Choi-sungjin/pa_craft/presentations/GripperController 발표.pptx

## GripperController

craft_control · 코드 발표

전류 기반 파지 감지를 갖춘 그리퍼 목표 각도 제어기

src/craft_control/src/gripper_controller.cpp · 100줄

[발표자] · 2026-10-18

Notes: 오늘은 craft_control 패키지의 GripperController를 소개합니다. 100줄 정도의 작은 클래스지만, 그리퍼를 열고 닫는 목표 각도 계산과, 모터 전류로 물체를 잡았는지 판단하는 파지 감지를 함께 담당합니다.

## 명령과 피드백, 두 갈래 흐름

역할

명령 경로

/planning/gripper_command

std_msgs/Bool · true = 닫기, false = 열기

피드백 경로

arm OpenCR 피드백

gripper 각도 + gripper_current_a [A]

set_target(close)

열기/닫기 목표 각도 선택

update_current_feedback()

과전류 지속 시간 누적

compute_gripper_command()

범위로 clamp한 목표 각도

is_grasped()

물체를 잡았는지 판정

arm OpenCR

6번째(마지막) 채널로 전송

/gripper_grasped

std_msgs/Bool 발행

GripperController

2

Notes: 그리퍼 제어기는 두 갈래 흐름을 가집니다. 왼쪽 명령 경로는 planning이 Bool로 열기/닫기를 보내면 set_target이 목표 각도를 고르고, 제어 루프가 compute_gripper_command로 각도를 계산해 arm OpenCR의 마지막 채널로 보냅니다. 오른쪽 피드백 경로는 OpenCR이 보내는 그리퍼 전류를 누적해서 물체를 잡았는지 판단하고, 그 결과를 /gripper_grasped로 발행합니다. 클래스 자체는 ROS 의존성이 없는 순수 C++이고, 토픽과 시리얼 처리는 모두 control_master가 맡습니다.

## 메서드 7개, ROS 의존성 없음

공개 API

메서드

역할

호출하는 곳

configure(…)

set_target(close)

각도 범위·목표·감지 파라미터 검증 후 저장

열기/닫기 목표 각도 선택

노드 생성자

구독 콜백

compute_gripper_command(angle)

모터로 보낼 목표 각도 계산

제어 루프

update_current_feedback(I, dt)

is_grasped()

과전류 지속 시간 누적

파지 여부 조회

제어 루프

제어 루프

grasp_detection_configured()

파지 감지 활성 여부

생성자 (경고 로그)

is_target_reached(angle, tol)

목표 각도 도달 판정

아직 미사용

GripperController

3

Notes: 공개 메서드는 7개입니다. configure로 한 번 설정하고, set_target으로 목표를 바꾸고, 제어 루프에서 compute_gripper_command, update_current_feedback, is_grasped를 매 주기 호출하는 구조입니다. is_target_reached는 구현돼 있지만 control_master에서는 아직 호출하지 않습니다. 헤더에 include가 하나도 없을 만큼 ROS와 분리돼 있어서 단위 테스트하기 쉽습니다.

## 잘못된 설정은 시작 단계에서 막는다

configure()

검증 규칙

- 6개 입력 모두 유한한 값 (NaN, inf 거부)
- min_angle < max_angle
- open_angle, close_angle은 [min, max] 안
- threshold ≥ 0, debounce ≥ 0
- 감지 파라미터는 둘 다 0(비활성) 또는 둘 다 > 0(활성)

→ 한쪽만 0인 “반쯤 켜진” 감지 설정은 거부

실패하면

configure()가 false를 반환하고, control_master가 runtime_error로 노드 기동을 중단

상태부터 초기화

검증 전에 configured_ = false, has_target_ = false. 실패해도 이전 설정이 남지 않음

GripperController

4

Notes: configure는 YAML 파라미터 6개를 받아 검증합니다. 모든 값이 유한해야 하고, 최소 각도가 최대 각도보다 작아야 하며, 열기/닫기 각도는 그 범위 안에 있어야 합니다. 흥미로운 규칙은 마지막인데, 전류 임계값과 debounce 시간은 둘 다 0이면 감지 비활성, 둘 다 양수면 활성이고, 한쪽만 설정된 경우는 실수로 보고 거부합니다. 또 검증 전에 configured_ 플래그를 먼저 false로 내려서, 실패했을 때 예전 값으로 계속 동작하는 일이 없습니다. 실패하면 control_master가 예외를 던져 노드가 아예 뜨지 않습니다.

## 방향이 바뀔 때만 감지 상태를 리셋

set_target()

bool set_target(bool close)
{
if (!configured_) {
return false;
}
if (!has_target_ || closing_ != close) {
overcurrent_time_ = 0.0;
grasped_ = false;
}
target_angle_ = close ? close_angle_
: open_angle_;
closing_ = close;
has_target_ = true;
return true;
}

첫 목표 / 방향 전환

과전류 누적 시간과 grasped를 0으로 리셋

같은 명령 반복

상태 유지. planning이 “닫기”를 계속 보내도 grasped가 깜빡이지 않음

설정 전 호출

false 반환 → 구독 콜백이 경고 로그

GripperController

5

Notes: set_target은 Bool 하나를 받아 열기 각도나 닫기 각도 중 하나를 목표로 정합니다. 핵심은 주황색 부분입니다. 처음 목표가 들어오거나 열기에서 닫기처럼 방향이 바뀔 때만 파지 감지 상태를 리셋합니다. 그래서 planning이 같은 닫기 명령을 주기적으로 계속 보내더라도, 이미 잡았다고 판단한 상태가 매번 초기화되지 않습니다.

## 모르면 제자리, 알면 범위 안으로

각도 명령

compute_gripper_command()

if (!configured_) return current;
req = has_target_ ? target_angle_
: current;
return clamp(req, min_, max_);

- 설정 전 → 현재 각도 그대로
- 목표 없음 → 현재 각도 (움직이지 않음)
- 항상 [min, max]로 clamp

is_target_reached()

|angle − target_angle_| ≤ tol

- 설정 전 · 목표 없음 → false
- NaN 각도, 음수 tol → false
- control_master에서 아직 호출하지 않음

GripperController

6

Notes: 모터로 보낼 각도를 계산하는 부분입니다. 설정이 안 됐거나 아직 목표가 없으면 현재 측정 각도를 그대로 돌려줍니다. 즉 모르는 상황에서는 그리퍼가 움직이지 않습니다. 목표가 있으면 항상 최소·최대 각도로 clamp해서 범위를 넘는 명령이 나가지 않게 합니다. 오른쪽 is_target_reached는 허용 오차 안에 들어왔는지 판단하는 함수인데, 잘못된 입력은 모두 false로 처리하고, 현재는 제어 루프에서 사용하지 않습니다.

## 과전류가 debounce 이상 지속되면 “잡았다”

update_current_feedback()

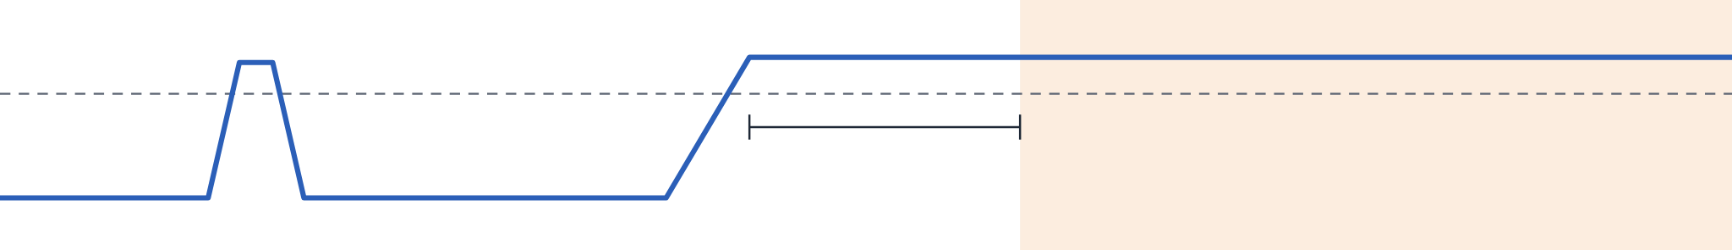
[picture p1: figure]
모터 전류 그래프: 짧은 스파이크는 무시되고, 임계값을 debounce 시간 이상 넘으면 grasped가 참이 된다

짧은 스파이크

threshold

debounce

grasped = true

시간 →

짧은 스파이크

누적 < debounce → 무시
(기동 전류 같은 순간 피크)

지속 과전류

overcurrent_time_ += dt
≥ debounce → grasped = true

임계 아래로 하락

누적 0으로 리셋
grasped 즉시 false

감지 조건: 닫는 중 · 감지 활성 · 전류와 dt가 유한 · dt > 0 (아니면 아무것도 안 함)

GripperController

7

Notes: 이 클래스에서 가장 중요한 로직입니다. 그리퍼가 물체를 잡으면 더 닫히지 못하고 모터 전류가 올라갑니다. 그래서 전류 절댓값이 임계값 이상인 시간을 dt씩 누적하고, 누적 시간이 debounce 이상이 되면 잡았다고 판단합니다. 그래프 왼쪽처럼 모터 기동 순간의 짧은 피크는 debounce를 못 넘기 때문에 무시됩니다. 전류가 임계값 아래로 떨어지면 누적 시간과 grasped를 즉시 리셋합니다. 이 감지는 닫는 중이고, 감지가 활성화돼 있고, 입력이 유효할 때만 동작합니다.

## 20 ms 제어 주기 안에서의 호출 순서

control_master 통합

구독 콜백 (비동기)

/planning/gripper_command 수신 → gripper_mapping_confirmed일 때만 set_target()

0

1

2

3

read_arm_feedback()

CSV 8개 값: state, LM, 관절 4개, gripper 각도, gripper 전류

새 피드백이 있을 때만

update_current_feedback(I, dt) → is_grasped()를 /gripper_grasped로 발행

매 주기

compute_gripper_command(gripper_angle_) → arm OpenCR에 LM, 관절 4개와 함께 전송

GripperController

8

Notes: control_master에서 어떻게 쓰이는지 보겠습니다. 명령은 구독 콜백에서 들어오는데, gripper_mapping_confirmed 파라미터가 false면 아예 무시합니다. 하드웨어 채널 매핑이 확인되기 전까지 그리퍼가 움직이지 않게 하는 안전장치입니다. 제어 루프는 arm OpenCR 피드백을 읽고, 새 피드백이 있을 때만 전류를 넣어 파지 상태를 갱신해 발행합니다. 마지막으로 그리퍼 목표 각도를 계산해 LM, 관절 4개와 함께 한 줄로 OpenCR에 보냅니다. 그리퍼 제어기는 다른 제어기와 독립적이고, 시리얼 채널만 공유합니다.

## 코드는 준비, 하드웨어 보정 대기 중

현재 상태

control.yaml 현재 값

gripper_min/max_angle

±3.14

임시 범위

확인할 점

- arm 피드백은 정확히 8개 값이어야 함. 펌웨어가 전류를 아직 안 보내면 피드백 전체가 거부됨
- dt는 루프 주기 기준. 피드백이 매 주기 오지 않으면 과전류 시간이 짧게 누적됨
- GripperController 단위 테스트 없음
- is_target_reached() 미사용

gripper_open/close_angle

0 / 0

미측정

gripper_mapping_confirmed

grasp_current_threshold_a

false

0.0

명령 무시

감지 비활성

grasp_current_debounce

0.0

감지 비활성

GripperController

9

Notes: 현재 설정 상태입니다. 열기·닫기 각도가 둘 다 0이고 매핑 확인 플래그가 false라서, 지금은 그리퍼 명령이 실제로 나가지 않습니다. 전류 감지 파라미터도 0이라 감지가 꺼져 있습니다. 하드웨어 측정 후 값을 채우는 것이 다음 단계입니다. 오른쪽은 코드를 읽으며 확인이 필요하다고 본 부분입니다. 첫째, control_master는 arm 피드백 줄에 정확히 8개 값을 요구하는데, YAML 주석에는 전류 값을 아직 펌웨어에 추가해야 한다는 TODO가 있습니다. 펌웨어가 7개만 보내면 arm 피드백 전체가 버려집니다. 둘째, update_current_feedback에 루프 dt를 넘기는데 호출은 새 피드백이 있을 때만 하므로, 피드백이 띄엄띄엄 오면 누적 시간이 실제보다 짧아집니다. 셋째, 테스트 파일에 그리퍼 테스트가 아직 없습니다.

## 작지만 안전하게 설계된 제어기

정리

검증 우선

잘못된 설정은 노드 기동 단계에서 차단

안전한 기본값

모르면 현재 위치 유지, 항상 범위 안으로 clamp

노이즈에 강한 감지

과전류 지속 시간으로 파지 판정

Q&A

GripperController

10

Notes: 정리하면 세 가지입니다. 설정은 시작할 때 엄격하게 검증하고, 모르는 상황에서는 움직이지 않으며, 파지 감지는 순간 피크가 아닌 지속 시간으로 판단합니다. 다음 단계는 하드웨어 측정으로 각도와 전류 임계값을 채우고, 그리퍼 단위 테스트를 추가하는 것입니다. 질문 받겠습니다.
