Choi-sungjin/pa_craft/presentations/longitudinal_controller_presentation.pptx

longitudinal_controller.cpp

차체 목표 속도를 좌우 바퀴 각속도로 변환

craft_control 코드 발표

Notes: 이 파일은 직진 성분의 바퀴 속도를 계산한다. 실제 회전 성분은 LateralController가 뒤에서 더한다.

코드 근거:
src/craft_control/src/longitudinal_controller.cpp
src/craft_control/src/control_master.cpp:636-649

## Slide 2

01 역할

입력과 출력

목표 차체 속도

좌우 바퀴 각속도

target_v [m/s]

{left, right} [rad/s]

전진은 양수, 후진은 음수

직진 성분이므로 두 값은 같음

설정값: wheel_radius [m], max_v [m/s]

configure()가 두 값을 저장하고, compute_command()가 변환에 사용

Notes: 입력 target_v_는 목표 차체 선속도다. 출력은 좌우 바퀴의 각속도 배열이다. 이 클래스는 동일한 좌우 값을 만들어 직진 성분만 담당한다. 설정의 기본값은 반지름 0.033m, 최대 차체 속도 0.26m/s다.

코드 근거:
src/craft_control/include/craft_control/longitudinal_controller.hpp:9-28
src/craft_control/config/control.yaml:13-15

## Slide 3

02 핵심 계산

속도 제한과 단위 변환

limited_v = clamp(target_v, -max_v, max_v)

wheel_speed = limited_v / wheel_radius

return {wheel_speed, wheel_speed}

설정 예시

목표 1.00 m/s → 제한 0.26 m/s

0.26 ÷ 0.033 ≈ 7.88 rad/s (좌우 동일)

Notes: std::clamp는 목표 선속도를 -max_v부터 +max_v까지 제한한다. 바퀴 반지름으로 나누면 선속도 m/s가 바퀴 각속도 rad/s로 바뀐다. 목표 1m/s는 기본 최대 속도 0.26m/s로 제한되므로 약 7.88rad/s가 된다. 계산값은 반올림했다.

코드 근거:
src/craft_control/src/longitudinal_controller.cpp:29-35
src/craft_control/config/control.yaml:13-15

## Slide 4

03 코드 읽기

함수별 동작

configure(radius, max_v)

is_valid_target(v)

set_target(v)

clear_target()

compute_command()

바퀴 반지름과 최대 속도를 저장

NaN·무한대가 아닌 유한한 수인지 확인

목표 속도를 저장

목표 속도를 0으로 초기화

제한·변환 후 {왼쪽, 오른쪽} 반환

Notes: is_valid_target는 std::isfinite만 검사한다. set_target 자체에는 검사 코드가 없으므로 ControlMaster가 먼저 유효성을 검사하는 흐름이다. clear_target은 저장값을 0으로 만든다.

코드 근거:
src/craft_control/src/longitudinal_controller.cpp:9-35
src/craft_control/src/control_master.cpp:426-445

## Slide 5

04 시스템 흐름

ControlMaster와의 연결

1 /planning/target_v에서 목표 선속도 수신

2 유한한 값인지 검사하고 목표값 저장

3 경로를 추종할 수 있으면 set_target(), 아니면 clear_target()

4 compute_command()로 좌우 직진 성분 계산

5 LateralController의 회전 성분을 더한 뒤 바퀴 한계 적용

6 최종 바퀴 명령을 OpenCR로 전송

Notes: LongitudinalController는 최종 바퀴 명령 전체를 혼자 만들지 않는다. ControlMaster가 경로 추종 가능 여부를 확인하고, 직진 성분을 계산한 후 LateralController의 회전 성분을 더한다. 이후 max_wheel_을 넘으면 양쪽을 같은 비율로 줄여 OpenCR에 보낸다.

코드 근거:
src/craft_control/src/control_master.cpp:237-239
src/craft_control/src/control_master.cpp:426-445
src/craft_control/src/control_master.cpp:636-651

## Slide 6

05 정리

발표에서 짚을 구현 범위

직진 성분

좌우에 같은 속도를 준다. 회전 계산은 별도 컨트롤러가 맡는다.

정지 조건

경로가 유효하지 않거나 목표에 도착하면 ControlMaster가 목표를 0으로 지운다.

모터 제어

가속 프로파일·속도 PID는 OpenCR과 DYNAMIXEL 쪽 책임이다.

Notes: 이 클래스는 목표값 제한과 단위 변환만 수행한다. 가속 램프나 PID는 이 파일에 없다. 코드와 README에 따르면 OpenCR 펌웨어 및 DYNAMIXEL이 속도 추종과 가속 프로파일을 담당한다. 테스트는 목표 1.0m/s를 0.26m/s로 제한하는 경우, 좌우 동일, clear_target 후 0을 확인한다.

코드 근거:
src/craft_control/src/longitudinal_controller.cpp:29-35
src/craft_control/include/craft_control/longitudinal_controller.hpp:1-3
src/craft_control/src/control_master.cpp:636-651
src/craft_control/test/test_control_controllers.cpp:300-318
