Choi-sungjin/pa_craft/demo/corner/planned_paths.png

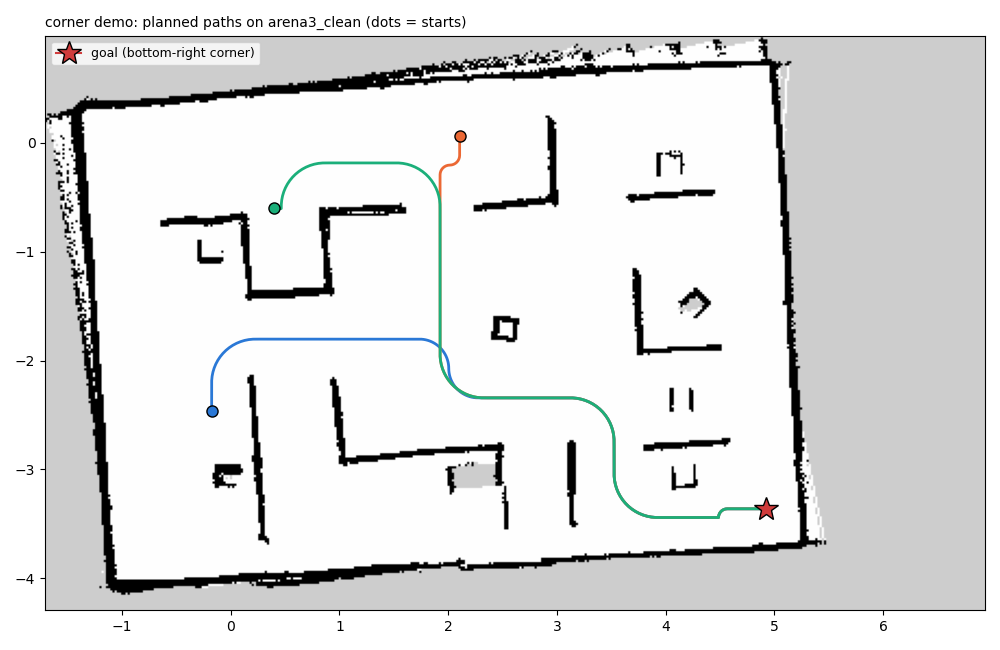
demo/corner/planned_paths.png
