Choi-sungjin/pa_craft/src/craft_planning/maps/maze.stl

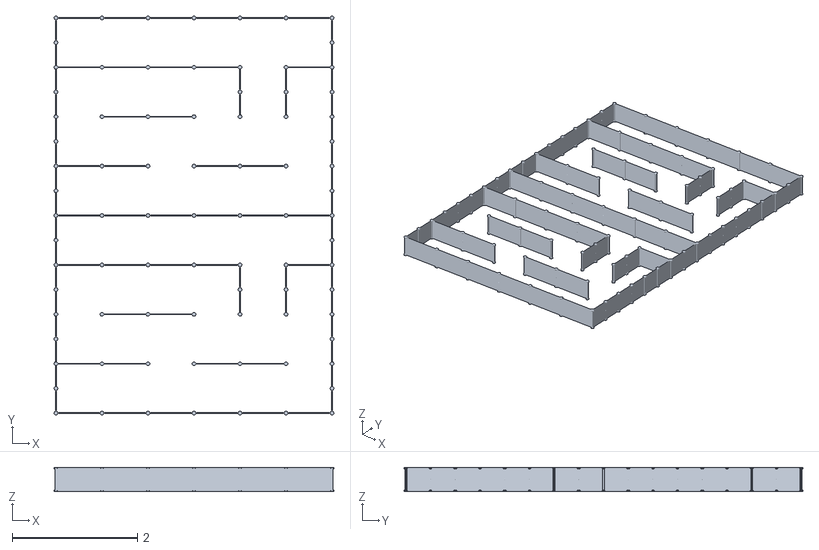
[picture p3: CAD file, 2026-10-18]
src/craft_planning/maps/maze.stl
4.46 x 6.36 x 0.39
