Choi-sungjin/pa_craft/src/craft_planning/v75_ws/src/v75_robot_description/meshes/jaw_lower_link_black.stl

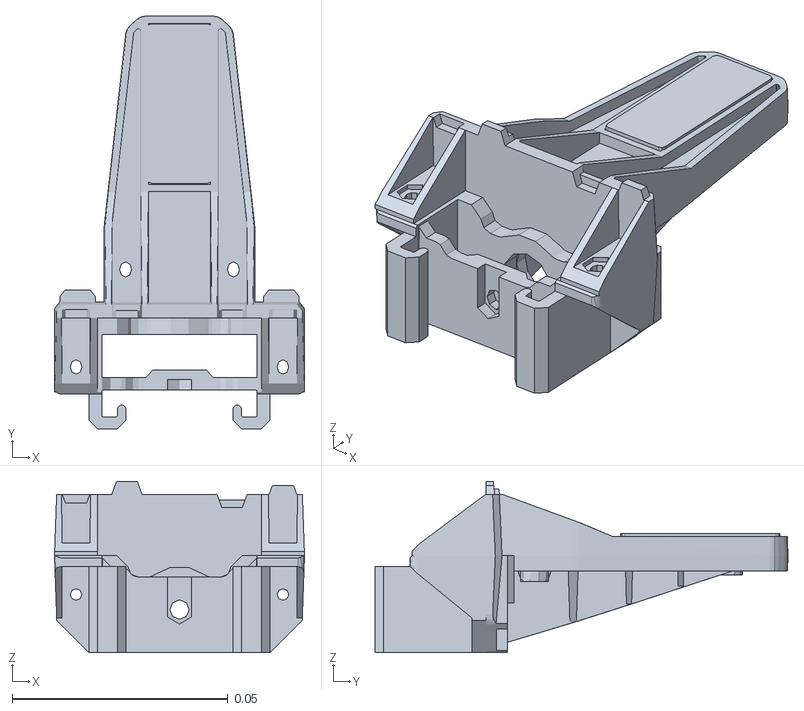
[picture p4: CAD file, 2026-11-11]
src/craft_planning/v75_ws/src/v75_robot_description/meshes/jaw_lower_link_black.stl
0.058 x 0.0958 x 0.0397
