Choi-sungjin/pa_craft/src/craft_planning/v75_ws/src/v75_robot_description/meshes/jaw_lower_link_orange.stl

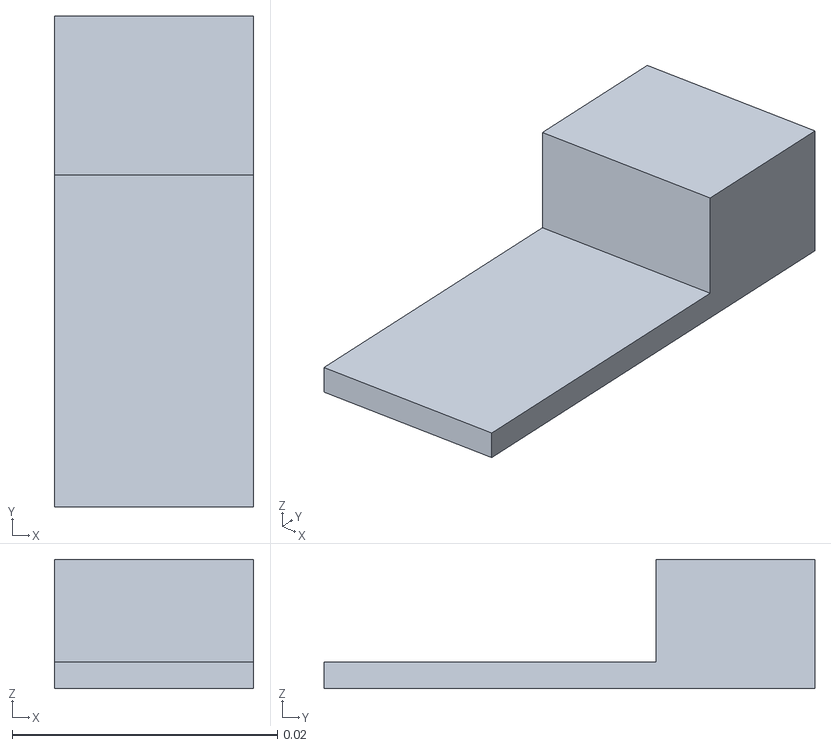
[picture p5: CAD file, 2026-11-11]
src/craft_planning/v75_ws/src/v75_robot_description/meshes/jaw_lower_link_orange.stl
0.015 x 0.037 x 0.00975
