Choi-sungjin/pa_craft/src/craft_planning/v75_ws/src/v75_robot_description/meshes/shoulder_link_green.stl

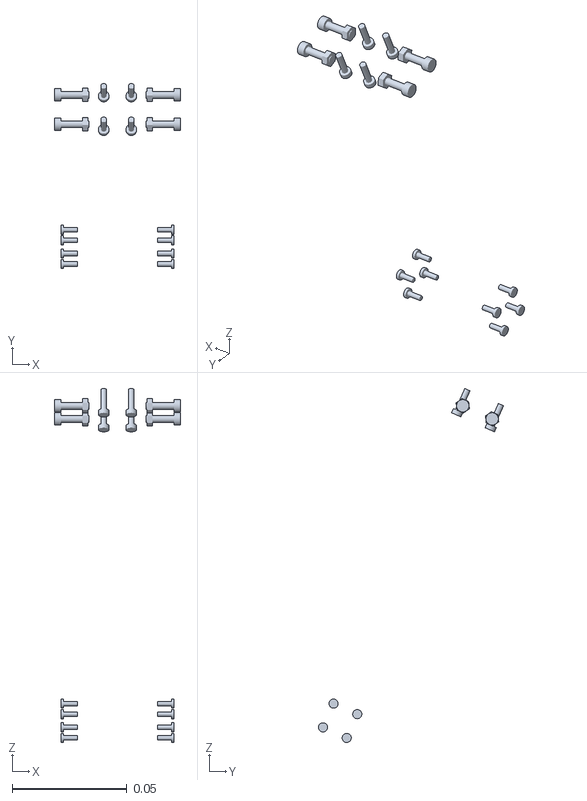
[picture p6: CAD file, 2026-11-11]
src/craft_planning/v75_ws/src/v75_robot_description/meshes/shoulder_link_green.stl
0.055 x 0.0807 x 0.154
