Choi-sungjin/pa_craft/src/craft_planning/v75_ws/src/v75_robot_description/meshes/base_link_orange.stl

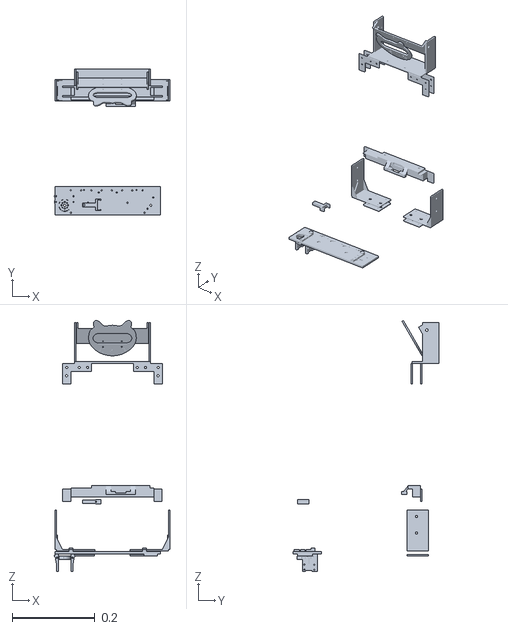
[picture p7: CAD file, 2026-11-11]
src/craft_planning/v75_ws/src/v75_robot_description/meshes/base_link_orange.stl
0.279 x 0.354 x 0.607
