Choi-sungjin/pa_craft/src/craft_planning/v75_ws/src/v75_robot_description/meshes/base_link_green.stl

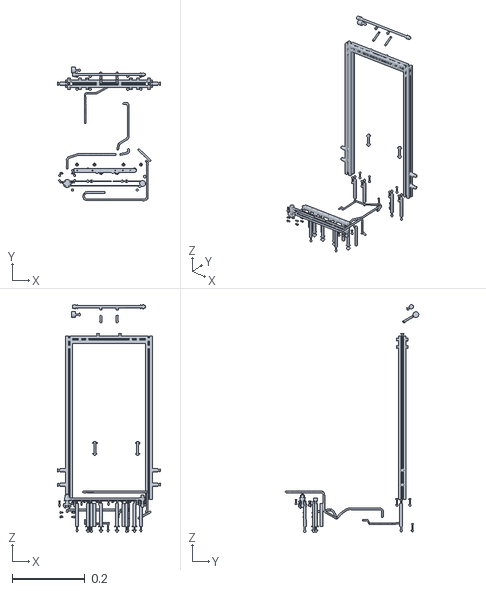
[picture p8: CAD file, 2026-11-11]
src/craft_planning/v75_ws/src/v75_robot_description/meshes/base_link_green.stl
0.283 x 0.368 x 0.628
