Choi-sungjin/pa_craft/src/craft_planning/v75_ws/src/v75_robot_description/meshes/base_link_black.stl

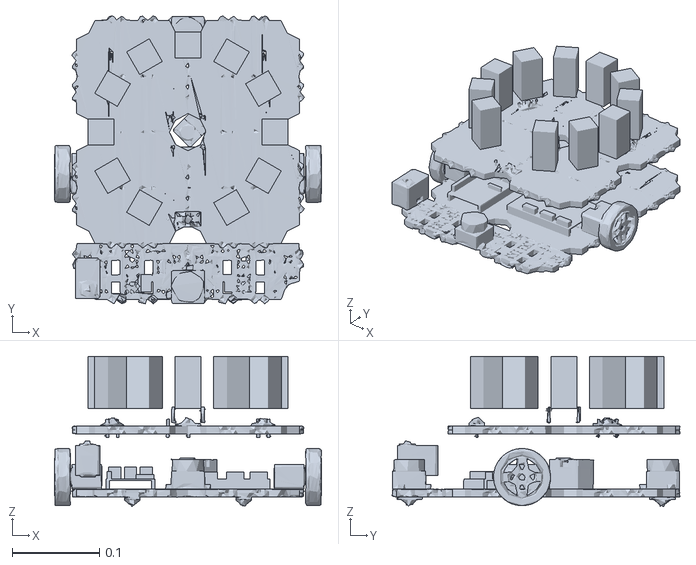
[picture p9: CAD file, 2026-11-11]
src/craft_planning/v75_ws/src/v75_robot_description/meshes/base_link_black.stl
0.306 x 0.33 x 0.173
