Choi-sungjin/pa_craft/src/craft_planning/v75_ws/src/v75_robot_description/meshes/shoulder_link_black.stl

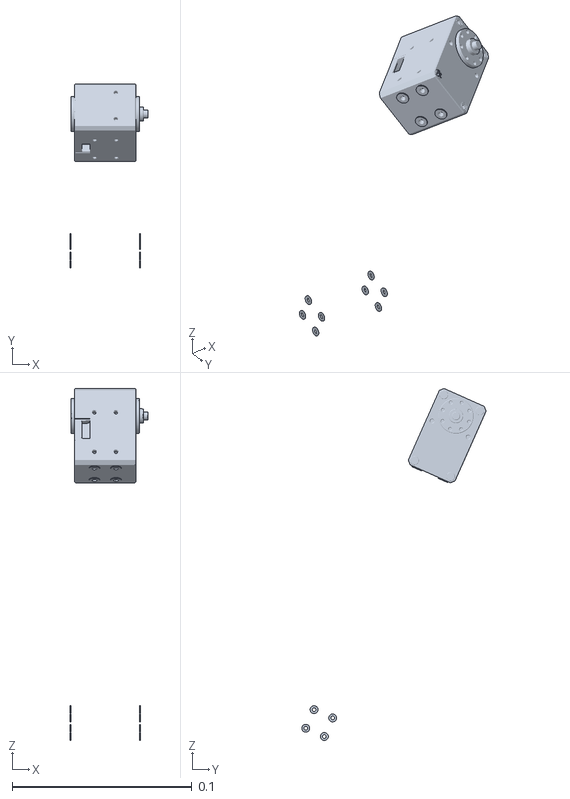
[picture p10: CAD file, 2026-11-11]
src/craft_planning/v75_ws/src/v75_robot_description/meshes/shoulder_link_black.stl
0.0432 x 0.103 x 0.196
