Choi-sungjin/pa_craft/src/craft_planning/v75_ws/src/v75_robot_description/meshes/wrist_pitch_link_black.stl

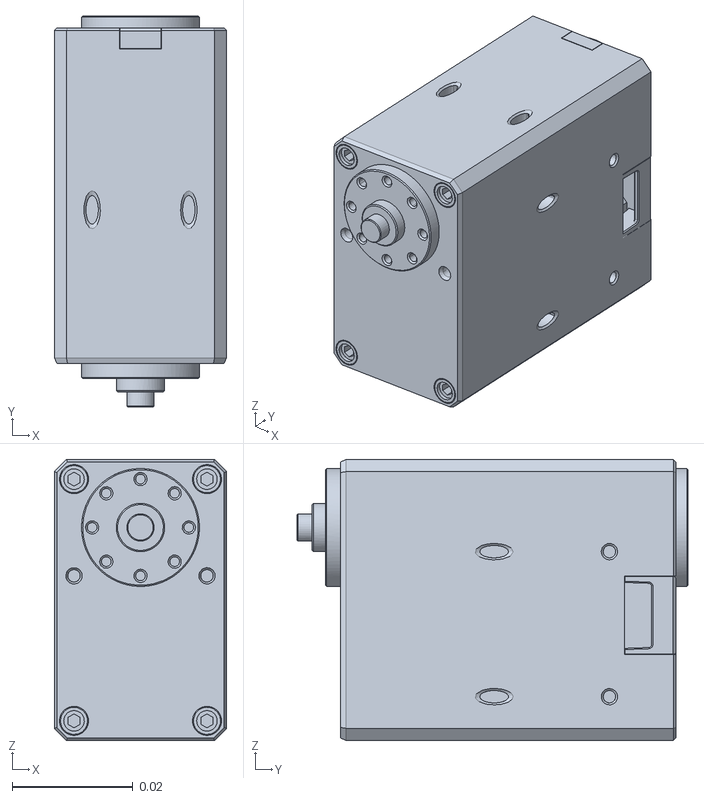
[picture p11: CAD file, 2026-11-11]
src/craft_planning/v75_ws/src/v75_robot_description/meshes/wrist_pitch_link_black.stl
0.0285 x 0.0647 x 0.0465
