Choi-sungjin/pa_craft/src/craft_planning/v75_ws/src/v75_robot_description/meshes/wrist_pitch_link_orange.stl

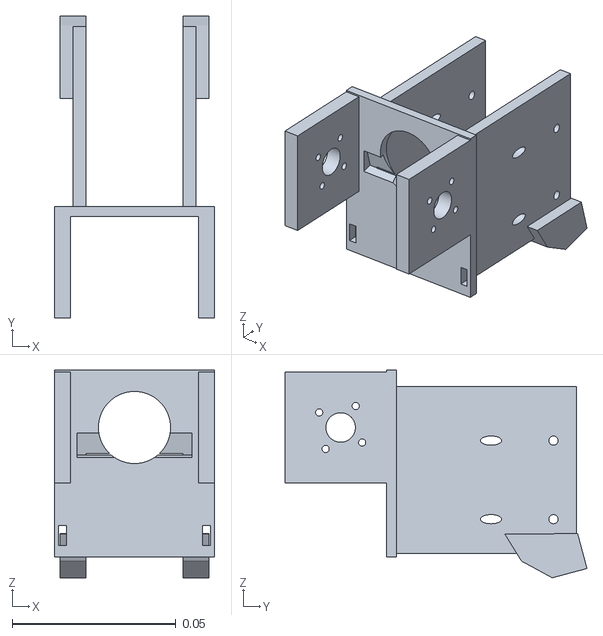
[picture p12: CAD file, 2026-11-11]
src/craft_planning/v75_ws/src/v75_robot_description/meshes/wrist_pitch_link_orange.stl
0.049 x 0.0922 x 0.0634
