Choi-sungjin/pa_craft/src/craft_planning/v75_ws/src/v75_robot_description/meshes/elbow_link_black.stl

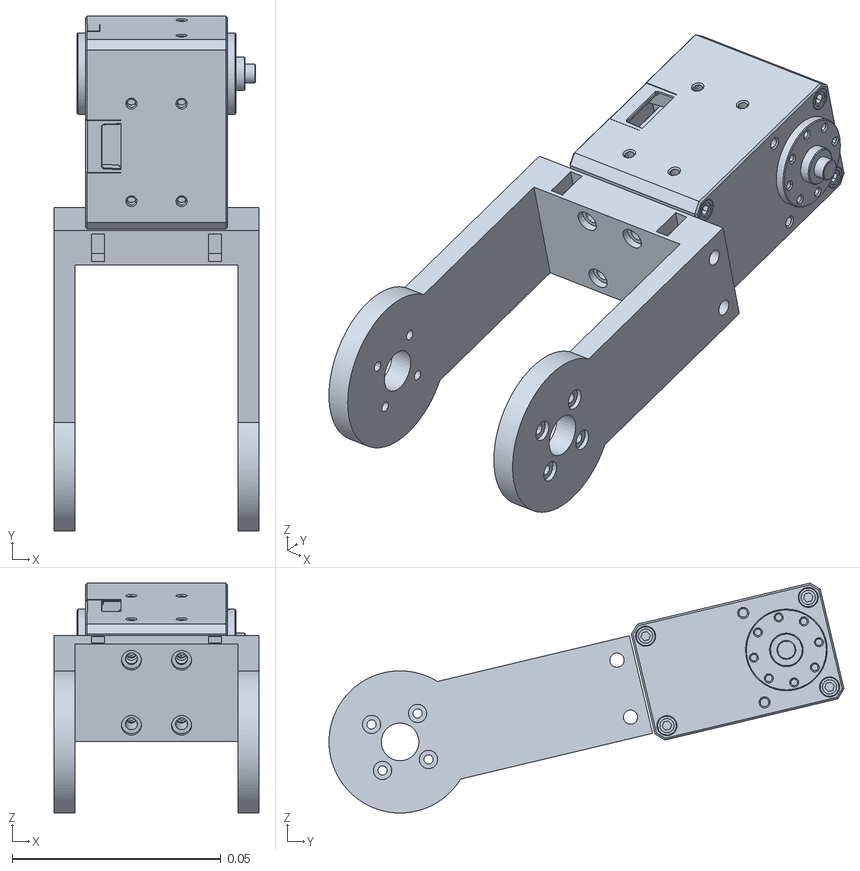
[picture p13: CAD file, 2026-11-11]
src/craft_planning/v75_ws/src/v75_robot_description/meshes/elbow_link_black.stl
0.049 x 0.123 x 0.055
