Choi-sungjin/pa_craft/src/craft_planning/v75_ws/src/v75_robot_description/meshes/slide_link_orange.stl

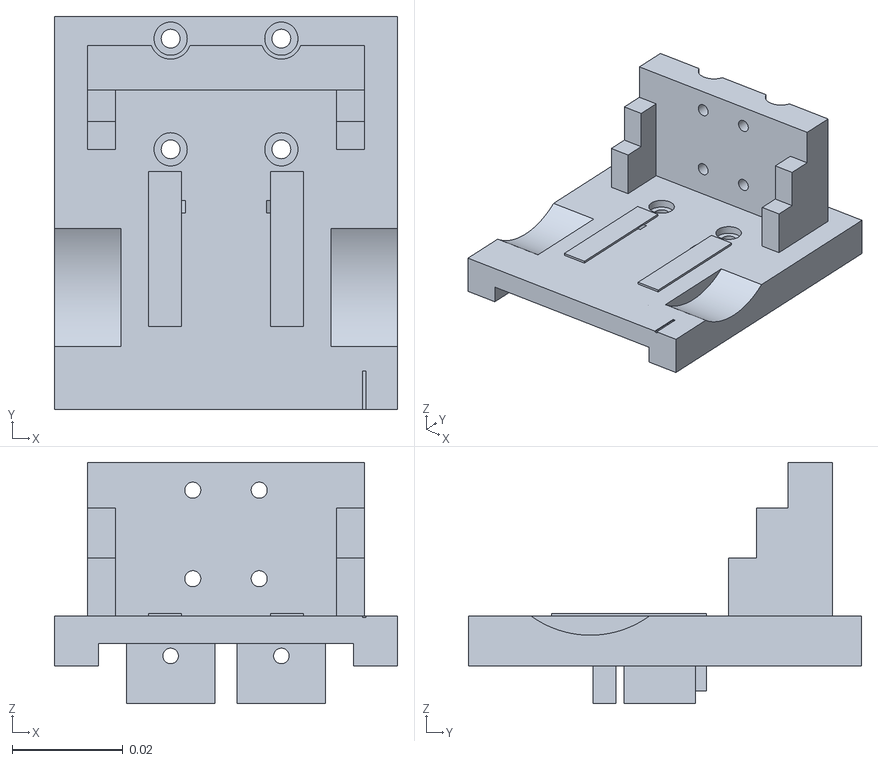
[picture p15: CAD file, 2026-10-22]
src/craft_planning/v75_ws/src/v75_robot_description/meshes/slide_link_orange.stl
0.062 x 0.071 x 0.0435
