Choi-sungjin/pa_craft/src/craft_planning/v75_ws/src/v75_robot_description/meshes/carousel_link_orange.stl

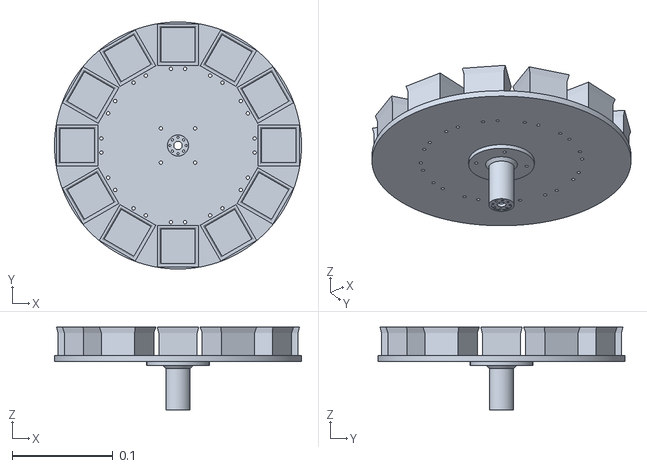
[picture p16: CAD file, 2026-10-22]
src/craft_planning/v75_ws/src/v75_robot_description/meshes/carousel_link_orange.stl
0.245 x 0.245 x 0.0821
