Choi-sungjin/pa_craft/src/craft_planning/v75_ws/src/v75_robot_description/meshes/knob_link_red.stl

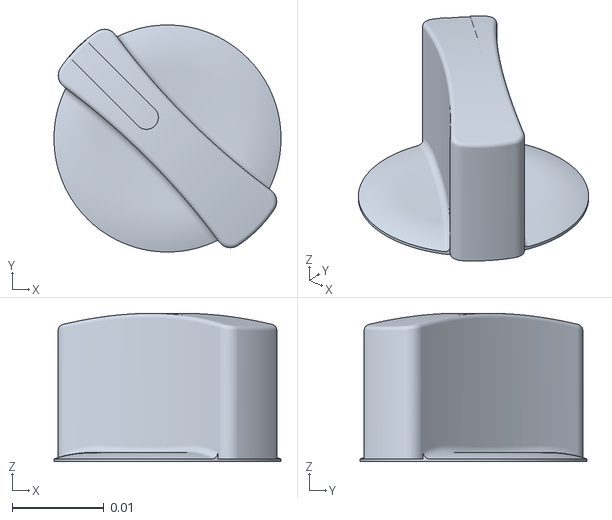
[picture p17: CAD file, 2026-10-22]
src/craft_planning/v75_ws/src/v75_robot_description/meshes/knob_link_red.stl
0.0248 x 0.0248 x 0.0162
