Choi-sungjin/pa_craft/src/craft_planning/v75_ws/src/v75_robot_description/meshes/slide_link_green.stl

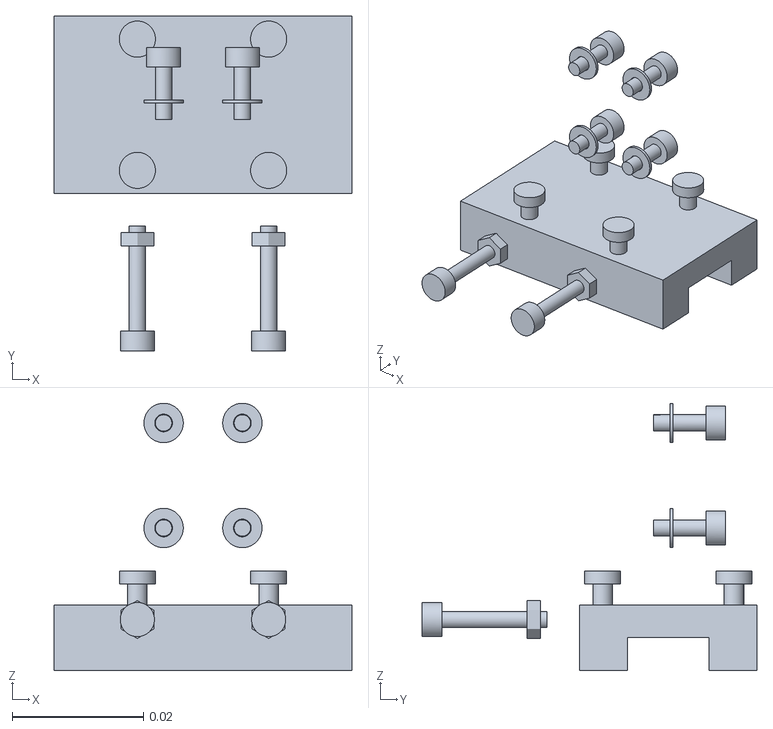
[picture p18: CAD file, 2026-10-22]
src/craft_planning/v75_ws/src/v75_robot_description/meshes/slide_link_green.stl
0.0454 x 0.051 x 0.0407
