Choi-sungjin/pa_craft/src/craft_planning/v75_ws/src/v75_robot_description/meshes/tool_roll_link_black.stl

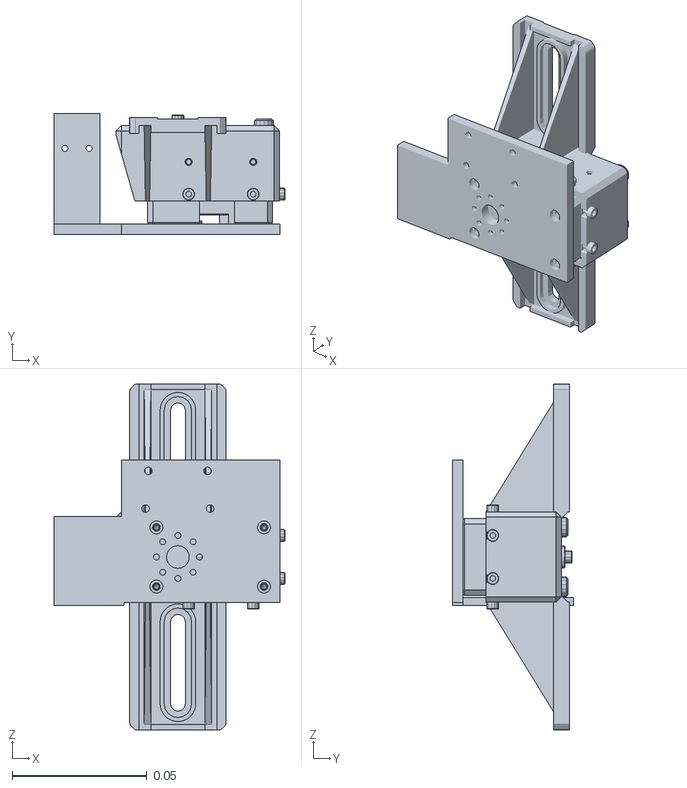
[picture p19: CAD file, 2026-10-22]
src/craft_planning/v75_ws/src/v75_robot_description/meshes/tool_roll_link_black.stl
0.0857 x 0.045 x 0.129
