Choi-sungjin/pa_craft/src/craft_planning/v75_ws/src/v75_robot_description/meshes/tool_roll_link_green.stl

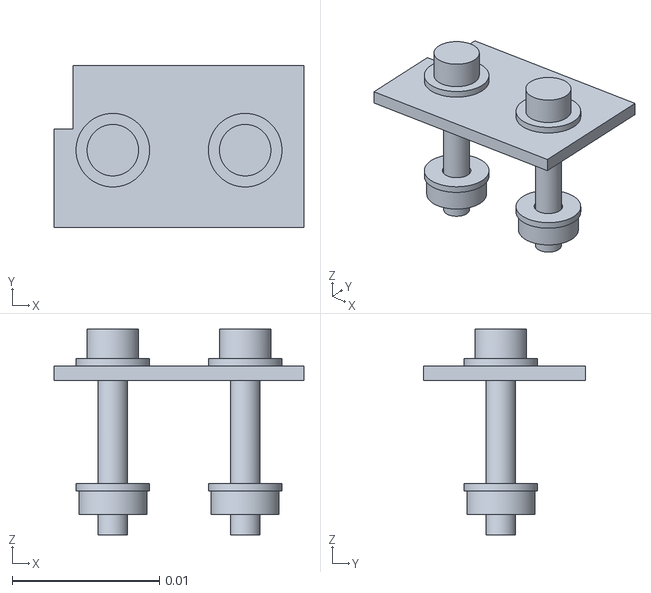
[picture p20: CAD file, 2026-10-22]
src/craft_planning/v75_ws/src/v75_robot_description/meshes/tool_roll_link_green.stl
0.017 x 0.011 x 0.014
