Choi-sungjin/pa_craft/src/craft_planning/v75_ws/src/v75_robot_description/meshes/tool_roll_link_orange.stl

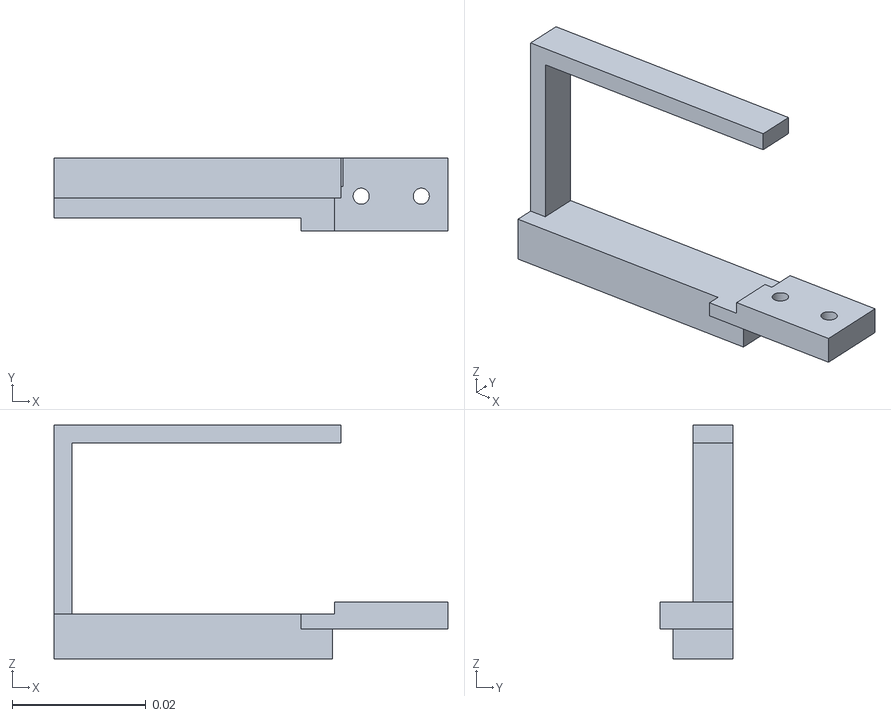
[picture p21: CAD file, 2026-10-22]
src/craft_planning/v75_ws/src/v75_robot_description/meshes/tool_roll_link_orange.stl
0.059 x 0.011 x 0.035
