Choi-sungjin/pa_craft/src/craft_planning/v75_ws/src/v75_robot_description/meshes/slide_link_gray.stl

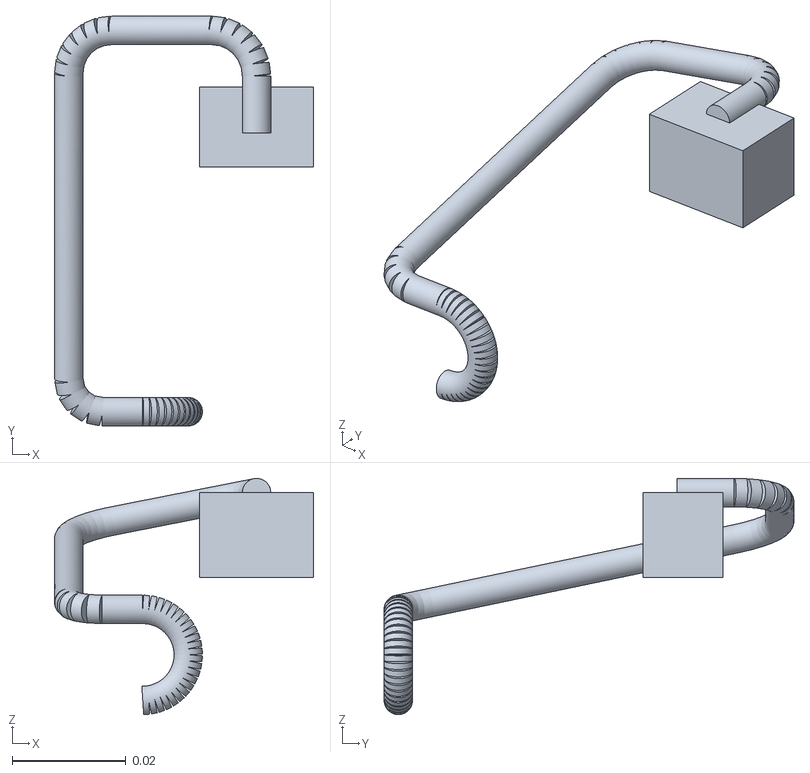
[picture p22: CAD file, 2026-10-22]
src/craft_planning/v75_ws/src/v75_robot_description/meshes/slide_link_gray.stl
0.0455 x 0.072 x 0.0415
