Choi-sungjin/pa_craft/src/craft_planning/v75_ws/src/v75_robot_description/meshes/slide_link_black.stl

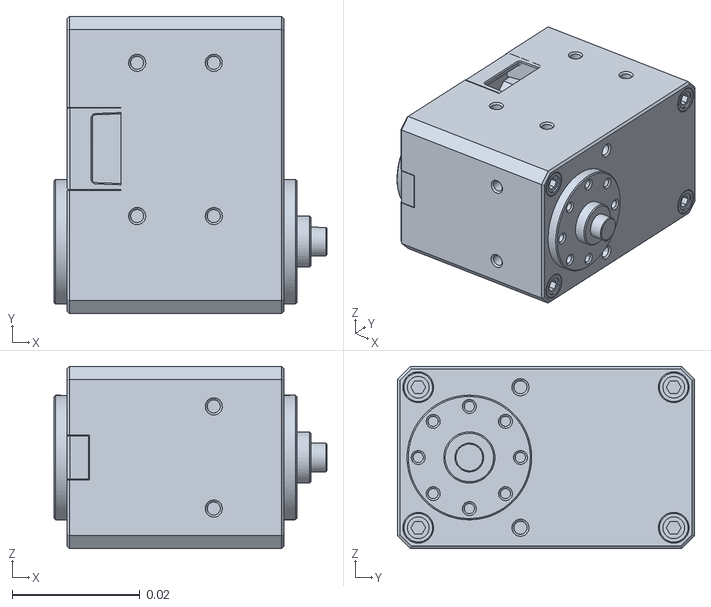
[picture p23: CAD file, 2026-10-22]
src/craft_planning/v75_ws/src/v75_robot_description/meshes/slide_link_black.stl
0.0427 x 0.0465 x 0.0285
