Choi-sungjin/pa_craft/src/craft_planning/v75_ws/src/v75_robot_description/meshes/base_link_yellow.stl

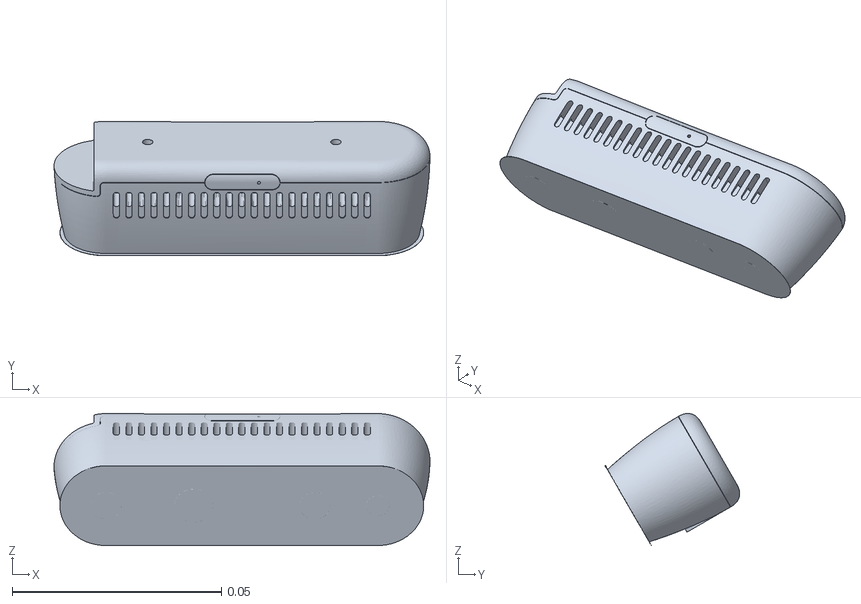
[picture p24: CAD file, 2026-10-22]
src/craft_planning/v75_ws/src/v75_robot_description/meshes/base_link_yellow.stl
0.0899 x 0.0322 x 0.0316
