Choi-sungjin/pa_craft/src/craft_planning/v75_ws/src/v75_robot_description/meshes/carousel_link_black.stl

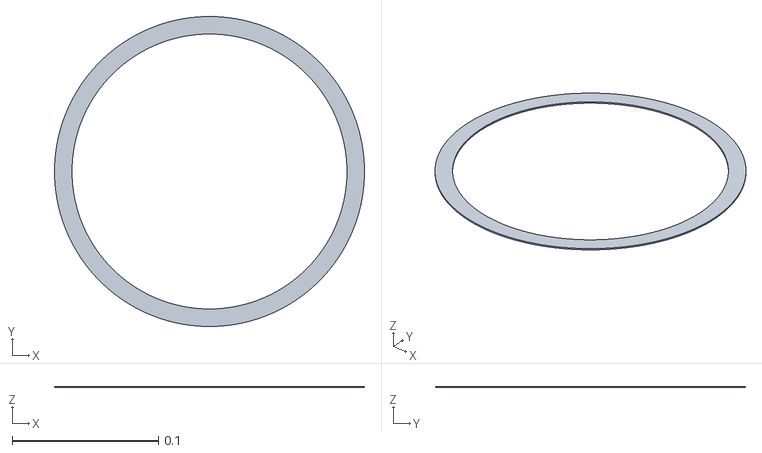
[picture p25: CAD file, 2026-10-22]
src/craft_planning/v75_ws/src/v75_robot_description/meshes/carousel_link_black.stl
0.212 x 0.212 x 0.001
