Choi-sungjin/pa_craft/src/craft_planning/v75_ws/src/v75_robot_description/meshes/knob_station_black.stl

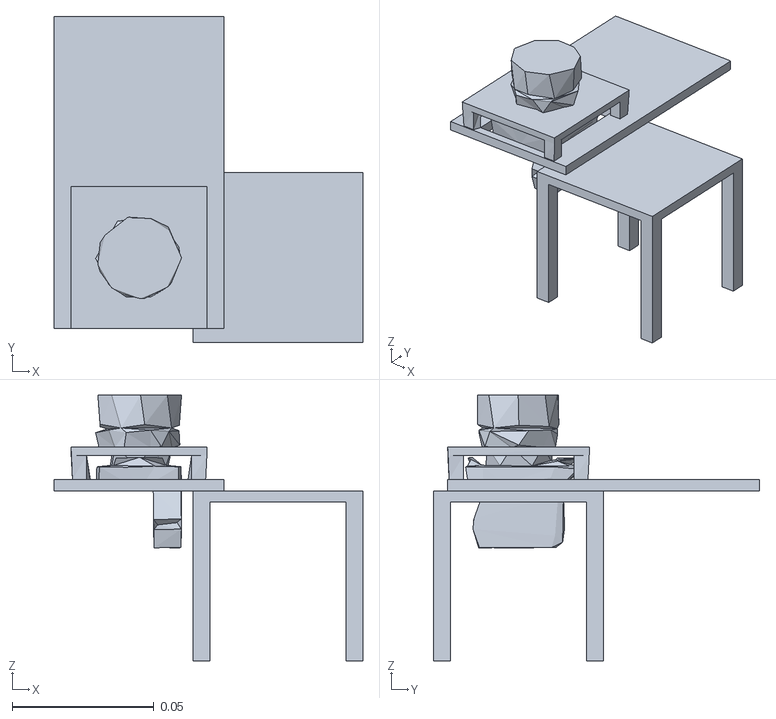
[picture p26: CAD file, 2026-10-22]
src/craft_planning/v75_ws/src/v75_robot_description/meshes/knob_station_black.stl
0.109 x 0.115 x 0.0938
