Choi-sungjin/pa_craft/src/craft_planning/v75_ws/src/v75_robot_description/meshes/carousel_link_green.stl

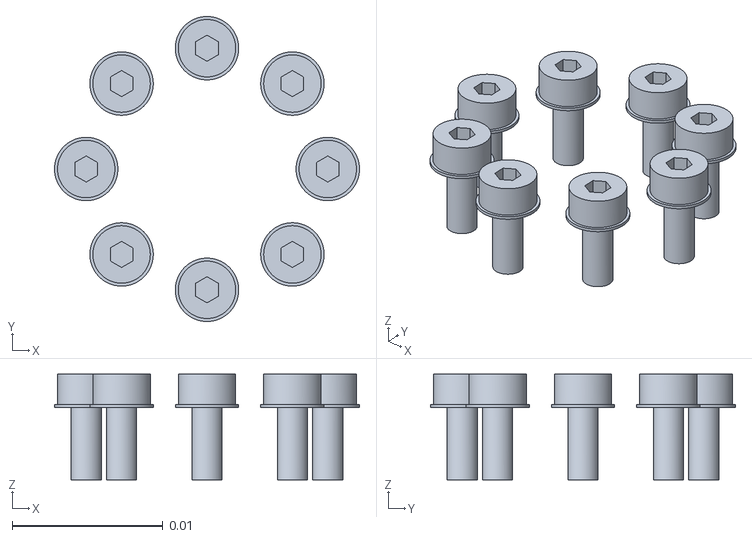
[picture p27: CAD file, 2026-10-22]
src/craft_planning/v75_ws/src/v75_robot_description/meshes/carousel_link_green.stl
0.0202 x 0.0202 x 0.007
