Choi-sungjin/pa_craft/src/craft_planning/v75_ws/src/v75_robot_description/meshes/tool_roll_link_yellow.stl

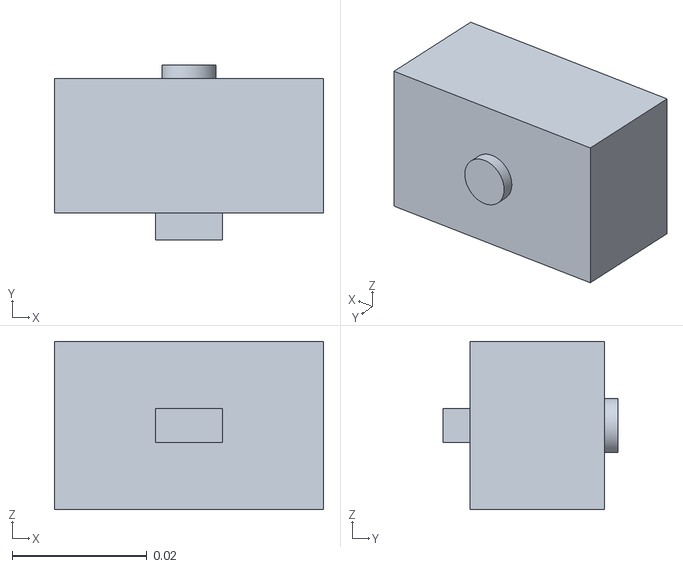
[picture p28: CAD file, 2026-10-22]
src/craft_planning/v75_ws/src/v75_robot_description/meshes/tool_roll_link_yellow.stl
0.04 x 0.026 x 0.025
