Choi-sungjin/pa_craft/(list of files, cad)

Other CAD files:
src/craft_planning/v75_ws/src/v75_robot_description/meshes/jaw_upper_link_black.stl
src/craft_planning/v75_ws/src/v75_robot_description/meshes/jaw_upper_link_orange.stl
