Choi-sungjin/pa_craft/src/craft_voice/test/images/README.md

# Test pictures for `python -m craft_voice.bench --compare ... --camera test/images`

From the OpenCV repository, `samples/data` (https://github.com/opencv/opencv/tree/5.x/samples/data),
distributed under the Apache License 2.0 (https://github.com/opencv/opencv/blob/5.x/LICENSE).

| file | OpenCV original | scene |
| --- | --- | --- |
| `office_floor.jpg` | `rgbd-color.jpg` | indoor office floor from an RGB-D camera (desks, chairs, boxes) |
| `objects_on_floor.jpg` | `stuff.jpg` | round objects, pencil and lighter on a grey floor |
| `boxes.png` | `box_in_scene.png` | boxes in a plastic bag (greyscale) |
