Choi-sungjin/pa_craft/test/gyro_scale/results.csv

time | bag | board | dir | turns | residual_deg | true_deg | imu_deg | wheel_deg | gyro_scale | wheel_over_true | gyro_offset | note
2026-10-31T03:07:16 | gyro_spin | wheel_clock | ccw | 5 | 0.0 | 1800.0 | 1801.14 | 1827.25 | 0.99937 | 1.01514 | 0.002904
2026-10-31T03:07:16 | gyro_spin | lm_arm | ccw | 5 | 0.0 | 1800.0 | 1802.1 | 1827.25 | 0.99883 | 1.01514 | 0.005037
2026-10-31T03:08:52 | gyro_spin | wheel_clock | cw | 5 | 0.0 | -1800.0 | -1801.35 | -1749.93 | 0.99925 | 0.97218 | 0.002782
2026-10-31T03:08:52 | gyro_spin | lm_arm | cw | 5 | 0.0 | -1800.0 | -1799.28 | -1749.93 | 1.0004 | 0.97218 | 0.005148
