Choi-sungjin/pa_craft/test/drive/logs/20261031-013711_lifted_0.6.csv

step | cmd_wl | cmd_wr | fb_l | fb_r | feedback_ok | seen_ok
left forward | 2.6272727272727265 | 0.0 | 2.6228 | 0.0 | 1 | 1
left backward | -2.6272727272727265 | 0.0 | -2.629 | 0.0 | 1 | 1
right forward | 0.0 | 2.6272727272727265 | 0.0 | 2.6268 | 1 | 1
right backward | 0.0 | -2.6272727272727265 | 0.0 | -2.6256 | 1 | 1
turn left | -2.6272727272727265 | 2.6272727272727265 | -2.6268 | 2.6284 | 1 | 1
