Choi-sungjin/pa_craft/test/drive/logs/20261031-014440_turn_map_spot1.csv

trial | delta | dir | t | cmd_wl | cmd_wr | wheel_l | wheel_r | gz | yaw_imu_deg
1 | 12.0 | cw | 0.0 | 6.0 | -6.0 | 0.0 | 0.0 | 0.003193 | -0.001
1 | 12.0 | cw | 0.0201 | 6.0 | -6.0 | 0.0 | 0.0 | 0.002128 | -0.004
1 | 12.0 | cw | 0.0401 | 6.0 | -6.0 | 0.0 | 0.0 | 0.002128 | -0.006
1 | 12.0 | cw | 0.0803 | 6.0 | -6.0 | 0.0 | 0.0 | 0.004257 | -0.006
1 | 12.0 | cw | 0.1003 | 6.0 | -6.0 | 0.0 | 0.0 | 0.002128 | -0.009
1 | 12.0 | cw | 0.1204 | 6.0 | -6.0 | 0.023981 | -0.01199 | -0.017027 | -0.033
1 | 12.0 | cw | 0.1605 | 6.0 | -6.0 | 0.095923 | -0.083933 | -0.021284 | -0.092
1 | 12.0 | cw | 0.1806 | 6.0 | -6.0 | 0.155875 | -0.203837 | -0.043632 | -0.147
1 | 12.0 | cw | 0.2007 | 6.0 | -6.0 | 0.251799 | -0.275779 | -0.069173 | -0.231
1 | 12.0 | cw | 0.2408 | 6.0 | -6.0 | 0.371703 | -0.347722 | -0.087264 | -0.442
1 | 12.0 | cw | 0.2609 | 6.0 | -6.0 | 0.455636 | -0.443645 | -0.108548 | -0.572
1 | 12.0 | cw | 0.2809 | 6.0 | -6.0 | 0.551559 | -0.551559 | -0.120255 | -0.715
1 | 12.0 | cw | 0.301 | 6.0 | -6.0 | 0.635492 | -0.647482 | -0.13941 | -0.88
1 | 12.0 | cw | 0.3412 | 6.0 | -6.0 | 0.719425 | -0.743406 | -0.158566 | -1.254
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
