Choi-sungjin/pa_craft/test/drive/logs/20261031-020746_turn_map_spot2.csv

trial | delta | dir | t | cmd_wl | cmd_wr | wheel_l | wheel_r | gz | yaw_imu_deg
1 | 2.0 | cw | 0.0 | 1.0 | -1.0 | 0.0 | 0.0 | 0.001064 | -0.003
1 | 2.0 | cw | 0.0201 | 1.0 | -1.0 | 0.0 | 0.0 | 0.002128 | -0.005
1 | 2.0 | cw | 0.0402 | 1.0 | -1.0 | 0.0 | 0.0 | 0.002128 | -0.007
1 | 2.0 | cw | 0.0803 | 1.0 | -1.0 | 0.0 | 0.0 | 0.005321 | -0.003
1 | 2.0 | cw | 0.1004 | 1.0 | -1.0 | 0.0 | -0.01199 | -0.001064 | -0.008
1 | 2.0 | cw | 0.1205 | 1.0 | -1.0 | 0.01199 | -0.059952 | -0.006385 | -0.02
1 | 2.0 | cw | 0.1606 | 1.0 | -1.0 | 0.059952 | -0.095923 | -0.023412 | -0.082
1 | 2.0 | cw | 0.1807 | 1.0 | -1.0 | 0.131895 | -0.167866 | -0.039375 | -0.131
1 | 2.0 | cw | 0.2008 | 1.0 | -1.0 | 0.239808 | -0.263789 | -0.069173 | -0.215
1 | 2.0 | cw | 0.2409 | 1.0 | -1.0 | 0.371703 | -0.359712 | -0.09365 | -0.439
1 | 2.0 | cw | 0.261 | 1.0 | -1.0 | 0.479616 | -0.431655 | -0.114934 | -0.575
1 | 2.0 | cw | 0.281 | 1.0 | -1.0 | 0.551559 | -0.539569 | -0.127704 | -0.726
1 | 2.0 | cw | 0.3011 | 1.0 | -1.0 | 0.635492 | -0.647482 | -0.144731 | -0.897
1 | 2.0 | cw | 0.3412 | 1.0 | -1.0 | 0.731415 | -0.743406 | -0.180914 | -1.321
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
