Choi-sungjin/pa_craft/test/drive/logs/gs_ccw1_compare.png

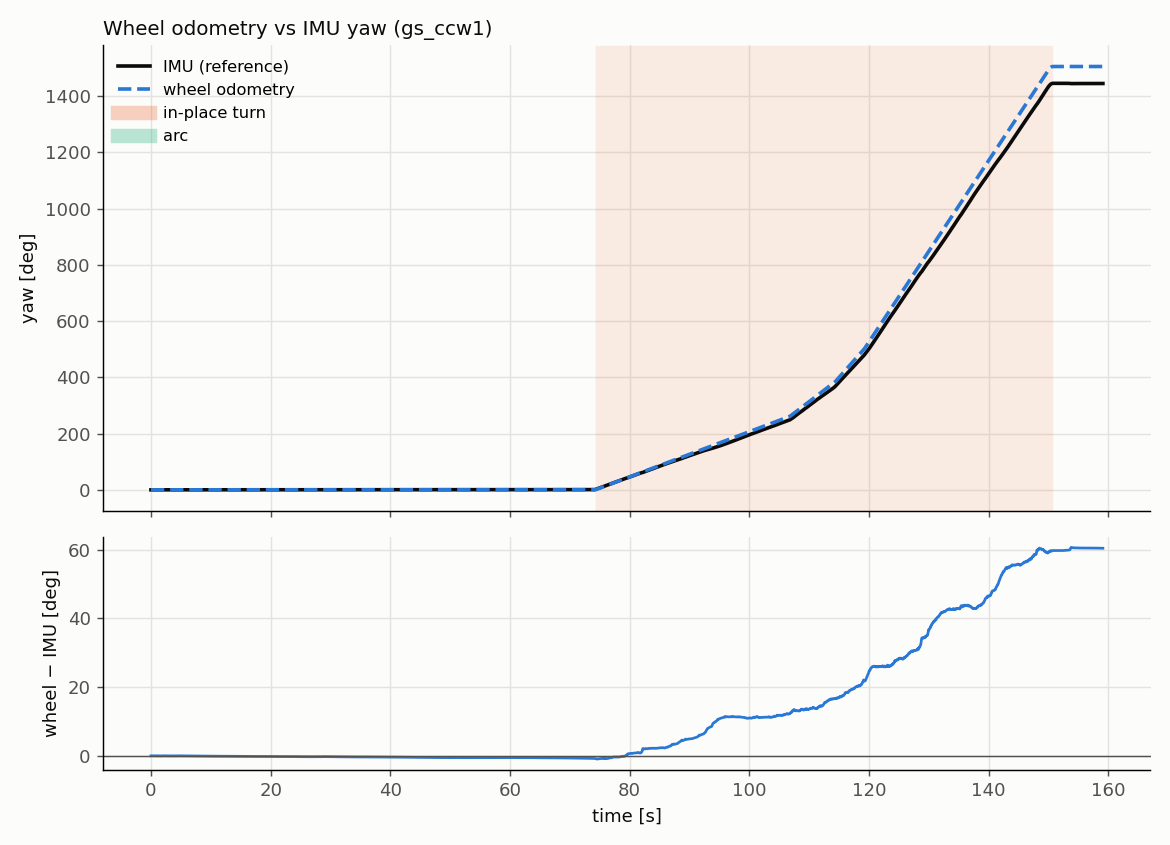
test/drive/logs/gs_ccw1_compare.png
