Choi-sungjin/pa_craft/test/drive/logs/loop_1_graph.png

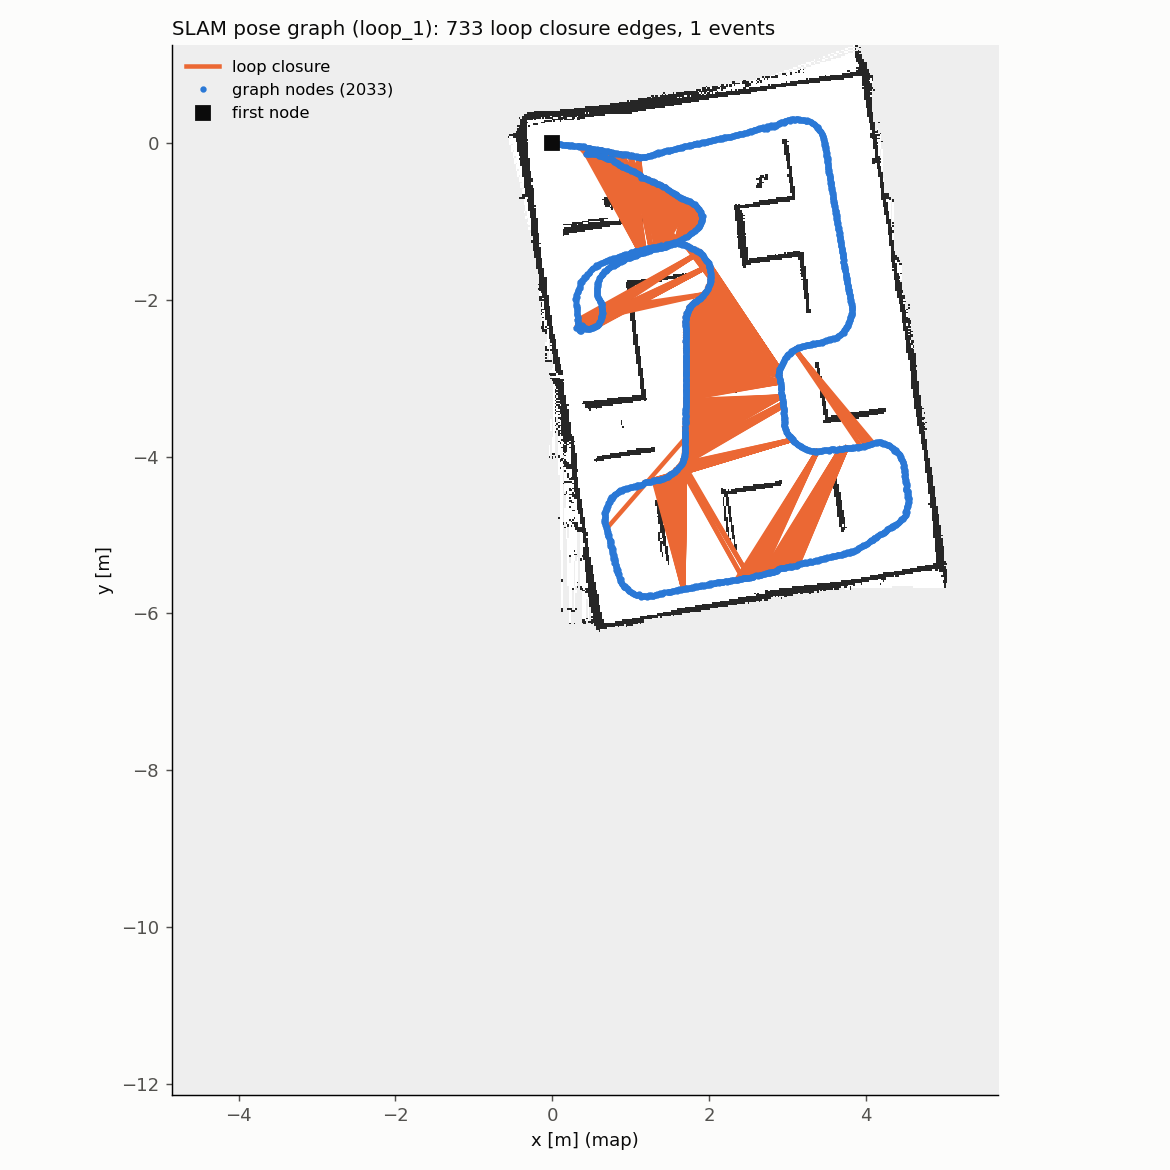
test/drive/logs/loop_1_graph.png
