Choi-sungjin/pa_craft/test/drive/logs/loop_1_trajectories.png

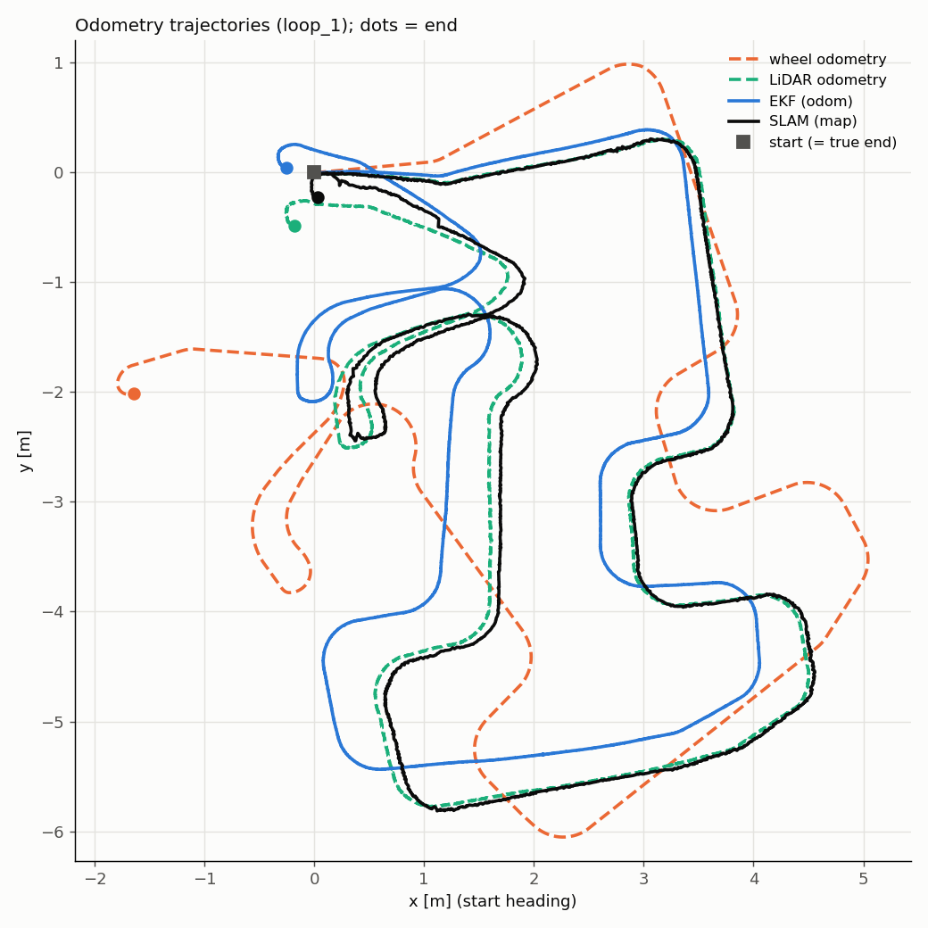
test/drive/logs/loop_1_trajectories.png
