Choi-sungjin/pa_craft/test/drive/logs/turn_map_plot.png

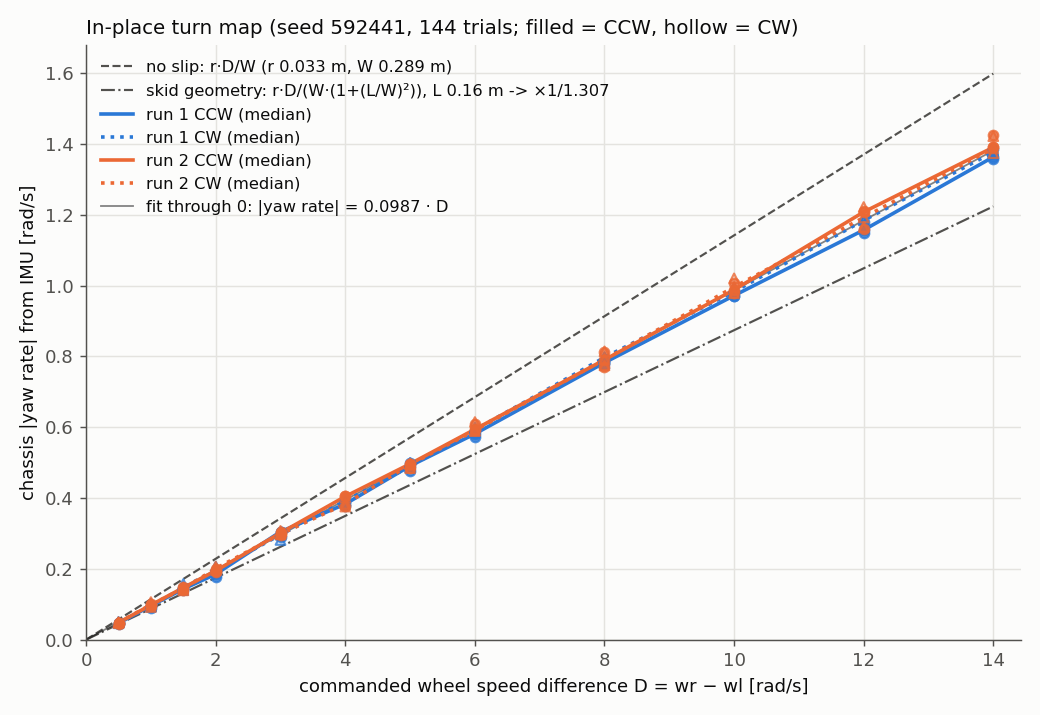
test/drive/logs/turn_map_plot.png
