Choi-sungjin/pa_craft/test/drive/logs/turn_map_poly.png

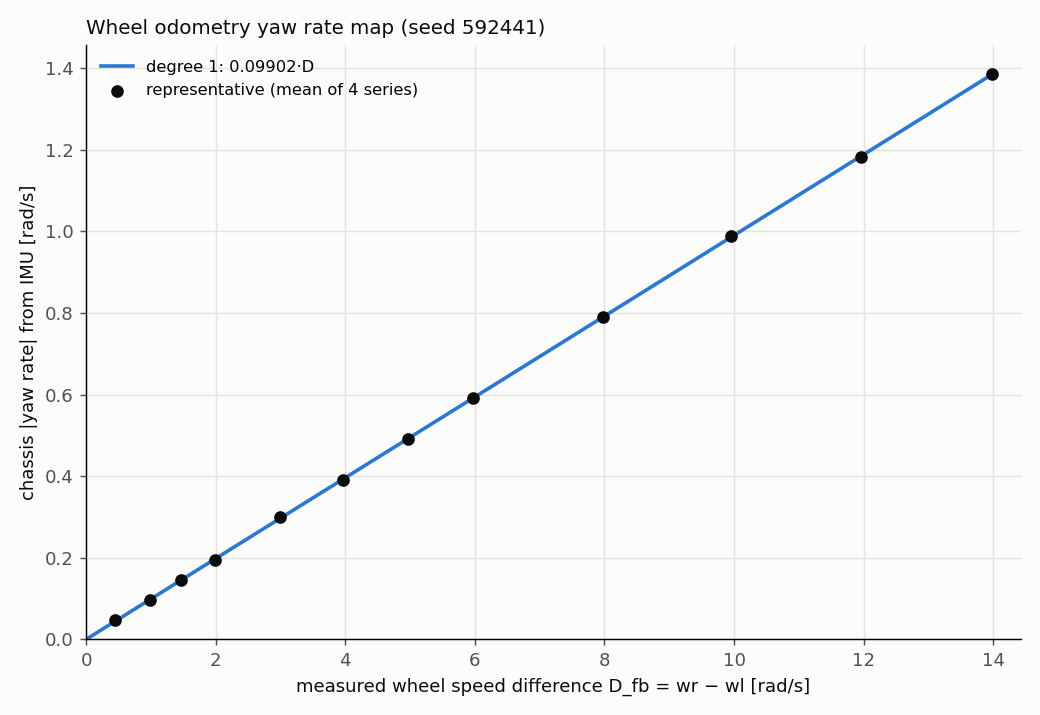
test/drive/logs/turn_map_poly.png
