Choi-sungjin/pa_craft/test/drive/logs/wasd_1031-023655_compare.png

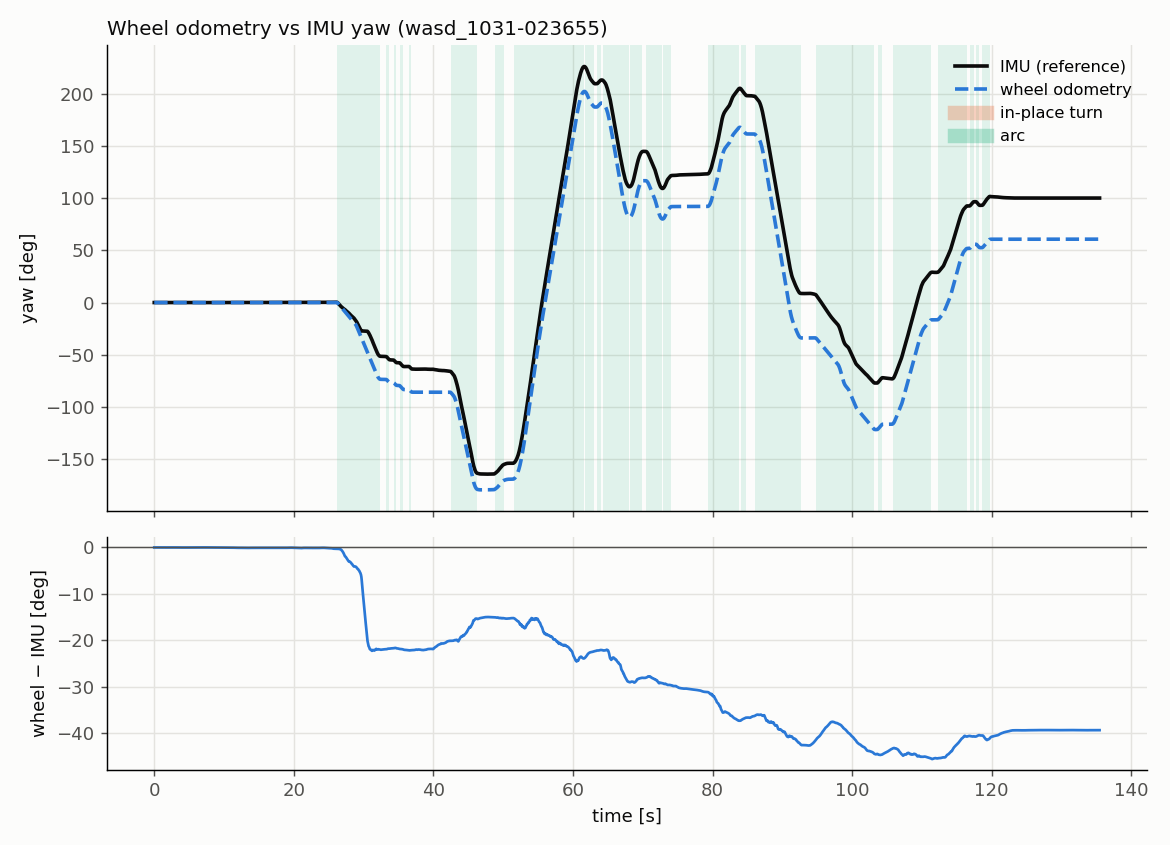
test/drive/logs/wasd_1031-023655_compare.png
