Choi-sungjin/pa_craft/test/imu/tilt_20261031-104927.png

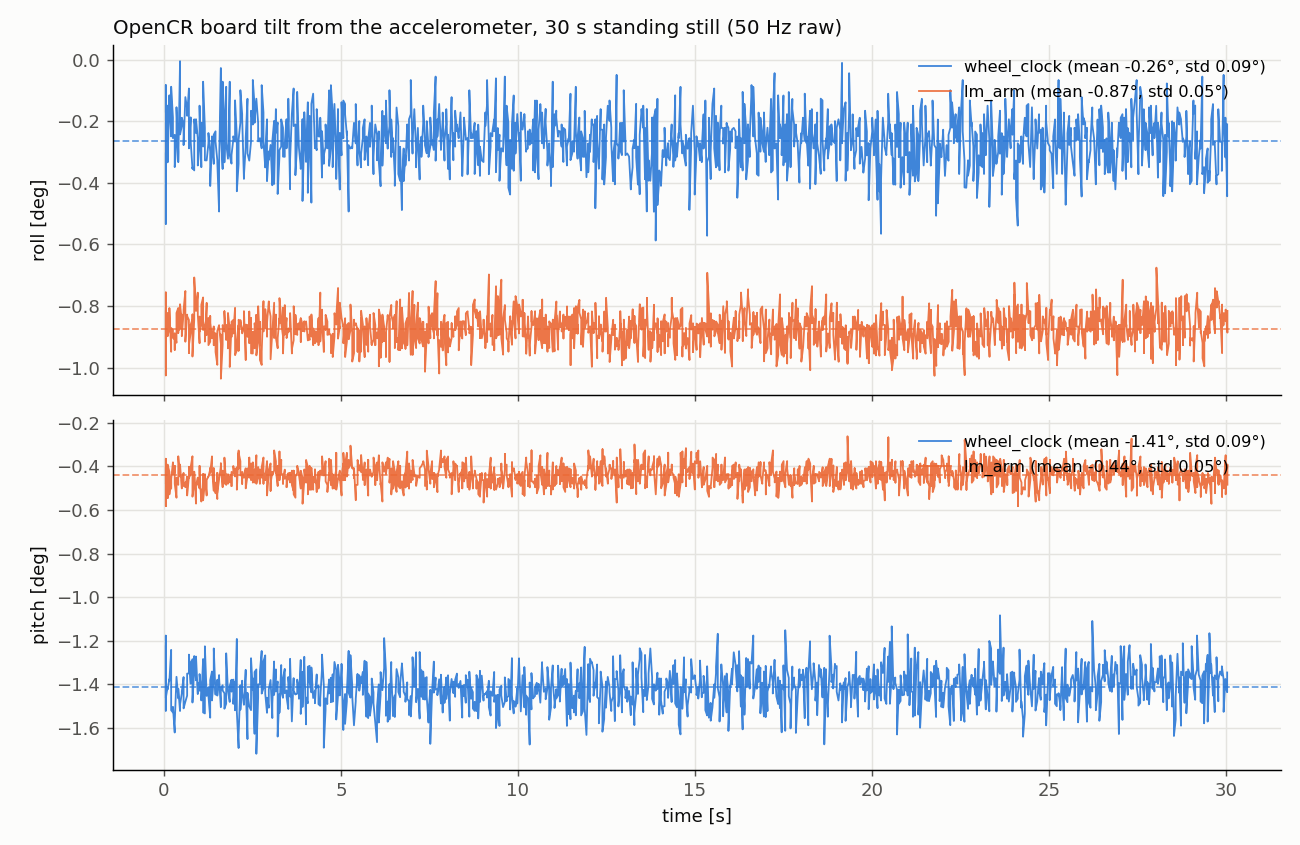
test/imu/tilt_20261031-104927.png
