Choi-sungjin/pa_craft/test/lidar/logs/20261031-140542_lidar_check.png

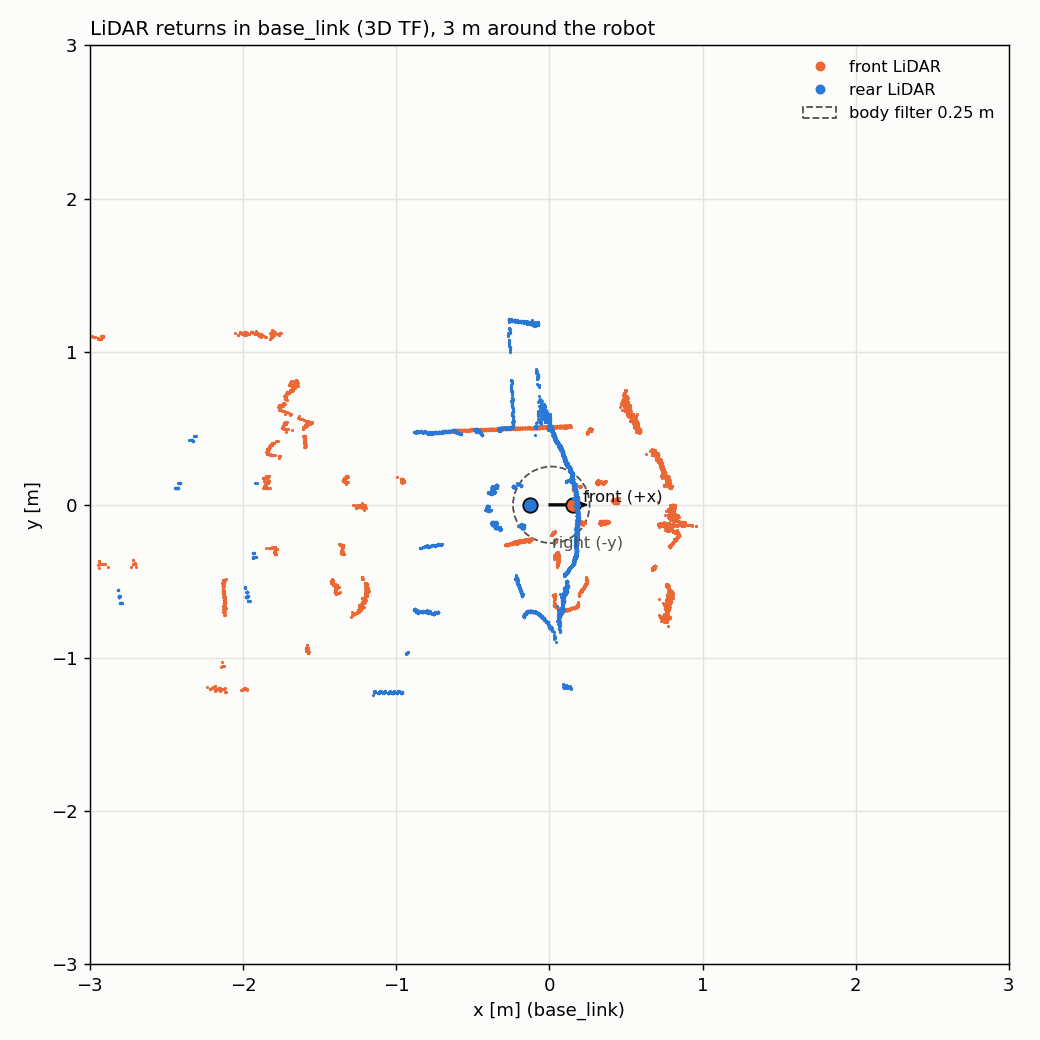
test/lidar/logs/20261031-140542_lidar_check.png
