Choi-sungjin/pa_craft/docs/worklog/2026-11-01.md

# 2026-11-01 (일) 작업 기록: LiDAR SLAM · 위치 추정 · Corner demo · 경로 계획

## 한 줄 요약
저장한 맵 어디에 로봇을 놓아도 스스로 위치를 찾아 지정한 구석까지 가는 **Corner demo**를 만들어 실주행으로 도착을 확인했다. 그 과정에서 나온 문제(ㄷ자 벽 돌진, 시간 제한, 무한 재계획, 지면 오검출)를 고치면서 경로 계획을 **A*+arc(C++ 포팅)**로 교체했다.

## 1. 오전: 위치 추정 기반 정비

| 영역 | 한 일 | 결과 |
|---|---|---|
| 휠 odometry | 제자리 회전 실험(turn_map)으로 yaw rate 보정 계수, skid steer 계수 1.153, 축간거리 0.16 m 반영 | 회전 시 yaw 오차 감소 |
| 슬립 검출 | 휠 yaw rate와 보드 gyro 차이 > 0.1 rad/s면 휠 odometry 분산 ×100 (0.5 s 유지) | 미끄러질 때 EKF가 휠을 덜 믿음 |
| LiDAR odometry | keyframe scan matching으로 `/perception/lidar/odom` 추가 | EKF에 LiDAR 속도 입력 |
| EKF | `lidar_odom:=true`: LiDAR vx/vy 주, IMU yaw, 휠은 큰 공분산 | |
| SLAM | `slam_search:=wide`(±25 cm), 저장 맵으로 localization mode(`slam_map:=`) | |
| LiDAR 업사이드다운 | TF roll 180°를 2D 변환에서 인식(스캔 각도 부호 반전) | 앞뒤 scan 정상 병합 |
| 맵 | posegraph에서 로봇을 들어 올린 구간 삭제 도구 → `arena3_clean` | 데모용 맵 |
| 도구 | `slam.launch.py`, `save_map.sh`, `slamall`/`slamsave`, odometry 비교·궤적·SLAM graph 분석 스크립트 | |

## 2. Corner demo 구성과 첫 실주행

- **구성**: `corner_demo.launch.py`(control + LiDAR/EKF + slam_toolbox localization + perception + planning) → `run_corner.py`가 global localization(scan을 맵 전체에 맞춤, 약 6초) → `/initialpose` → slam_toolbox 수렴 확인 → planning에 목표 전달
- **global localization 실측**: 원점에서 먼 곳 3곳 모두 점수 0.94~1.00, slam_toolbox와 **4 cm 이내** 일치

| 증상 | 원인 | 수정 |
|---|---|---|
| 목표 1.4 m 앞에서 정지 | 시간 제한 60 s (0.12 m/s로 7 m 경로 초과) | control·planning timeout 180 s |
| 주행 중 갑자기 Fault | scan이 TF보다 몇 ms 앞서면 장애물 데이터를 지워 버림 | 변환 실패 시 직전 값 유지, Fault 메시지에 실제 원인 표시 |
| 같은 자리에서 계속 멈춤 | 경로가 벽에 padding(0.24 m) 그대로 붙어 지나가, 오차로 margin 안에 들어가면 재계획 영구 실패 | 경로를 벽에서 더 띄우고, margin 안이면 가까운 자유 칸으로 탈출 |
| Ctrl+C 했는데 계속 주행 | Ctrl+C가 메시지 수신 중에 걸리면 STOP을 건너뜀 | SIGINT를 flag로 처리, STOP 전송 확인 |
| 하드웨어 | USB hub 끊김으로 앞 LiDAR(`-110` timeout)·팔 보드 feedback 정지 | USB 리셋 / 보드 리셋 절차 정리 |

- **결과**: 실주행으로 **목표 구석 도착 확인**
- **RViz 도구**: 목표(`/corner/goal`), 계획 경로(`/corner/path`), 지나온 경로(`/corner/trail`), EKF 궤적 점(`/odometry/local/trail`, 사라지지 않음)

## 3. 오후: ㄷ자 벽 안쪽 출발 시 벽으로 돌진

- **원인 (오프라인 시뮬레이션으로 확인)**: control Pure Pursuit가 경로 전체에서 "차체 앞쪽의 첫 점"을 찾았다. 근처 경로가 뒤에 있으면(아래를 보고 출발) 몇 m 떨어진 경로 후반부를 집고 **제자리 회전 없이 직진**했다.
- **경로 계획 교체: A*+arc C++ 포팅**
  - 팀에서 만든 A*+arc(`astar_arc.py`: heading 상태 4방향 A*, 코너 원호 fillet, PASS/STOP_TURN/ALIGN)를 C++로 옮겨 기존 8방향 A*를 대체
  - Python과 **waypoint 40/40 일치**, 계획 시간 **중앙값 24 ms / 최대 49 ms**(Python 560 / 1058 ms)
  - 이름 정리: KANT → **A*+arc**
- **구간 분할**: 경로를 STOP_TURN 코너까지만 보내고, 도착하면 그 자리에서 다음 구간을 계획한다. 주행 중 주기적 재계획은 없애고 막혔을 때만 재계획한다.
- **control 추종**: "내 노드"를 직전 노드 ±3점 안에서 찾음(U턴 겹침 방지), lookahead는 경로를 따라 0.3 m, 방향이 0.5 rad 넘게 어긋나면 먼저 제자리 회전
- **테스트**: planning 76개, control 52개 통과 (새 시나리오: ㄷ자 출발, 완전히 겹치는 U턴)

## 4. 퍽 집기 설계 (구현 일부, 실측 대기)

- **잡기 가능 판정**: IK 대신 실험으로 구한 퍽 종류별(누움/섬) 영역. **정렬이 먼저**(누운 퍽은 장축이 차체 전방과 허용각 안), 정렬된 경우에만 퍽 중심이 영역 안인지 판정, 연속 3회면 확정
- **정지 위치 비용함수**: `J = w_box / (d − 3 cm) + w_grasp · ((s − s_good)/σ)²`
  - d: 로봇 앞면(LM 가이드)과 박스 사이 최단거리, 3 cm에서 무한대(안전거리)
  - s: 앞면에서 퍽 중심까지 거리, s_good: 잡기 좋은 면
  - 1/d형 장벽과 2차 장벽의 연산량 차이는 무의미(49 ns vs 7 ns)
- **하위 미션 설계**: 대기 지점 → 관측 → 정밀 접근 → 잡기 가능 정지 → 재확인 → 집기·적재
- **실측 대기**: 잡기 영역(모양과 값), 앞면 위치·폭, s_good. 퍽 centerpose(perception)는 TODO

## 5. 밤: 실주행 bag 분석과 수정

| 발견 (bag 분석) | 수정 |
|---|---|
| 출발점이 margin 안이면 2~6 cm 탈출 구간 → 도착 허용 10 cm라 즉시 "도착" → **무한 재계획** | 15 cm 안의 STOP_TURN은 구간 끝으로 안 씀. 제자리 "도착" 3연속이면 Fault |
| 잡음 점 **하나**, 맵 벽을 4 cm 어긋나게 본 점, 지나가는 사람으로 즉시 재계획·우회 | perception 장애물 필터: 맵 벽 6 cm 안 제거, 3프레임 지속, 3점 미만 군집 제거 |
| 막히면 바로 먼 길로 우회하고 돌아오지 않음 | 막히면 즉시 정지 → 2초 기다림 → 풀리면 원래 경로 재개, 계속 막히면 재계획 |

- **운영 편의**: `arm:=false`(팔 보드 없이 주행), `lidar_fov_deg`(화각 조절), `run_corner.py --near X Y`(위치 후보 범위 제한)
- **하드웨어 이슈**: hub를 다른 Jetson 포트로 옮기자 OpenCR 두 개가 같은 이름으로 잡힘 → udev를 **hub 소켓 번호 기준**으로 변경. 팔 OpenCR은 부팅 때 모터 초기화 fault(상태 2)

## 6. 밤 ~ 11/2 새벽: LiDAR 각도 작업과 지면 처리

- LiDAR pitch를 올린 뒤 180° 화각에서 바닥이 찍혀 90°로 운용
- **평평한 바닥 보정** (높이 실측: 앞 1.2 cm, 뒤 1.1 cm)
  - 바닥 점이 V자 → 단순 평면(pitch + roll) 모델로는 설명 불가
  - 원뿔 0.6° + pitch 1.65°(바깥쪽 들림) + roll 0.1~0.2° 모델이 오차 **1 cm 수준**으로 맞음
  - 정면 바깥쪽 빔은 1 m당 1.8 cm 상승 → **7 cm 박스를 약 3.2 m까지** 볼 수 있음
- **경기장 데이터 기반 비대칭 ROI**: LiDAR별·좌우별로 바닥이 찍히기 시작하는 각도(바깥쪽 50~70°)까지는 전부, 그 바깥은 5° 구간별 최대 거리만 사용
  - 교차 검증: 보지 않은 bag에서 바닥 점 **75~90% 제거**, 맵 벽 점 80~97% 유지
  - `/lidar/merged`에 적용 → SLAM, 위치 찾기, 장애물이 모두 지면 없는 scan 사용, 화각 180°로 복귀
- RViz에 planner가 실제로 보는 장애물(필터 적용 후) 표시 추가

## 7. 남은 과제

| 우선순위 | 과제 |
|---|---|
| 1 | ROI 적용 주행(`roi_0141`) 검증, ㄷ자 출발 6방향 실기 시험 |
| 2 | 근접 복구(벽에 붙었을 때 직선 후진), 주행 중 안전 계층 (**차체 외곽 치수 필요**) |
| 3 | 정밀 주행용 control `APPROACH` 명령, 퍽 하위 미션 구현, LiDAR 박스 검출 |
| 4 | 실측 대기: 잡기 영역, 앞면 위치·폭, s_good, 퍽 centerpose |
| 보류 | USB hub 끊김(전원 분리 예정), 보드 부팅 시 fault 고정(배터리 순서 확인), LiDAR odometry 점수·공분산 튜닝 |

## 8. 데이터 (bag)

| bag | 내용 |
|---|---|
| `astar_arc_1804` | 무한 루프·우회 원인 분석 (LiDAR 작업 전) |
| `pocket_2248`, `pocket_2309` | ㄷ자 출발 주행 (180°) |
| `fov90_2316`, `fov90_2321` | 90° 화각 주행 |
| `fov180_2359` | 180° 주행, 원본 scan 포함, 목표 도착 |
| `floor_cal_0034` | 평평한 바닥 LiDAR 보정 |
| `roi_0141` | 비대칭 ROI 적용 첫 주행 (검증 예정) |

> 이 기록의 코드 변경 사항은 모두 커밋하지 않은 상태다.
