Choi-sungjin/pa_craft/src/craft_control/src/control_master.cpp

// ControlMaster distributes ID-bearing tasks and aggregates controller completion.
// /planning/hold remains a watchdog heartbeat; /control/status reports actual settling.
#include <fcntl.h>
#include <termios.h>
#include <unistd.h>

#include <algorithm>
#include <array>
#include <chrono>
#include <cmath>
#include <cstdio>
#include <cstdlib>
#include <memory>
#include <optional>
#include <stdexcept>
#include <string>
#include <vector>
#include <deque>
#include "craft_control/task_tracker.hpp"
#include "craft_control/slip_monitor.hpp"
#include <craft_interfaces/msg/control_status.hpp>

#include "rclcpp/rclcpp.hpp"
#include "nav_msgs/msg/odometry.hpp"
#include "nav_msgs/msg/path.hpp"
#include "sensor_msgs/msg/imu.hpp"
#include "sensor_msgs/msg/joint_state.hpp"
#include "std_msgs/msg/bool.hpp"
#include "std_msgs/msg/float64.hpp"
#include "std_msgs/msg/int32.hpp"
#include "geometry_msgs/msg/transform_stamped.hpp"
#include "geometry_msgs/msg/twist.hpp"
#include "tf2_ros/transform_broadcaster.h"

#include "craft_control/arm_controller.hpp"
#include "craft_control/clock_controller.hpp"
#include "craft_control/gripper_controller.hpp"
#include "craft_control/lateral_controller.hpp"
#include "craft_control/lm_controller.hpp"
#include "craft_control/longitudinal_controller.hpp"
#include "craft_control/planning_watchdog.hpp"
#include "craft_control/wheel_odometry.hpp"

using TaskCommand = craft_interfaces::msg::TaskCommand;
using TaskResult = craft_interfaces::msg::TaskResult;
using ControlStatus = craft_interfaces::msg::ControlStatus;

constexpr double kDt = 0.02;  // control period [s], TODO: check computing time and OpenCR serial latency

class OpencrSerial
{
public:
  explicit OpencrSerial(const std::string & port)
  {
    fd_ = ::open(port.c_str(), O_RDWR | O_NOCTTY | O_NONBLOCK);
    if (fd_ < 0) {
      throw std::runtime_error("cannot open OpenCR serial: " + port);
    }
    termios tty{};
    tcgetattr(fd_, &tty);
    cfmakeraw(&tty);
    cfsetspeed(&tty, B115200);  // OpenCR USB CDC ignores baud, kept for USB-UART adapters
    tty.c_cflag |= CLOCAL | CREAD;
    tcsetattr(fd_, TCSANOW, &tty);
  }
  ~OpencrSerial() {::close(fd_);}
  OpencrSerial(const OpencrSerial &) = delete;
  OpencrSerial & operator=(const OpencrSerial &) = delete;

  std::vector<std::string> read_lines()
  {
    char buf[256];
    ssize_t n;
    while ((n = ::read(fd_, buf, sizeof(buf))) > 0) {
      rx_buf_.append(buf, n);
    }
    std::vector<std::string> lines;
    size_t pos;
    while ((pos = rx_buf_.find('\n')) != std::string::npos) {
      lines.push_back(rx_buf_.substr(0, pos));
      rx_buf_.erase(0, pos + 1);
    }
    if (rx_buf_.size() > 1024) {  // garbage without '\n'
      rx_buf_.clear();
    }
    return lines;
  }

  bool write_values(const std::vector<double> & values)
  {
    std::string line;
    for (double x : values) {
      char b[32];
      std::snprintf(b, sizeof(b), "%.4f,", x);
      line += b;
    }
    line.back() = '\n';
    return ::write(fd_, line.data(), line.size()) == static_cast<ssize_t>(line.size());
  }

private:
  int fd_ = -1;
  std::string rx_buf_;
};

// "1.0,2,3\r" -> {1, 2, 3}; false on junk
static bool parse_csv(const std::string & line, std::vector<double> & v)
{
  const char * p = line.c_str();
  char * end;
  while (true) {
    double x = std::strtod(p, &end);
    if (end == p) {
      break;
    }
    v.push_back(x);
    p = (*end == ',') ? end + 1 : end;
  }
  return *end == '\0' || *end == '\r';
}

class ControlMaster : public rclcpp::Node
{
public:
  ControlMaster()
  : Node("control_master")
  {
    // Load parameters: arm, gripper, lm guide
    const auto arm_min_angle = load_array_param<craft_control::kArmIkJoints>("arm_min_angle");
    const auto arm_max_angle = load_array_param<craft_control::kArmIkJoints>("arm_max_angle");
    const auto arm_ik_joint_names = declare_parameter<std::vector<std::string>>(
      "arm_ik_joint_names", std::vector<std::string>{
        "shoulder_joint", "elbow_joint", "wrist_pitch_joint", "tool_roll_joint"});
    const auto arm_joint_directions = load_array_param<craft_control::kArmIkJoints>("arm_joint_directions");
    const auto arm_joint_offsets = load_array_param<craft_control::kArmIkJoints>("arm_joint_offsets");
    arm_ik_mapping_confirmed_ = declare_parameter("arm_ik_mapping_confirmed", false);
    lm_linear_joint_name_ = declare_parameter<std::string>("lm_linear_joint_name", "slide_joint");
    lm_mapping_confirmed_ = declare_parameter("lm_mapping_confirmed", false);
    const double lm_min_angle = declare_parameter<double>("lm_min_angle");
    const double lm_max_angle = declare_parameter<double>("lm_max_angle");
    const double lm_motor_direction = declare_parameter<double>("lm_motor_direction");
    const double lm_motor_offset = declare_parameter<double>("lm_motor_offset");
    const double lm_meters_per_rad = declare_parameter("lm_meters_per_rad", 0.0);
    const double gripper_min_angle = declare_parameter("gripper_min_angle", 0.0);
    const double gripper_max_angle = declare_parameter("gripper_max_angle", 0.0);
    const double gripper_open_angle = declare_parameter("gripper_open_angle", 0.0);
    const double gripper_close_angle = declare_parameter("gripper_close_angle", 0.0);
    const double grasp_current_threshold_a = declare_parameter("grasp_current_threshold_a", 0.0);
    const double grasp_current_debounce = declare_parameter("grasp_current_debounce", 0.0);
    const double gripper_grasp_squeeze_angle = declare_parameter("gripper_grasp_squeeze_angle", 0.0);
    gripper_mapping_confirmed_ = declare_parameter("gripper_mapping_confirmed", false);
    const double arm_angle_tolerance = positive_param("arm_angle_tolerance");
    const double lm_angle_tolerance = positive_param("lm_angle_tolerance");
    const double gripper_angle_tolerance = positive_param("gripper_angle_tolerance");

    // Validate parameters: arm, gripper, lm guide
    if (arm_ik_joint_names.size() != craft_control::kArmIkJoints)
    {
      throw std::runtime_error("arm_ik_joint_names needs 4 rotational joint entries");
    }
    craft_control::ArmIkJointNames ik_joint_name_array;
    std::copy(arm_ik_joint_names.begin(), arm_ik_joint_names.end(), ik_joint_name_array.begin());
    if (!arm_controller_.configure(
      arm_min_angle, arm_max_angle, ik_joint_name_array, arm_joint_directions, arm_joint_offsets,
      arm_angle_tolerance))
    {
      throw std::runtime_error("invalid arm limits or IK joint/motor mapping in config/control.yaml");
    }
    if (std::find(arm_ik_joint_names.begin(), arm_ik_joint_names.end(), lm_linear_joint_name_) !=
      arm_ik_joint_names.end() || !lm_controller_.configure(
        lm_linear_joint_name_, lm_min_angle, lm_max_angle, lm_motor_direction, lm_motor_offset,
        lm_meters_per_rad, lm_angle_tolerance))
    {
      throw std::runtime_error("invalid LM limits, mapping or calibration in config/control.yaml");
    }
    if (!gripper_controller_.configure(
      gripper_min_angle, gripper_max_angle,
      gripper_open_angle, gripper_close_angle, grasp_current_threshold_a, grasp_current_debounce,
      gripper_angle_tolerance, gripper_grasp_squeeze_angle))
    {
      throw std::runtime_error("invalid gripper angle limits or open/close targets");
    }
    if (!arm_ik_mapping_confirmed_) {
      RCLCPP_WARN(get_logger(), "arm IK-to-motor mapping is unconfirmed; rotational arm targets will be ignored");
    }
    if (!lm_mapping_confirmed_) {
      RCLCPP_WARN(get_logger(), "LM mapping is unconfirmed; linear targets will be ignored");
    }
    if (!gripper_mapping_confirmed_) {
      RCLCPP_WARN(get_logger(), "gripper mapping is unconfirmed; gripper commands will be ignored");
    }
    if (!gripper_controller_.grasp_detection_configured()) {
      RCLCPP_WARN(get_logger(), "gripper current-based grasp detection is disabled until thresholds are calibrated");
    }

    // Load parameters: wheel, clock
    wheel_radius_ = positive_param("wheel_radius");
    const auto wheel_track = positive_param("wheel_track");
    const auto wheelbase = positive_param("wheelbase");
    const auto skid_steer_factor = declare_parameter<double>("skid_steer_factor", 0.0);
    max_v_ = positive_param("max_v");
    const auto max_v = max_v_;
    max_wheel_ = positive_param("max_wheel");
    const auto lookahead_distance = positive_param("lookahead_distance");
    const auto wheel_goal_tolerance = positive_param("wheel_goal_tolerance");
    const auto path_spacing = positive_param("path_spacing");
    clock_slot_count_ = declare_parameter<int>("clock_slot_count");
    const auto clock_slot_angle = positive_param("clock_slot_angle");
    const auto clock_zero_angle = declare_parameter<double>("clock_zero_angle");
    const auto clock_direction = declare_parameter<double>("clock_direction");
    const auto clock_angle_tolerance = positive_param("clock_angle_tolerance");

    // Validate parameters: wheel, clock
    longitudinal_.configure(wheel_radius_, max_v);
    if (!std::isfinite(skid_steer_factor) || (skid_steer_factor > 0.0 && skid_steer_factor < 1.0)) {
      throw std::runtime_error("skid_steer_factor must be 0 (geometric estimate) or >= 1");
    }
    lateral_.configure(
      wheel_radius_, wheel_track, wheelbase, skid_steer_factor, lookahead_distance, wheel_goal_tolerance,
      path_spacing,
      positive_param("wheel_heading_tolerance"), positive_param("wheel_rotate_angular_speed"),
      positive_param("wheel_tracking_gain"));
    if (!clock_controller_.configure(
      clock_slot_count_, clock_slot_angle, clock_zero_angle, clock_direction, clock_angle_tolerance))
    {
      throw std::runtime_error("invalid clock geometry or angle tolerance in config/control.yaml");
    }
    if (!planning_watchdog_.configure(
        declare_parameter("planning_watchdog_timeout_s", 0.5),
        declare_parameter("require_planning_heartbeat", true)))
    {
      throw std::runtime_error("planning_watchdog_timeout_s must be finite and positive");
    }
    // Same skid steer separation as the controller, so wheel yaw rate is not overstated.
    const double in_place_ratio = declare_parameter("wheel_in_place_ratio", 0.0);
    if (!std::isfinite(in_place_ratio) || in_place_ratio < 0.0 || in_place_ratio > 1.0) {
      throw std::runtime_error("wheel_in_place_ratio must be in [0, 1]");
    }
    // Measured skid steer map for the odometry yaw rate; empty keeps radius * (wr - wl) / separation.
    const auto yaw_rate_coeffs = declare_parameter<std::vector<double>>(
      "wheel_yaw_rate_coeffs", std::vector<double>{});
    for (const double c : yaw_rate_coeffs) {
      if (!std::isfinite(c)) {throw std::runtime_error("wheel_yaw_rate_coeffs must be finite");}
    }
    wheel_odometry_.configure(wheel_radius_, lateral_.effective_separation(), in_place_ratio, yaw_rate_coeffs);
    RCLCPP_INFO(get_logger(), "wheel track %.3f m, wheelbase %.3f m -> effective separation %.3f m",
      wheel_track, wheelbase, lateral_.effective_separation());
    if (!yaw_rate_coeffs.empty()) {
      std::string text;
      for (const double c : yaw_rate_coeffs) {text += (text.empty() ? "" : ", ") + std::to_string(c);}
      RCLCPP_INFO(get_logger(), "wheel odometry yaw rate: measured map, degree %zu [%s]",
        yaw_rate_coeffs.size(), text.c_str());
    }
    // Slip: wheel odometry vs wheel board gyro yaw rate; its velocity variances grow while they disagree.
    if (!slip_monitor_.configure(positive_param("slip_yaw_rate_threshold"), declare_parameter("slip_hold_s", 0.5),
        positive_param("slip_offset_gain")))
    {
      throw std::runtime_error("slip_hold_s must be >= 0 and slip_offset_gain in (0, 1]");
    }
    slip_variance_scale_ = positive_param("slip_variance_scale");
    odom_frame_ = declare_parameter<std::string>("odom_frame");
    base_frame_ = declare_parameter<std::string>("base_frame");
    publish_odom_tf_ = declare_parameter<bool>("publish_odom_tf");
    wheel_vx_variance_ = positive_param("wheel_vx_variance");
    wheel_vyaw_variance_ = positive_param("wheel_vyaw_variance");
    const double serial_timeout = declare_parameter("serial_feedback_timeout_s", 0.5);
    serial_timeout_s_ = serial_timeout;
    if (!arm_feedback_watchdog_.configure(serial_timeout) ||
      !clock_wheel_feedback_watchdog_.configure(serial_timeout))
    {
      throw std::runtime_error("serial_feedback_timeout_s must be finite and positive");
    }

    // OpenCR serial ports
    // arm_enabled:=false drives with the wheel/clock board alone (arm board absent or faulted): its port is not
    // opened, it is left out of the fault and stop checks, and manipulator/gripper tasks are rejected.
    arm_enabled_ = declare_parameter<bool>("arm_enabled", true);
    const auto arm_port = declare_parameter<std::string>("arm_lm_port");
    if (arm_enabled_) {arm_lm_serial_ = std::make_unique<OpencrSerial>(arm_port);}
    else {RCLCPP_WARN(get_logger(), "arm_enabled is false: wheel/clock only, arm+LM board %s not used", arm_port.c_str());}
    clock_wheel_serial_ = std::make_unique<OpencrSerial>(declare_parameter<std::string>("clock_wheel_port"));

    // ROS2 publishers and subscribers
    arm_lm_state_pub_ = create_publisher<std_msgs::msg::Int32>("/control/arm_lm_state", 10);
    gripper_grasped_pub_ = create_publisher<std_msgs::msg::Bool>("/control/gripper_grasped", 10);
    wheel_state_pub_ = create_publisher<std_msgs::msg::Int32>("/control/wheel_state", 10);
    clock_state_pub_ = create_publisher<std_msgs::msg::Int32>("/control/clock_state", 10);
    clock_slot_pub_ = create_publisher<std_msgs::msg::Int32>("/control/clock_slot", 10);
    clock_target_reached_pub_ = create_publisher<std_msgs::msg::Bool>("/control/clock_target_reached", 10);
    arm_target_reached_pub_ = create_publisher<std_msgs::msg::Bool>("/control/arm_target_reached", 10);
    lm_target_reached_pub_ = create_publisher<std_msgs::msg::Bool>("/control/lm_target_reached", 10);
    gripper_target_reached_pub_ = create_publisher<std_msgs::msg::Bool>("/control/gripper_target_reached", 10);
    wheel_target_reached_pub_ = create_publisher<std_msgs::msg::Bool>("/control/wheel_target_reached", 10);
    tracking_path_pub_ = create_publisher<nav_msgs::msg::Path>("/control/tracking_path", 10);
    planning_held_pub_ = create_publisher<std_msgs::msg::Bool>("/control/planning_held", 10);
    arm_joint_feedback_pub_ = create_publisher<sensor_msgs::msg::JointState>("/control/arm_joints", 10);
    wheel_odom_pub_ = create_publisher<nav_msgs::msg::Odometry>("/control/wheel/odom", rclcpp::SensorDataQoS());
    // Raw board IMUs; craft_perception's imu_processor turns them into the chassis yaw rate.
    drive_imu_pub_ = create_publisher<sensor_msgs::msg::Imu>("/control/imu/wheel_clock", rclcpp::SensorDataQoS());
    arm_imu_pub_ = create_publisher<sensor_msgs::msg::Imu>("/control/imu/lm_arm", rclcpp::SensorDataQoS());
    tf_broadcaster_ = std::make_unique<tf2_ros::TransformBroadcaster>(*this);
    planning_hold_sub_ = create_subscription<std_msgs::msg::Bool>(
      "/planning/hold", 10,
      [this](const std_msgs::msg::Bool & msg) {
        planning_watchdog_.observe(msg.data, craft_control::PlanningWatchdog::Clock::now());
        planning_hold_pending_ = planning_hold_pending_ || msg.data;
      });
    task_result_pub_ = create_publisher<TaskResult>("/control/task_result", 10);
    control_status_pub_ = create_publisher<ControlStatus>("/control/status", 10);
    task_sub_ = create_subscription<TaskCommand>("/planning/task_command", 10,
      [this](const TaskCommand &msg) {
        if (pending_tasks_.size() >= 32) {reject(msg, "control command queue full"); return;}
        pending_tasks_.push_back(msg);
      });
    // Manual driving (test/drive/teleop_ros.py): body v [m/s] / omega [rad/s] while no task runs.
    // Only the wheel/clock board has to be healthy, and the planning hold does not apply, so mapping
    // runs without planning or the arm board. Stale input (teleop_timeout_s) stops the wheels.
    teleop_timeout_s_ = declare_parameter("teleop_timeout_s", 0.3);
    teleop_sub_ = create_subscription<geometry_msgs::msg::Twist>("/control/teleop/cmd_vel", 10,
      [this](const geometry_msgs::msg::Twist &msg) {
        if (!std::isfinite(msg.linear.x) || !std::isfinite(msg.angular.z)) return;
        teleop_cmd_ = msg; teleop_at_ = steady_seconds();
      });
    odom_sub_ = create_subscription<nav_msgs::msg::Odometry>("/planning/odom", 10,
      [this](const nav_msgs::msg::Odometry &msg) {
        const double age = (now() - rclcpp::Time(msg.header.stamp, get_clock()->get_clock_type())).seconds();
        if (validate_odom(msg) && age >= -0.01 && age <= odom_timeout_s_) {
          pending_odom_ = msg; odom_at_ = steady_seconds();
        } else {lateral_.clear_odom(); odom_at_.reset();}
      });
    settle_s_ = positive_param("settle_time_s");
    stop_tolerance_ = positive_param("stop_position_tolerance_rad");
    wheel_stop_tolerance_ = positive_param("wheel_stop_tolerance_rad_s");
    task_timeout_s_ = positive_param("task_timeout_s");
    odom_timeout_s_ = positive_param("odom_timeout_s");

    // Control loop timer
    timer_ = create_wall_timer(std::chrono::duration<double>(kDt), [this]() {control_loop();});
  }

private:
  template<std::size_t N>
  std::array<double, N> load_array_param(const std::string & name)
  {
    const auto values = declare_parameter<std::vector<double>>(name);
    if (values.size() != N) {
      throw std::runtime_error(name + " needs " + std::to_string(N) + " values (config/control.yaml)");
    }
    std::array<double, N> result;
    std::copy(values.begin(), values.end(), result.begin());
    return result;
  }

  static void publish_bool(const rclcpp::Publisher<std_msgs::msg::Bool>::SharedPtr & pub, bool value)
  {
    std_msgs::msg::Bool msg;
    msg.data = value;
    pub->publish(msg);
  }

  double positive_param(const std::string & name)
  {
    const auto value = declare_parameter<double>(name, 0.0);
    if (!std::isfinite(value) || value <= 0.0) {
      throw std::runtime_error(name + " must be finite and > 0 (config/control.yaml)");
    }
    return value;
  }

  bool read_arm_lm_feedback()
  {
    if (!arm_lm_serial_) return false;
    const auto lines = arm_lm_serial_->read_lines();

    for (auto it = lines.rbegin(); it != lines.rend(); ++it) { // reverse order: newest first
      const auto & line = *it;
      std::vector<double> v;

      // Validate the line: must be CSV, correct number of values, all finite
      // LM + four arm motors + gripper + state + current + imu_ok, gx, gy, gz, ax, ay, az
      if (!parse_csv(line, v) || v.size() != 15)
      {
        RCLCPP_WARN_THROTTLE(get_logger(), *get_clock(), 1000, "bad arm+LM OpenCR line: %s", line.c_str());
        continue;
      }
      if (!std::all_of(v.begin(), v.end(), [](double value) {
        return std::isfinite(value);
      }))
      {
        RCLCPP_WARN_THROTTLE(get_logger(), *get_clock(), 1000, "non-finite arm+LM OpenCR feedback: %s", line.c_str());
        continue;
      }

      // Parse the line: slide, shoulder, elbow, wrist_pitch, tool_roll, gripper, arm_lm_state, gripper_current_a
      lm_angle_ = v[0];
      arm_joints_[0] = v[1];  // shoulder
      arm_joints_[1] = v[2];  // elbow
      arm_joints_[2] = v[3];  // wrist pitch
      arm_joints_[3] = v[4];  // tool roll
      gripper_angle_ = v[5];
      arm_lm_state_ = static_cast<int>(v[6]);
      gripper_current_a_ = v[7];
      publish_board_imu(arm_imu_pub_, v, 8, "lm_arm_imu");

      have_arm_lm_feedback_ = true; // 정상 arm+LM 피드백을 한 번이라도 받은 적이 있는가
      return true;
    }
    return false;
  }

  bool read_clock_wheel_feedback()
  {
    const auto lines = clock_wheel_serial_->read_lines();

    for (auto it = lines.rbegin(); it != lines.rend(); ++it) { // reverse order: newest first
      const auto & line = *it;
      std::vector<double> v;

      // Validate the line: must be CSV, contain twelve values, and contain only finite numbers.
      // 12: wheel_l, wheel_r, clock, wheel_state, clock_state, imu_ok, gx, gy, gz, ax, ay, az
      if (!parse_csv(line, v) || v.size() != 12) {
        RCLCPP_WARN_THROTTLE(get_logger(), *get_clock(), 1000, "bad clock+wheel OpenCR line: %s", line.c_str());
        continue;
      }
      if (!std::all_of(v.begin(), v.end(), [](double value) {
        return std::isfinite(value);
      }))
      {
        RCLCPP_WARN_THROTTLE(
          get_logger(), *get_clock(), 1000,
          "non-finite clock+wheel OpenCR feedback: %s", line.c_str());
        continue;
      }

      // Parse the line: wheel_l, wheel_r, clock, wheel_state, clock_state.
      wheel_left_feedback_ = v[0];
      wheel_right_feedback_ = v[1];
      clock_angle_ = v[2];
      wheel_state_ = static_cast<int>(v[3]);
      clock_state_ = static_cast<int>(v[4]);

      drive_gyro_z_ = v[5] != 0.0 ? std::optional<double>(v[8]) : std::nullopt;  // imu_ok, raw gz
      have_clock_wheel_feedback_ = true; // 정상 clock & wheel 피드백을 한 번이라도 받은 적이 있는가
      publish_board_imu(drive_imu_pub_, v, 5, "wheel_clock_imu");
      return true;
    }
    return false;
  }

  bool validate_arm_target(const sensor_msgs::msg::JointState & msg)
  {
    // Validate the mapping and incoming joint target.
    if (!arm_ik_mapping_confirmed_) {
      return false;
    }
    if (!arm_controller_.is_valid_target(msg.name, msg.position)) {
      RCLCPP_WARN(get_logger(), "invalid rotational arm joint target: holding position");
      return false;
    }
    return true;
  }

  void set_arm_target(const sensor_msgs::msg::JointState & msg)
  {
    // Store the validated target; motor conversion and transmission happen in control_loop().
    craft_control::ArmIkJointValues target;
    std::copy(msg.position.begin(), msg.position.end(), target.begin());
    arm_controller_.set_target(target);
    publish_bool(arm_target_reached_pub_, false);
  }

  void clear_arm_target()
  {
    // Invalid target: stop at the current position until planning sends a new target.
    arm_controller_.clear_target();
    publish_bool(arm_target_reached_pub_, false);
  }

  bool validate_lm_target(const std::string & joint_name, double position)
  {
    // Validate only the LM target; its calibration does not gate the rotational arm.
    if (!lm_mapping_confirmed_) {
      return false;
    }
    if (!lm_controller_.is_valid_target(joint_name, position)) {
      RCLCPP_WARN(get_logger(), "invalid LM target or incomplete LM calibration: holding position");
      return false;
    }
    return true;
  }

  void set_lm_target(double position)
  {
    // Store the validated linear target; motor-angle conversion happens in control_loop().
    lm_controller_.set_target(position);
    publish_bool(lm_target_reached_pub_, false);
  }

  void clear_lm_target()
  {
    // Invalid target: stop at the current position until planning sends a new target.
    lm_controller_.clear_target();
    publish_bool(lm_target_reached_pub_, false);
  }

  bool validate_gripper_target()
  {
    // Open/close is always well-formed; configure() succeeded in the constructor.
    return gripper_mapping_confirmed_;
  }

  void set_gripper_target(bool close)
  {
    // Store the validated target; angle selection and clamping happen in control_loop().
    gripper_controller_.set_target(close);
    publish_bool(gripper_target_reached_pub_, false);
  }

  bool validate_wheel_target(double velocity)
  {
    if (!longitudinal_.is_valid_target(velocity)) {
      RCLCPP_WARN(get_logger(), "non-finite wheel target velocity: stopping");
      return false;
    }
    return true;
  }

  void set_wheel_target(double velocity)
  {
    // Store the validated target; wheel-speed conversion happens in control_loop().
    wheel_target_v_ = velocity;
  }

  void clear_wheel_target()
  {
    // Invalid target: stop until planning sends a new velocity.
    wheel_target_v_ = 0.0;
  }

  bool validate_path_target(const nav_msgs::msg::Path & path)
  {
    // An empty path is planning's "no route" result: stop without a warning.
    if (path.poses.empty()) {
      return false;
    }
    if (!lateral_.is_valid_target(path)) {
      RCLCPP_WARN(get_logger(), "invalid wheel path (coordinates or frame_id): stopping");
      return false;
    }
    return true;
  }

  void set_path_target(const nav_msgs::msg::Path & path, bool require_heading)
  {
    // Store the validated path revision and publish its tracking geometry.
    lateral_.set_target(path, require_heading);
    tracking_path_pub_->publish(lateral_.target_path());
    if (path.poses != last_path_poses_) {
      last_path_poses_ = path.poses;
      publish_bool(wheel_target_reached_pub_, false);
    }
  }

  void clear_path_target()
  {
    // Invalid or empty path: stop until planning sends a new path.
    lateral_.clear_target();
    tracking_path_pub_->publish(lateral_.target_path());
    if (!last_path_poses_.empty()) {
      last_path_poses_.clear();
      publish_bool(wheel_target_reached_pub_, false);
    }
  }

  // Dead-reckon odom->base_link from wheel feedback; gaps longer than the feedback timeout
  // are not integrated (the robot state across the gap is unknown).
  void publish_wheel_odometry(double now_s, double max_gap_s)
  {
    if (wheel_odom_at_ && now_s - *wheel_odom_at_ <= max_gap_s) {
      wheel_odometry_.update(wheel_left_feedback_, wheel_right_feedback_, now_s - *wheel_odom_at_);
    }
    wheel_odom_at_ = now_s;
    nav_msgs::msg::Odometry odom;
    odom.header.stamp = now();
    odom.header.frame_id = odom_frame_;
    odom.child_frame_id = base_frame_;
    odom.pose.pose.position.x = wheel_odometry_.x();
    odom.pose.pose.position.y = wheel_odometry_.y();
    odom.pose.pose.orientation.z = std::sin(wheel_odometry_.yaw() / 2.0);
    odom.pose.pose.orientation.w = std::cos(wheel_odometry_.yaw() / 2.0);
    odom.twist.twist.linear.x = wheel_odometry_.linear();
    odom.twist.twist.angular.z = wheel_odometry_.angular();
    odom.pose.covariance[0] = odom.pose.covariance[7] = odom.pose.covariance[35] = 1e3;  // dead reckoning
    const bool still = std::abs(wheel_left_feedback_) <= wheel_stop_tolerance_ &&
      std::abs(wheel_right_feedback_) <= wheel_stop_tolerance_;
    const bool was_slipping = slip_monitor_.slipping();
    const double k = slip_monitor_.update(now_s, wheel_odometry_.angular(), drive_gyro_z_, still) ?
      slip_variance_scale_ : 1.0;
    if (slip_monitor_.slipping() != was_slipping) {
      RCLCPP_INFO(get_logger(), "wheel slip %s (wheel odometry variance x%.0f)",
        slip_monitor_.slipping() ? "detected" : "over", k);
    }
    odom.twist.covariance[0] = k * wheel_vx_variance_;
    odom.twist.covariance[7] = k * wheel_vx_variance_;  // nonholonomic vy = 0
    odom.twist.covariance[35] = k * wheel_vyaw_variance_;
    wheel_odom_pub_->publish(odom);
    if (!publish_odom_tf_) {return;}  // robot_localization owns odom->base_link
    geometry_msgs::msg::TransformStamped tf;
    tf.header = odom.header;
    tf.child_frame_id = base_frame_;
    tf.transform.translation.x = odom.pose.pose.position.x;
    tf.transform.translation.y = odom.pose.pose.position.y;
    tf.transform.rotation = odom.pose.pose.orientation;
    tf_broadcaster_->sendTransform(tf);
  }

  // One board's IMU fields from index first: imu_ok, gx, gy, gz [rad/s], ax, ay, az [g], raw board
  // frame (gyro offset included). Published as received, accel in m/s^2; nothing when imu_ok=0.
  void publish_board_imu(
    const rclcpp::Publisher<sensor_msgs::msg::Imu>::SharedPtr & pub, const std::vector<double> & v,
    std::size_t first, const char * frame)
  {
    if (v[first] == 0.0) {
      RCLCPP_WARN_THROTTLE(get_logger(), *get_clock(), 5000, "%s: OpenCR IMU not connected", frame);
      return;
    }
    constexpr double kGravity = 9.80665;
    sensor_msgs::msg::Imu imu;
    imu.header.stamp = now();
    imu.header.frame_id = frame;
    imu.orientation_covariance[0] = -1.0;  // no orientation
    imu.angular_velocity.x = v[first + 1];
    imu.angular_velocity.y = v[first + 2];
    imu.angular_velocity.z = v[first + 3];
    imu.linear_acceleration.x = v[first + 4] * kGravity;
    imu.linear_acceleration.y = v[first + 5] * kGravity;
    imu.linear_acceleration.z = v[first + 6] * kGravity;
    pub->publish(imu);
  }

  bool validate_odom(const nav_msgs::msg::Odometry & odom)
  {
    if (!lateral_.is_valid_odom(odom)) {
      RCLCPP_WARN(get_logger(), "invalid wheel odometry: stopping");
      return false;
    }
    return true;
  }

  bool validate_clock_target(int slot)
  {
    if (!clock_controller_.is_valid_target(slot)) {
      RCLCPP_WARN(get_logger(), "invalid clock target: slot must be 1..%d; holding position", clock_slot_count_);
      return false;
    }
    return true;
  }

  void set_clock_target(int slot)
  {
    // Store the validated slot; the shortest turn is chosen from fresh feedback.
    clock_controller_.set_target(slot, clock_angle_);
    clock_target_sent_ = false;
    publish_bool(clock_target_reached_pub_, false);
  }

  void clear_clock_target()
  {
    // Invalid target: stop at the current position until planning sends a new slot.
    clock_controller_.clear_target();
    clock_target_sent_ = false;
    publish_bool(clock_target_reached_pub_, false);
  }

  void clear_planning_targets()
  {
    clear_arm_target();
    clear_lm_target();
    gripper_controller_.clear_target();
    publish_bool(gripper_target_reached_pub_, false);
    publish_bool(gripper_grasped_pub_, false);
    clear_wheel_target();
    longitudinal_.clear_target();
    clear_path_target();
    lateral_.clear_odom();
    clear_clock_target();
  }

  void clear_targets_for_new_task()
  {
    // Keep the manipulator's last arm/LM/gripper targets across tasks. Clearing them makes the
    // arm hold its measured pose, which sits below the target by the gravity sag (it drops each
    // task), and releases a closed gripper. STOP/hold/fault still clear everything.
    clear_wheel_target();
    longitudinal_.clear_target();
    clear_path_target();
    lateral_.clear_odom();
    clear_clock_target();
  }

  void discard_pending_targets()
  {
    pending_odom_.reset();
  }

  void publish_arm_joint_feedback()
  {
    if (!arm_ik_mapping_confirmed_ || !lm_mapping_confirmed_) {
      return;
    }
    const auto positions = arm_controller_.get_joint_positions(arm_joints_);
    const auto lm_position = lm_controller_.get_joint_position(lm_angle_);
    if (!positions || !lm_position) {
      return;
    }
    sensor_msgs::msg::JointState msg;
    msg.header.stamp = now();
    msg.header.frame_id = "base_link";
    msg.name.push_back(lm_controller_.get_joint_name());
    const auto & names = arm_controller_.get_joint_names();
    msg.name.insert(msg.name.end(), names.begin(), names.end());
    msg.position.push_back(*lm_position);
    msg.position.insert(msg.position.end(), positions->begin(), positions->end());
    arm_joint_feedback_pub_->publish(msg);
  }

  static double steady_seconds() {
    return std::chrono::duration<double>(std::chrono::steady_clock::now().time_since_epoch()).count();
  }
  void update_settle(std::vector<double> &anchor, const std::vector<double> &sample,
                     double &since, double at) {
    bool moved = anchor.size() != sample.size();
    if (!moved) for (size_t i = 0; i < sample.size(); ++i)
      moved = moved || std::abs(sample[i] - anchor[i]) > stop_tolerance_;
    if (moved) {anchor = sample; since = at;}
  }
  void reject(const TaskCommand &msg, const std::string &reason) {
    TaskResult r; r.header.stamp = now(); r.task_id = msg.task_id; r.revision = msg.revision;
    r.status = TaskResult::REJECTED; r.reason = reason; task_result_pub_->publish(r);
  }
  void receive_task(const TaskCommand &c, double at, bool hardware_fault) {
    if (c.operation == TaskCommand::STOP) {
      // ID zero is an all-axis stop when no task was dispatched yet.
      if (c.task_id && c.task_id != task_.result.task_id) {reject(c, "unknown stop task"); return;}
      task_.stop(); task_hold_ = true;
      clear_planning_targets(); return;
    }
    if (!c.task_id || !c.revision) {reject(c, "task ID/revision must be nonzero"); return;}
    if (c.operation == TaskCommand::EXECUTE && c.task_id == task_.result.task_id) {
      task_result_pub_->publish(task_.result); return; // no re-execution, including terminal tasks
    }
    const bool update = c.operation == TaskCommand::UPDATE_PATH;
    if (update && (!task_.running() || c.task_id != task_.result.task_id ||
        task_.kind != TaskCommand::NAVIGATE || c.kind != TaskCommand::NAVIGATE)) {
      // Late updates after completion cannot revive an old path.
      if (c.task_id == task_.result.task_id) task_result_pub_->publish(task_.result);
      else reject(c, "no matching navigation task");
      return;
    }
    if (update && c.revision <= task_.result.revision) return;
    if (!update && (c.operation != TaskCommand::EXECUTE || task_.running() || task_.stopping() ||
                    c.task_id <= last_task_id_)) {reject(c, "busy, invalid operation or retired task ID"); return;}
    if (planning_held_ || hardware_fault || planning_watchdog_.held(craft_control::PlanningWatchdog::Clock::now())) {
      reject(c, "control is held or unavailable"); return;
    }
    if (!arm_enabled_ && (c.kind == TaskCommand::MANIPULATOR || c.kind == TaskCommand::GRIPPER)) {
      reject(c, "arm disabled (arm_enabled:=false)"); return;
    }
    sensor_msgs::msg::JointState arm;
    bool valid = false;
    std::array<bool, 5> participants{};
    switch (c.kind) {
      case TaskCommand::NAVIGATE:
        valid = validate_path_target(c.path) && validate_wheel_target(c.speed) &&
          (update ? c.speed >= 0 : c.speed > 0);
        participants[2] = true; break;
      case TaskCommand::MANIPULATOR:
        if (c.joints.name.size() == 5 && c.joints.position.size() == 5) {
          arm.name.assign(c.joints.name.begin()+1, c.joints.name.end());
          arm.position.assign(c.joints.position.begin()+1, c.joints.position.end());
          valid = validate_arm_target(arm) && validate_lm_target(c.joints.name[0], c.joints.position[0]);
        }
        participants[0] = participants[1] = true; break;
      case TaskCommand::GRIPPER: valid = validate_gripper_target(); participants[4] = true; break;
      case TaskCommand::CLOCK: valid = validate_clock_target(c.clock_slot); participants[3] = true; break;
      case TaskCommand::WAIT: valid = std::isfinite(c.duration_s) && c.duration_s >= 0; break;
    }
    if (update && valid) {
      // Planning sends one A*+arc segment (up to a STOP_TURN corner) per task, so a replan around a new
      // obstacle may end the segment at a different corner: only the frame has to match.
      const auto &old = lateral_.target_path();
      valid = !old.poses.empty() && c.path.header.frame_id == old.header.frame_id;
    }
    if (!valid) {
      if (update) {task_.fail("invalid path update"); task_hold_ = true;}
      else reject(c, "invalid task target/calibration");
      return;
    }
    if (!update) {
      clear_targets_for_new_task();
      task_.begin(c, participants); last_task_id_ = c.task_id; task_at_ = at;
      arm_stable_at_ = clock_stable_at_ = at;
    } else task_.result.revision = c.revision;
    switch (c.kind) {
      case TaskCommand::NAVIGATE: set_path_target(c.path, c.require_goal_heading); set_wheel_target(c.speed); break;
      case TaskCommand::MANIPULATOR: set_arm_target(arm); set_lm_target(c.joints.position[0]); break;
      case TaskCommand::GRIPPER: set_gripper_target(c.close); break;
      case TaskCommand::CLOCK: set_clock_target(c.clock_slot); break;
      case TaskCommand::WAIT: wait_duration_ = c.duration_s; break;
    }
  }

  void control_loop()
  {
    const auto t = craft_control::PlanningWatchdog::Clock::now();
    const double elapsed = last_t_ ? std::chrono::duration<double>(t - *last_t_).count() : kDt;
    const double dt = elapsed > 0.0 ? elapsed : kDt;
    last_t_ = t;

    const bool arm_lm_feedback_updated = read_arm_lm_feedback();
    const bool clock_wheel_feedback_updated = read_clock_wheel_feedback();
    if (arm_lm_feedback_updated) {
      arm_feedback_watchdog_.observe(t);
    }
    if (clock_wheel_feedback_updated) {
      clock_wheel_feedback_watchdog_.observe(t);
    }
    const bool arm_feedback_fresh = arm_feedback_watchdog_.fresh(t);
    const bool clock_wheel_feedback_fresh = clock_wheel_feedback_watchdog_.fresh(t);
    const int arm_reported_state = arm_feedback_fresh ? arm_lm_state_ : 2;
    const int wheel_reported_state = clock_wheel_feedback_fresh ? wheel_state_ : 2;
    const int clock_reported_state = clock_wheel_feedback_fresh ? clock_state_ : 2;
    const bool hardware_fault = (arm_enabled_ && arm_reported_state == 2) ||
      wheel_reported_state == 2 || clock_reported_state == 2;
    const double now_s = steady_seconds();
    if (arm_lm_feedback_updated) {
      arm_received_at_ = now_s;
      update_settle(arm_anchor_, {lm_angle_, arm_joints_[0], arm_joints_[1], arm_joints_[2],
                                arm_joints_[3], gripper_angle_}, arm_stable_at_, now_s);
    }
    if (clock_wheel_feedback_updated) {
      publish_wheel_odometry(now_s, serial_timeout_s_);
      drive_received_at_ = now_s;
      update_settle(clock_anchor_, {clock_angle_}, clock_stable_at_, now_s);
    }
    if (clock_wheel_feedback_updated &&
        (std::abs(wheel_left_feedback_) > wheel_stop_tolerance_ ||
         std::abs(wheel_right_feedback_) > wheel_stop_tolerance_)) clock_stable_at_ = now_s;
    const bool odom_stale = task_.running() && task_.kind == TaskCommand::NAVIGATE &&
      (!odom_at_ || now_s - *odom_at_ > odom_timeout_s_);
    if (task_.running() && (hardware_fault || odom_stale || now_s - task_at_ > task_timeout_s_)) {
      task_.fail(hardware_fault ? "serial feedback or board fault" : odom_stale ? "odometry timeout" : "task timeout");
      task_hold_ = true;
    }
    while (!pending_tasks_.empty()) {
      auto msg = std::move(pending_tasks_.front()); pending_tasks_.pop_front();
      receive_task(msg, now_s, hardware_fault);
    }
    if (task_.running() && (planning_watchdog_.held(t) || planning_hold_pending_)) {
      task_.stop(); task_hold_ = true;
    }
    const bool held = planning_watchdog_.held(t) || hardware_fault || planning_hold_pending_ || task_hold_;
    planning_hold_pending_ = false;
    if (held) {
      discard_pending_targets();
      if (!planning_held_) {
        // Clear once on entry. Releasing hold cannot revive any previously stored target.
        clear_planning_targets();
      }
    }
    if (held && !planning_held_) {arm_stable_at_ = clock_stable_at_ = now_s;}
    planning_held_ = held;
    arm_tx_ok_ = drive_tx_ok_ = false;
    publish_bool(planning_held_pub_, planning_held_);

    if (pending_odom_) {
      lateral_.set_odom(*pending_odom_);
      pending_odom_.reset();
    }
    if (have_arm_lm_feedback_) {
      if (arm_lm_feedback_updated && arm_lm_state_ != 2) {
        publish_arm_joint_feedback();
        gripper_controller_.update_current_feedback(gripper_current_a_, dt, gripper_angle_);
        std_msgs::msg::Bool grasped_msg;
        grasped_msg.data = gripper_controller_.is_grasped();
        gripper_grasped_pub_->publish(grasped_msg);
      }

      const auto arm_motor_commands = arm_controller_.compute_command(arm_joints_);
      const double lm_motor_command = lm_controller_.compute_command(lm_angle_);
      const double gripper_motor_command = gripper_controller_.compute_command(gripper_angle_);
      // Shared OpenCR transport only: independent controllers, fixed hardware channel order.
      // A stale board must expire its firmware watchdog and hold its own measured position.
      const bool command_sent = arm_feedback_fresh && arm_lm_serial_->write_values({
          lm_motor_command, arm_motor_commands[0], arm_motor_commands[1],
          arm_motor_commands[2], arm_motor_commands[3], gripper_motor_command});
      arm_tx_ok_ = command_sent;
      if (arm_feedback_fresh && !command_sent) {
        RCLCPP_WARN_THROTTLE(get_logger(), *get_clock(), 1000, "arm+LM OpenCR write failed");
      } else if (command_sent && arm_lm_feedback_updated) {
        // Diagnostic feedback; task completion is aggregated by ControlMaster below.
        publish_bool(arm_target_reached_pub_,
          arm_lm_state_ != 2 && arm_controller_.is_target_reached(arm_joints_));
        publish_bool(lm_target_reached_pub_,
          arm_lm_state_ != 2 && lm_controller_.is_target_reached(lm_angle_));
        publish_bool(gripper_target_reached_pub_,
          arm_lm_state_ != 2 && gripper_controller_.is_target_reached(gripper_angle_));
      }
      std_msgs::msg::Int32 msg;
      msg.data = arm_reported_state;
      arm_lm_state_pub_->publish(msg);
      if (arm_reported_state == 2) {
        publish_bool(arm_target_reached_pub_, false);
        publish_bool(lm_target_reached_pub_, false);
        publish_bool(gripper_target_reached_pub_, false);
        publish_bool(gripper_grasped_pub_, false);
      }
    }

    if (have_clock_wheel_feedback_) {
      if (lateral_.can_track(wheel_target_v_)) {
        longitudinal_.set_target(wheel_target_v_);
      } else {
        longitudinal_.clear_target();  // no valid path/odom, or already at the path goal
      }
      // Host converts planning targets and applies safety limits only. OpenCR firmware configures
      // DYNAMIXEL Profile Acceleration and owns velocity PID/feedforward and motor-level tracking.
      const auto v = longitudinal_.compute_command();
      const double linear_speed = wheel_radius_ * (v[0] + v[1]) / 2.0;
      const auto w = lateral_.compute_command(linear_speed, wheel_target_v_);
      double wl = v[0] + w[0];  // [rad/s]
      double wr = v[1] + w[1];
      const bool teleop = !task_.running() && now_s - teleop_at_ <= teleop_timeout_s_ &&
        wheel_reported_state != 2 && clock_reported_state != 2;
      if (teleop) {
        const double tv = std::clamp(teleop_cmd_.linear.x, -max_v_, max_v_);
        const double delta = teleop_cmd_.angular.z * lateral_.effective_separation() / (2.0 * wheel_radius_);
        wl = tv / wheel_radius_ - delta;
        wr = tv / wheel_radius_ + delta;
      }
      if (teleop != teleop_active_) {
        RCLCPP_INFO(get_logger(), teleop ? "teleop driving" : "teleop stopped");
        teleop_active_ = teleop;
      }
      // over wheel limit: scale both by the same ratio to keep curvature
      const double k = std::max({1.0, std::abs(wl) / max_wheel_, std::abs(wr) / max_wheel_});
      const double clock_motor_command = clock_controller_.compute_command(clock_angle_);
      const bool command_sent = clock_wheel_feedback_fresh &&
        clock_wheel_serial_->write_values({wl / k, wr / k, clock_motor_command});
      drive_tx_ok_ = command_sent;
      if (clock_wheel_feedback_fresh && !command_sent) {
        RCLCPP_WARN_THROTTLE(get_logger(), *get_clock(), 1000, "clock+wheel OpenCR write failed");
      }
      if (command_sent && !planning_held_) {
        clock_target_sent_ = true;
      }
      const bool board_faulted = wheel_reported_state == 2 || clock_reported_state == 2;
      if (board_faulted) {
        clock_target_sent_ = false;
      }
      publish_bool(wheel_target_reached_pub_, !board_faulted && lateral_.is_target_reached());
      std_msgs::msg::Int32 wheel_state_msg;
      wheel_state_msg.data = wheel_reported_state;
      wheel_state_pub_->publish(wheel_state_msg);
      std_msgs::msg::Int32 clock_state_msg;
      clock_state_msg.data = clock_reported_state;
      clock_state_pub_->publish(clock_state_msg);
      if (clock_wheel_feedback_updated) {
        std_msgs::msg::Int32 slot_msg;
        slot_msg.data = !board_faulted && clock_state_ == 0 ?
          clock_controller_.get_current_slot(clock_angle_) : 0;
        clock_slot_pub_->publish(slot_msg);
        std_msgs::msg::Bool reached_msg;
        reached_msg.data = clock_target_sent_ && command_sent &&
          clock_state_ == 0 && clock_controller_.is_target_reached(clock_angle_);
        clock_target_reached_pub_->publish(reached_msg);
      }
      if (!clock_wheel_feedback_fresh) {
        publish_bool(wheel_target_reached_pub_, false);
        publish_bool(clock_target_reached_pub_, false);
        std_msgs::msg::Int32 slot_msg;
        slot_msg.data = 0;
        clock_slot_pub_->publish(slot_msg);
      }
    }
    const bool arm_settled = !arm_enabled_ || (arm_feedback_fresh && arm_tx_ok_ && arm_lm_state_ == 0 &&
      arm_received_at_ - arm_stable_at_ >= settle_s_);
    const bool drive_settled = clock_wheel_feedback_fresh && drive_tx_ok_ &&
      wheel_state_ == 0 && clock_state_ == 0 && drive_received_at_ - clock_stable_at_ >= settle_s_ &&
      std::abs(wheel_left_feedback_) <= wheel_stop_tolerance_ &&
      std::abs(wheel_right_feedback_) <= wheel_stop_tolerance_;
    const bool stopped = arm_settled && drive_settled;
    if (task_.running()) {
      if ((!arm_tx_ok_ && arm_feedback_fresh) || (!drive_tx_ok_ && clock_wheel_feedback_fresh)) {
        task_.fail("serial command write failed"); task_hold_ = true;
      } else if (now_s - task_at_ >= settle_s_) {
        task_.observe({arm_settled && arm_controller_.is_target_reached(arm_joints_),
                       arm_settled && lm_controller_.is_target_reached(lm_angle_),
                       drive_settled && lateral_.is_target_reached(),
                       drive_settled && clock_target_sent_ && clock_controller_.is_target_reached(clock_angle_),
                       arm_settled && gripper_controller_.is_target_reached(gripper_angle_)},
                      task_.kind != TaskCommand::WAIT || now_s - task_at_ >= wait_duration_);
      }
    }
    if (task_.stopping() && stopped && planning_held_) task_.stopped();
    // A released hold never restores targets. A fresh EXECUTE is required.
    if (stopped && !task_.running() && !task_.stopping()) task_hold_ = false;
    if (task_.result.task_id) {
      task_.result.header.stamp = now();
      task_result_pub_->publish(task_.result);
    }
    ControlStatus status;
    status.header.stamp = now(); status.held = planning_held_; status.stopped = stopped;
    status.fault = hardware_fault || (arm_feedback_fresh && !arm_tx_ok_) ||
      (clock_wheel_feedback_fresh && !drive_tx_ok_);
    status.ready = !status.fault && arm_ik_mapping_confirmed_ && lm_mapping_confirmed_ &&
      gripper_mapping_confirmed_;
    status.reason = status.fault ? "board/serial fault" : status.ready ? "" : "unconfirmed calibration";
    control_status_pub_->publish(status);
  }

  craft_control::TaskTracker task_;
  uint64_t last_task_id_ = 0;
  double task_at_ = 0, wait_duration_ = 0, settle_s_ = 0, stop_tolerance_ = 0;
  double wheel_stop_tolerance_ = 0, task_timeout_s_ = 0, odom_timeout_s_ = 0;
  double arm_stable_at_ = 0, clock_stable_at_ = 0, arm_received_at_ = 0, drive_received_at_ = 0;
  bool task_hold_ = false, arm_tx_ok_ = false, drive_tx_ok_ = false;
  std::vector<double> arm_anchor_, clock_anchor_;
  std::optional<double> odom_at_;
  std::deque<TaskCommand> pending_tasks_;
  rclcpp::Subscription<TaskCommand>::SharedPtr task_sub_;
  rclcpp::Publisher<TaskResult>::SharedPtr task_result_pub_;
  rclcpp::Publisher<ControlStatus>::SharedPtr control_status_pub_;
  craft_control::LongitudinalController longitudinal_;
  craft_control::LateralController lateral_;
  double max_wheel_ = 0.0;
  double wheel_radius_ = 0.0;
  double wheel_target_v_ = 0.0;
  double max_v_ = 0.0;
  geometry_msgs::msg::Twist teleop_cmd_;
  double teleop_at_ = -1e9, teleop_timeout_s_ = 0.3;
  bool teleop_active_ = false;
  rclcpp::Subscription<geometry_msgs::msg::Twist>::SharedPtr teleop_sub_;
  std::vector<geometry_msgs::msg::PoseStamped> last_path_poses_;
  std::optional<nav_msgs::msg::Odometry> pending_odom_;
  std::optional<craft_control::PlanningWatchdog::Clock::time_point> last_t_;
  craft_control::PlanningWatchdog planning_watchdog_;
  craft_control::SerialFeedbackWatchdog arm_feedback_watchdog_;
  craft_control::SerialFeedbackWatchdog clock_wheel_feedback_watchdog_;
  bool planning_held_ = true;
  bool planning_hold_pending_ = false;
  craft_control::ArmController arm_controller_;
  craft_control::LmController lm_controller_;
  craft_control::GripperController gripper_controller_;
  craft_control::ClockController clock_controller_;

  std::unique_ptr<OpencrSerial> arm_lm_serial_;  // null with arm_enabled:=false
  bool arm_enabled_ = true;
  std::unique_ptr<OpencrSerial> clock_wheel_serial_;
  craft_control::ArmJoints arm_joints_{};
  bool arm_ik_mapping_confirmed_ = false;
  std::string lm_linear_joint_name_;
  bool lm_mapping_confirmed_ = false;
  double lm_angle_ = 0.0;
  double gripper_angle_ = 0.0;
  bool gripper_mapping_confirmed_ = false;
  double gripper_current_a_ = 0.0;
  int arm_lm_state_ = 0;
  bool have_arm_lm_feedback_ = false;
  craft_control::WheelOdometry wheel_odometry_;
  std::optional<double> wheel_odom_at_;
  std::string odom_frame_, base_frame_;
  bool publish_odom_tf_ = false;
  double wheel_vx_variance_ = 0.0, wheel_vyaw_variance_ = 0.0;
  rclcpp::Publisher<sensor_msgs::msg::Imu>::SharedPtr drive_imu_pub_, arm_imu_pub_;
  double serial_timeout_s_ = 0.5;
  rclcpp::Publisher<nav_msgs::msg::Odometry>::SharedPtr wheel_odom_pub_;
  std::unique_ptr<tf2_ros::TransformBroadcaster> tf_broadcaster_;
  craft_control::SlipMonitor slip_monitor_;
  double slip_variance_scale_ = 1.0;
  std::optional<double> drive_gyro_z_;
  double wheel_left_feedback_ = 0.0;
  double wheel_right_feedback_ = 0.0;
  double clock_angle_ = 0.0;
  int wheel_state_ = 0;
  int clock_state_ = 0;
  bool have_clock_wheel_feedback_ = false;
  int clock_slot_count_ = 0;
  bool clock_target_sent_ = false;

  rclcpp::Publisher<std_msgs::msg::Int32>::SharedPtr arm_lm_state_pub_;
  rclcpp::Publisher<std_msgs::msg::Bool>::SharedPtr gripper_grasped_pub_;
  rclcpp::Publisher<std_msgs::msg::Int32>::SharedPtr wheel_state_pub_;
  rclcpp::Publisher<std_msgs::msg::Int32>::SharedPtr clock_state_pub_;
  rclcpp::Publisher<std_msgs::msg::Int32>::SharedPtr clock_slot_pub_;
  rclcpp::Publisher<std_msgs::msg::Bool>::SharedPtr clock_target_reached_pub_;
  rclcpp::Publisher<std_msgs::msg::Bool>::SharedPtr arm_target_reached_pub_;
  rclcpp::Publisher<std_msgs::msg::Bool>::SharedPtr lm_target_reached_pub_;
  rclcpp::Publisher<std_msgs::msg::Bool>::SharedPtr gripper_target_reached_pub_;
  rclcpp::Publisher<std_msgs::msg::Bool>::SharedPtr wheel_target_reached_pub_;
  rclcpp::Publisher<nav_msgs::msg::Path>::SharedPtr tracking_path_pub_;
  rclcpp::Publisher<std_msgs::msg::Bool>::SharedPtr planning_held_pub_;
  rclcpp::Publisher<sensor_msgs::msg::JointState>::SharedPtr arm_joint_feedback_pub_;
  rclcpp::Subscription<std_msgs::msg::Bool>::SharedPtr planning_hold_sub_;
  rclcpp::Subscription<nav_msgs::msg::Odometry>::SharedPtr odom_sub_;
  rclcpp::TimerBase::SharedPtr timer_;
};

int main(int argc, char ** argv)
{
  rclcpp::init(argc, argv);
  rclcpp::spin(std::make_shared<ControlMaster>());
  rclcpp::shutdown();
  return 0;
}
