Choi-sungjin/pa_craft/src/craft_perception/include/craft_perception/apriltag_reader.hpp

#pragma once
#include <opencv2/core/version.hpp>
#if CV_VERSION_MAJOR > 4 || (CV_VERSION_MAJOR == 4 && CV_VERSION_MINOR >= 7)
#include <opencv2/objdetect/aruco_detector.hpp>
#else
#include <opencv2/aruco.hpp>
#endif
#include <string>
#include <vector>

namespace craft_perception {
struct AprilTagDetection {
  int id = -1;
  cv::Point2f center;
  cv::Rect2f box;
};
// AprilTags sorted left -> right, including image geometry for puck association.
class AprilTagReader {
public:
  bool configure(const std::string &family);  // tag16h5 | tag25h9 | tag36h10 | tag36h11
  bool is_valid_input(const cv::Mat &bgr) const;
  std::vector<AprilTagDetection> compute_result(const cv::Mat &bgr) const;
private:
  cv::Ptr<cv::aruco::Dictionary> dictionary_;
  cv::Ptr<cv::aruco::DetectorParameters> parameters_;
};
}
