Choi-sungjin/pa_craft/demo/puck_pick/plan.yaml

assume:
  lidar_center_x: 0.128
  puck_x_offset: -0.01
  lidar_center_y: 0.0525
  lidar_front_y: 0.034
  lidar_z:
  - 0.02
  - 0.053
  floor_z: 0.0
  hw_z_correction: -0.01
  shelf_size:
  - 0.205
  - 0.208
  shelf_height: 0.07
  puck_ahead: 0.13
  puck_size:
  - 0.03
  - 0.03
  - 0.06
  puck_height: 0.06
  finger_beyond_tcp: 0.015
  finger_clearance: 0.003
  approach_above: 0.04
  grasp_coverage: 0.5833333333333334
  max_tilt_deg: 30.0
  limit_margin_deg: 3.0
  tool_roll: 0.0
  jaw_open: -0.021
  jaw_grip: -0.0018
  lying: false
  tool_tilt_deg: null
  shelf_ahead: null
puck_grasp_urdf:
- 0.11800000000000001
- -0.096
- 0.1
waypoints:
- name: approach
  joints:
    slide_joint: 0.009650000000000006
    shoulder_joint: 0.7209048454559768
    elbow_joint: 1.7131580702640465
    wrist_pitch_joint: 2.24341947962478
    tool_roll_joint: 0.0
    jaw_upper_joint: -0.021
- name: grasp
  joints:
    slide_joint: 0.009650000000000006
    shoulder_joint: 0.7008336764474228
    elbow_joint: 2.1819208036694313
    wrist_pitch_joint: 1.8296345002678356
    tool_roll_joint: 0.0
    jaw_upper_joint: -0.021
- name: close
  joints:
    slide_joint: 0.009650000000000006
    shoulder_joint: 0.7008336764474228
    elbow_joint: 2.1819208036694313
    wrist_pitch_joint: 1.8296345002678356
    tool_roll_joint: 0.0
    jaw_upper_joint: -0.0018
frames:
- &id001
  joints:
    slide_joint: 0.009650000000000006
    shoulder_joint: 0.7209048454559768
    elbow_joint: 1.7131580702640465
    wrist_pitch_joint: 2.24341947962478
    tool_roll_joint: 0.0
    jaw_upper_joint: -0.021
  puck:
  - 0.11800000000000001
  - -0.096
  - 0.1
- *id001
- *id001
- *id001
- *id001
- *id001
- *id001
- *id001
- *id001
- *id001
- *id001
- *id001
- *id001
- *id001
- *id001
- *id001
- *id001
- *id001
- *id001
- *id001
- joints:
    slide_joint: 0.009650000000000006
    shoulder_joint: 0.7209048454559768
    elbow_joint: 1.7131580702640465
    wrist_pitch_joint: 2.24341947962478
    tool_roll_joint: 0.0
    jaw_upper_joint: -0.021
  puck:
  - 0.11800000000000001
  - -0.096
  - 0.1
- joints:
    slide_joint: 0.009650000000000006
    shoulder_joint: 0.7406959694518991
    elbow_joint: 1.6910037132137672
    wrist_pitch_joint: 2.2632360051990803
    tool_roll_joint: 0.0
    jaw_upper_joint: -0.021
  puck:
  - 0.11800000000000001
  - -0.096
  - 0.1
- joints:
    slide_joint: 0.009650000000000006
    shoulder_joint: 0.7371784307466278
    elbow_joint: 1.709065656879043
    wrist_pitch_joint: 2.2486916002390753
    tool_roll_joint: 0.0
    jaw_upper_joint: -0.021
  puck:
  - 0.11800000000000001
  - -0.096
  - 0.1
- joints:
    slide_joint: 0.009650000000000006
    shoulder_joint: 0.7570773353667624
    elbow_joint: 1.6867691079761606
    wrist_pitch_joint: 2.2685425370417667
    tool_roll_joint: 0.0
    jaw_upper_joint: -0.021
  puck:
  - 0.11800000000000001
  - -0.096
  - 0.1
- joints:
    slide_joint: 0.009650000000000006
    shoulder_joint: 0.7536294491157711
    elbow_joint: 1.7047430291044126
    wrist_pitch_joint: 2.2540165021645056
    tool_roll_joint: 0.0
    jaw_upper_joint: -0.021
  puck:
  - 0.11800000000000001
  - -0.096
  - 0.1
- joints:
    slide_joint: 0.009650000000000006
    shoulder_joint: 0.7503418359399301
    elbow_joint: 1.7223180207337394
    wrist_pitch_joint: 2.2397291237110197
    tool_roll_joint: 0.0
    jaw_upper_joint: -0.021
  puck:
  - 0.11800000000000001
  - -0.096
  - 0.1
- joints:
    slide_joint: 0.009650000000000006
    shoulder_joint: 0.7472059280063783
    elbow_joint: 1.7395194933448315
    wrist_pitch_joint: 2.22566355903348
    tool_roll_joint: 0.0
    jaw_upper_joint: -0.021
  puck:
  - 0.11800000000000001
  - -0.096
  - 0.1
- joints:
    slide_joint: 0.009650000000000006
    shoulder_joint: 0.7442140496273588
    elbow_joint: 1.7563702452090213
    wrist_pitch_joint: 2.2118046855483096
    tool_roll_joint: 0.0
    jaw_upper_joint: -0.021
  puck:
  - 0.11800000000000001
  - -0.096
  - 0.1
- joints:
    slide_joint: 0.009650000000000006
    shoulder_joint: 0.7413592949038419
    elbow_joint: 1.7728908221242805
    wrist_pitch_joint: 2.198138863356567
    tool_roll_joint: 0.0
    jaw_upper_joint: -0.021
  puck:
  - 0.11800000000000001
  - -0.096
  - 0.1
- joints:
    slide_joint: 0.009650000000000006
    shoulder_joint: 0.7386354261821857
    elbow_joint: 1.789099815840135
    wrist_pitch_joint: 2.1846537383623685
    tool_roll_joint: 0.0
    jaw_upper_joint: -0.021
  puck:
  - 0.11800000000000001
  - -0.096
  - 0.1
- joints:
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
    slide_joint: 0.009650000000000006
    shoulder_joint: 0.7008336764474228
    elbow_joint: 2.1819208036694313
    wrist_pitch_joint: 1.8296345002678356
    tool_roll_joint: 0.0
    jaw_upper_joint: -0.002810526315789475
  puck:
  - 0.11800000000000001
  - -0.096
  - 0.1
- &id002
  joints:
    slide_joint: 0.009650000000000006
    shoulder_joint: 0.7008336764474228
    elbow_joint: 2.1819208036694313
    wrist_pitch_joint: 1.8296345002678356
    tool_roll_joint: 0.0
    jaw_upper_joint: -0.0017999999999999995
  puck:
  - 0.11800000000000001
  - -0.096
  - 0.1
- *id002
- *id002
- *id002
- *id002
- *id002
- *id002
- *id002
- *id002
- *id002
- *id002
- *id002
- *id002
- *id002
- *id002
- *id002
- *id002
- *id002
- *id002
- *id002
- *id002
- *id002
- *id002
- *id002
- *id002
- *id002
- *id002
- *id002
- *id002
- *id002
- *id002
