Choi-sungjin/pa_craft/demo/puck_pick/plan_lying.yaml

assume:
  lidar_center_x: 0.128
  puck_x_offset: -0.01
  lidar_center_y: 0.0525
  lidar_front_y: 0.034
  lidar_z:
  - 0.02
  - 0.053
  floor_z: 0.0
  hw_z_correction: 0.0
  shelf_size:
  - 0.205
  - 0.208
  shelf_height: 0.07
  puck_ahead: 0.3271866225811162
  puck_size:
  - 0.03
  - 0.06
  - 0.03
  puck_height: 0.03
  finger_beyond_tcp: 0.015
  finger_clearance: 0.003
  approach_above: 0.04
  grasp_coverage: 0.3
  max_tilt_deg: 30.0
  limit_margin_deg: 0.5
  tool_roll: -1.5707963267948966
  jaw_open: -0.021
  jaw_grip: -0.0018
  lying: true
  tool_tilt_deg: 97.37266484931104
  shelf_ahead: 0.39618662258111614
  taught_grasp_motor_deg:
  - 177.4
  - 321.8
  - 345.1
  - 0.0
puck_grasp_urdf:
- 0.11800000000000001
- -0.2661866225811162
- 0.08821246416462998
waypoints:
- name: approach
  joints:
    slide_joint: 0.009650000000000006
    shoulder_joint: 1.6101191766185252
    elbow_joint: 3.4337675253189603
    wrist_pitch_joint: -2.030971324614222
    tool_roll_joint: -1.5707963267948966
    jaw_upper_joint: -0.021
- name: grasp
  joints:
    slide_joint: 0.009650000000000006
    shoulder_joint: 1.8821601540836177
    elbow_joint: 3.323106093432994
    wrist_pitch_joint: -2.192350870193348
    tool_roll_joint: -1.5707963267948966
    jaw_upper_joint: -0.021
- name: close
  joints:
    slide_joint: 0.009650000000000006
    shoulder_joint: 1.8821601540836177
    elbow_joint: 3.323106093432994
    wrist_pitch_joint: -2.192350870193348
    tool_roll_joint: -1.5707963267948966
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
  - 0.085
- *id002
- *id002
- *id002
- *id002
- *id002
- *id002
- *id002
- *id002
- *id002
- *id002
- *id002
- *id002
- *id002
- *id002
- *id002
- *id002
- *id002
- *id002
- *id002
- *id002
- *id002
- *id002
- *id002
- *id002
- *id002
- *id002
- *id002
- *id002
- *id002
- *id002
