Choi-sungjin/pa_craft/demo/v186_pick/plan.yaml

assume:
  lidar_face_x: 0.2098
  lidar_center:
  - 0.19067
  - 0.0
  - 0.0567
  floor_z: -0.034346
  puck_ahead: 0.13
  puck_y: 0.0
  puck_diameter: 0.03
  puck_height: 0.06
  shelf_size:
  - 0.208
  - 0.205
  shelf_height: 0.07
  finger_beyond_tcp: 0.015
  finger_clearance: 0.003
  grasp_coverage: 0.3
  approach_above: 0.04
  max_tilt_deg: 30.0
  collision_margin: 0.003
  limit_margin_deg: 3.0
  tool_roll: 0.0
  jaw_open: 0.012
  jaw_grip: 0.0028
puck_center:
- 0.3398
- 0.0
- 0.065654
grasp_tcp:
- 0.3398
- 0.0
- 0.092654
waypoints:
- name: approach
  lean_deg: 0
  joints:
    lm_slide: 0.0435
    shoulder: 0.12058994654584583
    elbow: 2.9494218122058915
    wrist_pitch: 1.5551108018329527
    tool_roll: 0.0
    jaw_upper: 0.012
    jaw_lower: 0.012
- name: grasp
  lean_deg: -8
  joints:
    lm_slide: 0.0435
    shoulder: 0.26177667869598464
    elbow: 3.055212944606124
    wrist_pitch: 1.4477592774423031
    tool_roll: 0.0
    jaw_upper: 0.012
    jaw_lower: 0.012
- name: close
  lean_deg: -8
  joints:
    lm_slide: 0.0435
    shoulder: 0.26177667869598464
    elbow: 3.055212944606124
    wrist_pitch: 1.4477592774423031
    tool_roll: 0.0
    jaw_upper: 0.0028
    jaw_lower: 0.0028
frames:
- &id001
  joints:
    lm_slide: 0.0435
    shoulder: 0.12058994654584583
    elbow: 2.9494218122058915
    wrist_pitch: 1.5551108018329527
    tool_roll: 0.0
    jaw_upper: 0.012
    jaw_lower: 0.012
  puck:
  - 0.3398
  - 0.0
  - 0.065654
- *id001
- *id001
- *id001
- *id001
- *id001
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
  - 0.0
  - 0.065654
- *id002
- *id002
- *id002
- *id002
- *id002
- *id002
- *id002
- *id002
- *id002
- *id002
- *id002
- *id002
- *id002
- *id002
- *id002
- *id002
- *id002
- *id002
- *id002
- *id002
- *id002
- *id002
- *id002
- *id002
- *id002
- *id002
- *id002
- *id002
- *id002
- *id002
