Choi-sungjin/pa_craft/test/drive/straight.py

#!/usr/bin/env python3
"""Straight drive with heading hold: drive DISTANCE on wheel odometry while steering yaw back to 0.

Same board link and trapezoid as test/slip/slip_test.py (wheel_clock firmware, 50 Hz, clock held); on 4WD
firmware the rear wheels follow their side and the feedback is the side mean (see rotate.py). Yaw is
integrated from the start of the run: IMU (gz minus the offset measured standing still first; the board is
upright) or wheel odometry. Steering is P on yaw: omega = -k * yaw, clamped; wheels = (v -/+ omega * sep / 2) / r.
Keep --accel below the firmware wheel ramp (0.124 m/s^2) so the host trapezoid, not the firmware, shapes
the stop. Tracking is the side's mean feedback / mean command at cruise. After the run the tape distance and
sideways offset can be typed in; every run is appended to logs/straight_results.csv.
Stop control_master first; run through _craft_locked wheel (board lock). Scenario: README.md.

  straight.py [--target 2.0] [--speed 0.1] [--accel 0.1] [--yaw imu|wheel] [--k 2.0] [--note text]
"""
import argparse
import csv
import math
import sys
import time
from datetime import datetime
from pathlib import Path

HERE = Path(__file__).resolve().parent
sys.path.insert(0, str(HERE.parent / 'slip'))
from slip_test import CREEP, HZ, PORT, params  # noqa: E402
from rotate import GZ, Board  # noqa: E402

LOGS = HERE / 'logs'
RESULTS = LOGS / 'straight_results.csv'


def number(prompt):
    while True:
        a = input(prompt).strip()
        if not a:
            return None
        try:
            return float(a)
        except ValueError:
            pass


def main():
    ap = argparse.ArgumentParser(description=__doc__, formatter_class=argparse.RawDescriptionHelpFormatter)
    ap.add_argument('--target', type=float, default=2.0, help='odometry distance [m]')
    ap.add_argument('--speed', type=float, default=0.1, help='cruise speed [m/s]')
    ap.add_argument('--accel', type=float, default=0.1, help='trapezoid slope [m/s^2]')
    ap.add_argument('--yaw', choices=['imu', 'wheel'], default='imu', help='heading source')
    ap.add_argument('--k', type=float, default=2.0, help='yaw P gain [1/s]')
    ap.add_argument('--max-omega', type=float, default=0.5, help='steering clamp [rad/s]')
    ap.add_argument('--note', default='', help='free text for straight_results.csv (4wd/2wd, floor, battery V)')
    ap.add_argument('--port', default=PORT)
    args = ap.parse_args()
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
