Choi-sungjin/pa_craft/(commit log)

2026-10-16 feat: camera resolution from craft_sensors/config/camera.yaml
    - add config/camera.yaml (c310_processor, realsense_processor width/height/fps)
    - install config/ and load camera.yaml for craft_sensors nodes in craft.launch.py
    - keep OpenCV dependency next to realsense2 (c310_processor needs it after merging feature/perception/c310)
2026-10-16 feat: clock planner holding current angle until target is set
2026-10-16 feat: arm planner for 5 arm motors + LM guide with joint limits
2026-10-16 feat: control_master serial bridge to arm/clock OpenCR
    - open two OpenCR serial ports (arm x5 + LM guide, clock + wheel x2)
    - pass OpenCR feedback to arm/clock planners, publish /arm_state, /clock_state (Int32)
    - arm motor limits and ports from craft_control/config/control.yaml
    - move arm/clock planners out of craft_planning
2026-10-16 lidar_processor: LDS-03 x2 병합 → /lidar/merged (FOV·몸체 필터, 퍽 보정)
2026-10-17 Add arm IK and gripper planning integration
2026-10-18 Implement wheel and clock target controllers with YAML configuration
2026-10-18 Delegate wheel acceleration control to DYNAMIXEL firmware
2026-10-18 Integrate KANT path planner with packaged maze.stl map
    - Convert craft_planning to ament_cmake with the KANT A*/arc planner core
    - Load the Gazebo maze.stl (binary, metres, Z-up) as the fixed planning map;
    relative map_file paths resolve against the package share directory
    - Stop subscribing to /map: SLAM is used for localization only
    - Bringup passes planning.yaml and a map_file launch argument (default maps/maze.stl)
    - Add a regression test that plans inside the packaged twin maze
    [maze.stl]
2026-10-18 Unify control_master validation flow and controller interfaces
    - Every planning input: callback keeps the newest message pending, control_loop
    validates it, then set_*_target stores it or clear_*_target stops the axis
    - Invalid targets stop the axis (hold position / zero speed) until replanned
    - Controllers share configure / is_valid_target / set_target / clear_target /
    compute_command / is_target_reached; configuration is validated once at startup,
    so runtime configured_ flags and duplicate checks are removed
    - Add target-reached topics for arm, LM, gripper and wheel with YAML tolerances;
    a newly stored target publishes false immediately
    - Clock, wheel velocity, path and odometry va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
    [clock_controller.cpp, clock_controller.hpp, control.yaml, control_master.cpp, gripper_controller.cpp, gripper_controller.hpp, lateral_controller.cpp, lateral_controller.hpp]
2026-10-18 Name the arm OpenCR board arm_lm like clock_wheel
    The board drives both the rotational arm and the LM, so name it after both,
    matching clock_wheel:
    - control.yaml: arm_port -> arm_lm_port
    - control_master: arm_lm_serial_, read_arm_lm_feedback, have_arm_lm_feedback_,
    arm_lm_state_ and log messages "arm+LM OpenCR"
    - Board state topic /arm_state -> /arm_lm_state (mission_fsm subscriber updated)
2026-10-18 Put shared serial channels first and use 2 degree motor tolerances
    - OpenCR feedback lists the channels shared with the command first, in the same
    order, then board-specific fields:
    arm+LM: slide,shoulder,elbow,wrist_pitch,tool_roll,gripper,arm_lm_state,gripper_current_a
    clock+wheel: wheel_l,wheel_r,clock,wheel_state,clock_state
    - gripper_angle_tolerance 0.05 rad -> 2 degrees, matching arm, LM and clock
    [control.yaml, control_master.cpp]
2026-10-18 Publish control topics under /control/ like /planning/
    All control_master outputs move to the /control/ namespace:
    /control/{arm_lm,wheel,clock}_state, /control/clock_slot, /control/gripper_grasped
    and /control/{arm,lm,gripper,wheel,clock}_target_reached. mission_fsm now
    subscribes to /control/arm_lm_state.
2026-10-19 Resample wheel paths along a cubic spline and publish them
    LateralController fits a natural cubic spline through the planning path
    and resamples it every path_spacing of arc length, so Pure Pursuit's
    lookahead no longer depends on how densely planning samples the path.
    ControlMaster republishes the tracked path on /control/tracking_path.
    [control.yaml, control_master.cpp, lateral_controller.cpp, lateral_controller.hpp, test_control_controllers.cpp]
2026-10-19 Add dual OpenCR firmware and modular C++ perception
    Implement wheel/clock and LM/arm firmware with CSV feedback and watchdog handling. Integrate NCNN perception under a master node with YAML module rates, shared-memory snapshots, and consistent module interfaces.
    [model.ncnn.param]
2026-10-19 feat(perception): obstacle_detector 장애물 인식 - /lidar/merged 클러스터링 -> /lidar/obstacle
2026-10-21 Split perception into D435/C310 classes under PerceptionMaster
    PerceptionMaster now only connects and configures (reading every value from
    perception.yaml) and calls D435Perception / C310Perception member functions,
    like control_master. D435 runs one YOLO shared by knob_depth, object_detector
    and obstacle_detector, plus ArUco and puck_axis (port of puck_axis_live.py with
    its own puck model). C310 runs knob_lever with its own YOLO. Frames and
    detections are passed as shared_ptr; LiDAR obstacle and state estimator are
    unchanged. Standalone camera scripts are removed from the package.
    [model.ncnn.param]
2026-10-21 Use one mutex per perception input instead of a shared data mutex
    camera_info, odometry, LaserScan and the D435 detection result each get their
    own mutex next to the data, so unrelated sensors never wait on each other.
    Lock order (camera mutex before info_mutex_) is documented in the header.
2026-10-21 Rename camera image_offset topics to frame_meta
    /vision/{d435,c310}/image_offset carry the full frame metadata (shm offset,
    size, sequence, stamp, depth unit), not just an offset. Producers and
    perception must be rebuilt together.
2026-10-21 Factor camera task steps into on_frame/on_detection
    Each camera task repeated: take the newest unseen input, check intrinsics,
    compute, drop stale results, publish. Two templates now hold that sequence and
    each task only states what it computes and publishes. Message conversion moved
    to free functions. Behaviour is unchanged.
2026-10-21 Detect AprilTag instead of ArUco markers
    Use OpenCV's built-in AprilTag dictionaries (family set by
    d435.apriltag_family, default tag36h11) with AprilTag corner refinement.
    AprilTagReader replaces ArucoReader; the task, yaml keys and the topic become
    apriltag (/perception/vision/d435/apriltag), and mission_fsm subscribes to it.
    Output format is unchanged: ids sorted left to right.
    [apriltag_reader.hpp, d435_perception.hpp, perception.yaml, perception_master.hpp, test_master_integration.py]
2026-10-21 Add v75_robot_description package with URDF and meshes
    [base_link_black.stl, base_link_green.stl, base_link_orange.stl, base_link_yellow.stl, carousel_link_black.stl, carousel_link_green.stl, carousel_link_orange.stl, elbow_link_black.stl]
2026-10-21 Choose the knob lever mask source (hsv or yolo_seg) in perception.yaml
    c310.knob_lever.lever_source selects the red-HSV heuristic (default) or the
    lever mask of a YOLO-seg model inside each knob box; both share the PCA angle
    step. A third blob name (prototype masks) makes YoloDetector a seg model that
    fills Detection::mask, for ncnn and TensorRT. The launch file now takes
    d435_model_dir and c310_model_dir separately so C310 can run its own model.
2026-10-22 Integrate LiDAR processing module into perception master
2026-10-22 feat(planning): integrate C++ planning master and control watchdogs
    Integrate FSM sequencing, native path planning, headless URDF IK, and planning/control watchdog handshakes. Include the current v75 workspace relocation and presentation assets.
    [base_link_black.stl, base_link_green.stl, base_link_orange.stl, base_link_yellow.stl, carousel_link_black.stl, carousel_link_green.stl, carousel_link_orange.stl, elbow_link_black.stl]
2026-10-22 refactor: tag registry, drop craft_mission, wire wheel odometry
    - Remove craft_mission; PlanningMaster owns mission execution and
    /planning/mission stays as its mission-name input.
    - Shared tag_registry.yaml maps AprilTag ID -> mission or puck number;
    pucks are identified by tag, not color.
    - Drop IMU/wheel/arm encoder stub nodes from craft_sensors.
    - control_master integrates wheel feedback into /wheel/odom and the
    odom->base_link TF; StateEstimator re-expresses it in the map frame
    via slam's map->odom TF so planning accepts it.
2026-10-23 feat: OpenCR IMU + robot_localization dual EKF, SLAM topics under /perception/lidar
    - wheel_clock firmware appends imu_ok,gx,gy,gz,ax,ay,az (MPU9250,
    TurtleBot3 scale factors); control_master publishes /imu/data and
    /wheel/odom with covariances and leaves odom->base_link to the EKF.
    - ekf_local (wheel + IMU) owns odom->base_link; ekf_global (wheel + IMU +
    SLAM pose) owns map->odom. Yaw rate comes from the IMU only (rough floor).
    - Upside-down IMU handled by base_link->imu_link TF (roll = pi) with
    offset launch args.
    - slam_toolbox started directly (real time, no map->odom TF); its outputs
    are remapped to /perception/lidar/*.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
2026-10-23 refactor: control-owned IMU/odom topics under /control, yaw-rate-only IMU
    - /imu/data -> /control/imu/data, /wheel/odom -> /control/wheel/odom.
    - wheel_clock serial feedback is now 7 fields: ...,imu_ok,gz. The EKF only
    fuses yaw rate, so accel and x/y gyro are no longer sent or published.
    - imu_gyro_bias [3] -> imu_gyro_z_bias.
    [config.h, control.yaml, control_master.cpp, ekf.yaml, test_planning_watchdog_integration.py, wheel_clock.ino]
2026-10-26 config: measured hardware calibration, OpenCR udev rules, arm torque relax
    - Firmware: confirmed XM430 IDs/limits for lm_arm and wheel_clock, RELAX/HOLD
    keywords (torque off/on in place), gripper current scale.
    - Control: measured arm joint offsets/directions, LM meters-per-rad mapping,
    gripper grasp squeeze angle, keep arm/LM/gripper targets across new tasks.
    - URDF and meshes resized to measured link lengths; fit_measured.py helper.
    - config/udev: OpenCR rules keyed by USB path (arm/LM 2.1, wheel/clock 2.2.2
    after the 2026-10-26 hardware change) and LiDAR rules for the Jetson.
    - craft_dashboard.sh launch groups, motor axis jog bench test.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
    [base_link_black.stl, base_link_green.stl, base_link_orange.stl, elbow_link_black.stl, jaw_lower_link_black.stl, jaw_lower_link_orange.stl, jaw_upper_link_black.stl, jaw_upper_link_orange.stl]
2026-10-27 arm: measured geometry, 0.5 deg tolerances, least-elbow-load IK, board tooling
    - URDF (both copies): shoulder axis 114 mm above the floor (was 122.25), elbow 187 mm,
    elbow->wrist 95 mm, wrist->tool-roll horn 78 mm, TCP 0.118 (mid usable grip), slide and
    wrist/tool-roll limits from measured motor ranges; meshes refit (fit_measured.py).
    - ArmPlanner: collect every distinct IK solution (seed + fixed-seed restarts) and return the
    one with the least elbow gravity moment, nearest the seed on ties; new branch test, FK
    expectation updated for TCP 0.118 and the 114 mm shoulder.
    - Arm and LM arrival tolerance 0.5 motor deg in firmware lm_arm and control.yaml (kept equal);
    position I gain on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
    [elbow_link_black.stl, shoulder_link_black.stl, shoulder_link_green.stl, shoulder_link_orange.stl, v75_robot.urdf, wrist_pitch_link_black.stl, wrist_pitch_link_orange.stl]
2026-10-27 demo: track puck_pick (sis1 load into clock slot 12, sis2 unload and put down)
    Real-robot demo that drives control_master step by step without planning: plan.py IK and
    plan.yaml, execute.py (--unload: fold the wrist over the slot, grip 3 cm below the loading
    pose, lift straight back with the tool angle kept, release 1 cm above the grasp height),
    RViz preview, and NOTES.md (grasp region, upload/USB troubleshooting, change log).
    Previously excluded via .git/info/exclude.
2026-10-27 lying scenario testing
    [20261027-121418_low_0.05.csv, 20261027-121524_low_0.05.csv, 20261027-121751_low_0.1.csv, 20261027-121907_low_0.05.csv, 20261027-122201_low_0.05.csv, 20261027-124134_low_0.05.csv, 20261027-150358_low_0.05.csv, 20261027-150504_low_0.15.csv]
2026-10-29 perception: slam_toolbox owns map->odom, drop ekf_global, larger scan buffer
    Port of the localization part of test01 b3f1d2d (Jihoon):
    - ekf_local (wheel + IMU) alone publishes odom->base_link; ekf_global removed
    - slam_toolbox publishes map->odom (0.05 s), scans every 0.2 s / 0.01 m / 0.01 rad
    - perception state input /odometry/global -> /odometry/local
    - ekf_local transform_time_offset 0.05 (obstacle TF extrapolation)
    Plus scan_buffer_size 100: with 0.2 s scans the default 10 spans ~2 s, so
    matching chains scan-to-scan and drifts. Virtual 2-lap test (fake wheel slip
    +8 %, IMU bias, ray-cast /lidar/merged): buffer 10 -> 15-20 cm / 8 deg final
    error; buffer 100 -> ~1 cm mean, 3 cm max; old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
    [ekf.yaml, perception.yaml, state_estimator.hpp, test_master_integration.py]
2026-10-29 control, planning: goal tolerance 0.10 m, task timeout 60 s
    From test01 b3f1d2d (Jihoon), real-robot runs 2026-10-26/27:
    - wheel_goal_tolerance / goal_tolerance 0.03 -> 0.10 m: 0.03 is below SLAM
    pose noise, overshoot -> 180 deg turn back
    - task_timeout_s / fsm.execution_timeout_s 30 -> 60 s: timed out on ~3 m legs
    Planning struct defaults follow the yaml.
    [control.yaml, planning.yaml, planning_config.hpp]
2026-10-29 firmware, control: both OpenCRs send raw IMU, control relays it
    - Both boards append imu_ok,gx,gy,gz,ax,ay,az (CraftImu.h): raw gyroRAW/accADC averaged per
    20 ms as floats. The library's gyroADC keeps its power-up zero in whole LSBs and zeroes
    |x| <= 3 LSB, which hid up to ~1 LSB of bias (harness: 1.5 -> 0.3 deg/min drift).
    Lines are now 12 (wheel_clock) and 15 (lm_arm) fields; lm_arm gains an IMU.
    - control_master relays each board raw on /control/imu/{wheel_clock,lm_arm} (board frame,
    accel in m/s^2); processing moves to craft_perception. The roll=pi IMU TF is gone: the
    boards were re-mounted upright, and the mounting is now measured from gravity.
    - Tests: firmware IMU averaging,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
    [config.h, control.yaml, control_master.cpp, lm_arm.ino, slip_test.py, test_firmware.cpp, test_planning_watchdog_integration.py]
2026-10-29 perception, bringup, planning: IMU processor, EKF localization by default, SLAM monitor
    - imu_processor: per board, up axis and gyro offset from gravity while the wheels stand still
    (startup + every stop), zero-velocity update, spike filter at TurtleBot3 Waffle Pi limits
    (1.82 rad/s, 3.2 rad/s^2). wheel_clock is primary, lm_arm only a backup while the primary
    is unavailable; a disagreement is reported, never mixed. -> /perception/imu/data.
    - localization:=ekf is the default: ekf_global fuses the SLAM pose (3 sigma gate, lagged-data
    smoothing); localization:=slam keeps slam_toolbox owning map->odom. SLAM search narrowed
    to +-5 cm / +-5 deg, scan buffer 100, no response expansion (si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
2026-10-29 test: real-robot TODO for IMU and localization, gyro scale experiment
2026-10-29 test: backup IMU switch lives in imu_processor; only a way to cut the primary IMU is missing
2026-10-29 perception: frozen IMU board hands over to the backup, spike-filter drop log
    A board whose raw gyro repeats exactly for 10 samples (0.2 s) is frozen: the firmware sends a
    noisy 4-sample float mean, which never repeats on a live sensor, so a stuck chip or IMU library
    shows up as identical samples. A frozen board is unavailable (the backup takes over) and does not
    feed its bias tracking; it comes back after 10 changing samples. Sim, primary stuck: 1.1 cm
    mean / 2.8 cm max error (was meters, 131 deg yaw). Also logs spike-filter drop counts.
    [imu_processor.hpp, perception.yaml, test_modules.cpp]
2026-10-29 perception: upright OpenCR IMUs, yaw rate is gz minus the gyro offset
    Both boards are mounted upright, so the gravity up-axis calibration is dropped;
    the accelerometer only tells standing from accelerating.
2026-11-03 arm, driving, perception, planning: sis1 one-move steps, reassembly offsets, 4WD, SLAM/corner demo work
    Arm / puck demo (2026-11-03):
    - sis1: one move per step (LM + arm without the shoulder, then the shoulder; load 1 stops the
    shoulder 10 deg before vertical, clock 12 confirmed before load 2; return in two moves)
    - grip 35 mm of the puck, hw_z_correction -10 mm (real TCP ~10 mm above the model)
    - clock_zero_angle 165.5 deg and tool_roll offset 90.9 deg after the hardware reassembly
    - arm position I gain: shoulder 130, wrist_pitch 200 (step-by-step tuning, see config.h)
    - demo/puck_pick/bag_plot.py: per step move / residual / judge time and per joint residual and
    overshoot from a brobag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
    [20261027-121418_low_0.05.csv, 20261027-121524_low_0.05.csv, 20261027-121751_low_0.1.csv, 20261027-121907_low_0.05.csv, 20261027-122201_low_0.05.csv, 20261027-124134_low_0.05.csv, 20261027-150358_low_0.05.csv, 20261027-150504_low_0.15.csv]
2026-11-03 voice: craft_voice node, camera + planning state machine -> GPT -> speech
    - reads D435/C310 frames from craft_sensors shared memory (same checks as
    SharedFrameReader) or a sensor_msgs Image/CompressedImage topic
    - subscribes /planning/state, /planning/diagnostics, /control/status and
    context topics; announces chosen state changes, Fault with its reason
    - OpenAI Responses API (image + state facts, store=false) for the sentence,
    audio/speech (raw PCM -> WAV) for the voice, played with aplay
    - Fault skips GPT, drops older speech and cuts off playback; GPT/TTS
    failures fall back to templates / an optional offline TTS command
    - /voice/ask, /voice/say, /voice/command; GPT calls per minute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
2026-11-03 voice: fault cuts speech still in TTS, quick fault TTS, step and state staleness
    QA review fixes:
    - a fault (or 'stop') now cancels the sentence being synthesized, not only
    one already playing; the player checks the cancel flag under its lock
    right before it starts
    - fault speech asks OpenAI with fault_tts_timeout_s (4 s) and no retry, then
    falls back to fallback_tts_command
    - the step name is used only if diagnostics (1 Hz) arrived after the
    current step's Run.PrepareTask, so Run.Execute no longer names the step
    that just finished
    - a state sentence is dropped if the label changed before it was spoken
    (Run.Complete excepted)
    - fallback TTS strips leading dashes so a sentence can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
2026-11-03 voice: fault never waits for cancelled TTS, state sentences rechecked after TTS
    Second QA review fixes:
    - TTS calls run on a helper thread; a cancelled sentence (fault, stop) is
    abandoned at once and never reaches the fallback TTS
    - fault speech gives up on OpenAI after fault_tts_timeout_s + 1 s even if the
    HTTP timeout does not cover it (e.g. a DNS hang), then uses the fallback
    - a state sentence is dropped after any label change since its event, even
    when the robot comes back to the same label (Execute -> ... -> Execute)
    - staleness is checked again after TTS, right before playing; only
    sentences that went out are published and count for repeat suppression
    - a step start is detecte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
    [voice.yaml]
2026-11-03 voice: speak state on a dead network, refresh stale status, no publish on close
    Third QA review fixes:
    - state sentences are only age-checked when taken off the queue; after TTS
    only "still true" counts, so a slow fallback still says it
    - GPT for a state change gives up after gpt_state_deadline_s (6 s) and uses
    the template; OpenAI speech gives up after tts_deadline_s (8 s) and uses
    the fallback TTS; templates made after a failure start their age then
    - a 'status' answer whose state changed before it went out is replaced once
    by the current state's template
    - Run.PrepareTask always starts a new step (Execute -> PrepareTask when the
    Complete/AwaitRequest samples are lost)
    - nothing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
    [voice.yaml]
2026-11-03 voice: demo QA fixes (camera shutdown race, video pacing, quit, encodings)
    - Camera: only the reader thread touches VideoCapture; close() joins it
    before release (releasing during read() hung or aborted ~1 run in 5)
    - video files play at their own fps and reopen at the end (seeking back
    fails on MPEG-TS, unknown-length WebM, MJPEG)
    - /quit quits even with --keep-running-without-input
    - stdin/stdout/stderr use errors='replace': a broken input byte or a
    cp949/cp1252 console no longer kills the input thread or the main loop
    - a failing on_text/on_speaking callback (print, ROS publish) is logged
    and never stops the speak thread
    - sim: /fault prefixes the current phase and keeps the step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
2026-11-03 voice: demo second-review fixes (MJPEG/GIF as video, queued, Windows quotes)
    - only image extensions are opened as a still picture (imread decoded the
    first frame of raw MJPEG / GIF and froze there); pictures are read with
    imdecode(fromfile) so non-ASCII paths work on Windows
    - sources other than a webcam index reopen at the end; recordings (local
    file or URL with a known length) are paced, live streams are not
    - sim diagnostics 'queued' is 0 in Idle/Ready/Fault/Run.Stopping, like
    planning_master's remaining queue
    - Windows command splitting handles quotes inside an argument
    Claude-Session: https://claude.ai/code/session_01QFKN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
2026-11-03 voice: narrate what the robot is doing and what it sees, not errors
    - while working (Run.*) the robot says "what I am doing + what I see" every
    narrate_period_s (20 s); while idle/ready/stopped narrate_idle_period_s
    (off by default); without a key the same in fixed words
    - what perception sees goes to GPT next to the picture: motion from
    /perception/state/odom, YOLO labels, pucks (standing/lying, distance),
    AprilTag ids; stale after 2 s
    - spoken sentences describe actions ("목표 지점 이동 중이에요") and
    situations; GPT is told never to read state labels or error codes
    - a fault is told as the situation ("제 위치를 놓쳐서 멈춰 있어요"); an
    unknown reason is n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
2026-11-03 voice: narration never outlives the situation it describes
    QA fixes for e42da8f:
    - any change of what the robot does drops and cuts off periodic narration:
    queued, still being written by GPT (cancelled at once), in TTS or
    playing; a narration finishing later is dropped by the state generation
    check, a requested one is replaced by the current facts
    - so narration never delays a state or fault announcement; narration GPT
    gives up after gpt_narrate_deadline_s (10 s) for fixed words
    - periodic narration is not repeat-suppressed (its timer spaces it), so it
    really comes every narrate_period_s without GPT
    - pucks without a depth axis are "자세 모름", not lying at 0.0 m
    - unnamed step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
2026-11-03 voice: state announcements never wait behind requests
    Second QA review of the narration change:
    - GPT jobs are taken announcements first; while GPT answers a question, a
    state change is said at once in fixed words
    - a describe/status answer still being written when the situation changes
    is cancelled and answered at once with the new situation; a refreshed
    answer is rendered when it is said, so quick state changes never leave
    the asker without an answer
    - 'stop' also discards what GPT is writing; refreshed answers respect mute
    - questions get a GPT deadline (gpt_ask_deadline_s, 15 s);
    gpt_narrate_deadline_s and gpt_ask_deadline_s are node parameters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
    [voice.yaml]
2026-11-03 voice: key file template (git-ignored) and a latency bench
    - env/openai.env.example -> copy to env/openai.env (git-ignored) or
    ~/.config/craft_voice/openai.env, or point CRAFT_VOICE_ENV at a file;
    voice_node, demo and bench load it without overriding the shell and
    never print the value
    - python -m craft_voice.bench times "sentence ready -> player starts"
    through the robot's own speak path (tts, to_play, audio length), with
    --gpt also the GPT answer and state change -> player start
    - measured here (no network): own overhead 0.00 s, espeak-ng 0.02 s TTS,
    0.01 s to player start; OpenAI times still to be measured with a key
    Cla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
2026-11-03 voice: faster GPT by default (gpt-6-luna first, reasoning none) + model compare
    - model takes a fastest-first chain: "gpt-6-luna,gpt-5.4-mini,gpt-5.5";
    a model unknown to the key or without image input is skipped once and
    the working one is kept
    - reasoning_effort none by default; if a model rejects it, it steps down
    none -> minimal -> low -> unset instead of dropping to the model default
    - python -m craft_voice.bench --compare "a,b,c" --efforts none,low times
    each model x effort on the robot's real narration prompt with a picture
    (--camera or a drawn arena scene), fastest first, with a sample answer
    - the GPT log line names the model that answered
    The chain order is from third-pa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
    [voice.yaml]
2026-11-03 voice: test pictures (OpenCV samples) and bench over a picture folder
    - test/images: office floor (RGB-D camera), round objects on a floor, boxes;
    from OpenCV samples/data, Apache-2.0, with a README naming the originals
    - bench --camera takes a folder and cycles through its pictures; --compare
    prints each run's time and answer per picture
    Claude-Session: https://claude.ai/code/session_01QFKNczYbYZYJ72QBaGH6QV
2026-11-03 voice: gpt-5.4-mini (reasoning none) as the default model, measured
    Measured 2026-11-03 against OpenAI through the cloud Network secret, with
    the robot's real narration prompt and the three test pictures (median):
    gpt-5.4-mini none 1.02 s (n=6) | gpt-6-luna none 1.59 s | gpt-5.6-luna
    none 1.60 s | gpt-5.5 none 2.47 s, low 1.93 s; low was 0.3-0.5 s slower
    than none for the others.
    gpt-5.4-mini answers are natural and polite; luna describes the picture in
    more detail but is ~0.6 s slower; gpt-5.6-luna mixed speech levels.
    Default chain is now gpt-5.4-mini,gpt-6-luna,gpt-5.5 with reasoning none.
    State change -> player start (GPT sentence with picture + OpenAI TTS)
    with the new default: 2.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
2026-11-03 voice: dice-memory mission awareness (context, step names, demo scenario)
    From the 2026-11-04 mission page (주사위 기억 로봇, arena 4464 x 6364 mm):
    - mission_context: a short description of the mission given to GPT as
    background only (facts still come from topics and sensors)
    - step_names: proposed step ids (read_barcode, observe_signal, count_sort,
    load_S*, allocate, place_L*, verify_L*, return_home) with '*' patterns
    (load_S3 -> 시작 박스 3 퍽 싣기); they must match planning's missions.yaml
    - a step start is announced once its 1 Hz diagnostics name arrives (up to
    step_name_wait_s 1.2 s), so it says "신호등 관측, 시작할게요." instead of
    "작업을 시작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
    [voice.yaml]
2026-11-03 voice: streaming QA fixes (close, failures, chosen speaker, no buffering)
    Review of 99947a6:
    - close() also stops the stream player (a streaming sentence kept playing,
    or the speak thread stayed blocked in write)
    - a write the player does not take within write_timeout_s (5 s, wedged
    device) kills the player; the player's stderr is kept and a failing
    player raises with it
    - a failing stream player is logged, the speech received so far (and the
    rest) is played as one WAV through the normal player, and streaming is
    switched off after two failures in a row; mid-stream stalls are logged
    and not counted as spoken; a failing fallback TTS is logged and counted
    - stream_player_command ""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
    [voice.yaml]
2026-11-03 voice: how-it-works animation page in docs
    src/craft_voice/docs/how_it_works.html: standalone page that plays the
    voice pipeline in nine scenes (camera shm, state machine and step names,
    perception facts, GPT prompt, TTS streaming, speaking order, fault path,
    measured latency). Opens directly in a browser; system fonts when offline.
    README links it.
    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
2026-11-04 voice: GPT sees the frame the state machine's input came from
    planning_master acts on perception inputs (YOLO detections, puck
    observations) whose header.stamp is the camera stamp of the frame they
    were computed from. craft_voice/camera.py copies that exact shm frame as
    soon as such an input arrives (slots are reused in ~0.13 s), keeps it for
    frame_max_age_s, and for a state change hands the narrator the input frame
    the state machine had at that moment; other jobs get the input frame of
    their own time. No match, a reused slot or no perception falls back to the
    newest frame. image_source:=latest keeps the old behaviour.
    The prompt's [카메라] line says which picture it is; /voice/diagnosti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
2026-11-04 voice: input frame QA fixes (retention, busy slot, bad image, launch arg)
    - input frames are kept for frame_max_age_s whatever input_frame_interval_s
    is (pruned by age, at most 64), not a fixed 12 copies
    - a copy that fails because craft_sensors holds the slot lock is retried
    briefly and does not mark the frame as seen, so the other topic's input
    of the same frame can still copy it
    - an unreadable image (cv2.error) never reaches a ROS callback or the
    narrator
    - launch: image_source:=latest is a launch argument
    - test: the thread test's frames no longer overflow uint8 at seq 256 and
    producer errors are reported
    Claude-Session: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
2026-11-04 voice: input frames cover max age, reused slots are not retried
    - copies are at least frame_max_age_s / 63 apart, so the 64 kept copies
    always cover frame_max_age_s (a tiny input_frame_interval_s or a long
    age used to drop the frame of the state change)
    - an input whose slot already holds a newer frame (same offset, newer
    sequence) is counted lost once and not retried; only a copy blocked by
    the writer's lock is retried and counted as input_busy
    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
2026-11-04 voice: a camera restart does not look like reused slots
    craft_sensors counts frame sequences from 0 again after a restart, so the
    old frame_meta of a slot had a bigger sequence than the new frame and every
    new input frame was dropped as "reused" for ~12 frames. A reused slot now
    needs a newer stamp as well. README: input_busy wording.
    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
2026-11-11 voice: microphone, realtime speech, speech cache, recorded reactions, more of the state machine
    - listen.py: the robot answers to its name ("크래프트"), follow-up questions without the name
    - realtime.py / plainclient.py: speech over the Realtime API, a standard-library OpenAI client
    for machines without the SDK
    - prepare.py / wiring.py: fixed sentences are synthesized once and kept (play at once, also offline)
    - recorded reactions by event, notices of its own (long blocked, state signal lost)
    - "뭐 하는 상태야?" is answered by the state machine in fixed words, without GPT
    - a lost state signal is said as lost; GPT is told the last state, the planning reason, the mission,
    the l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
    [voice_robot.yaml]
